cansat-tsniimash/UNKNOWN-2024/doc/KNPN_block diagram of on-board electronics (2).pdf

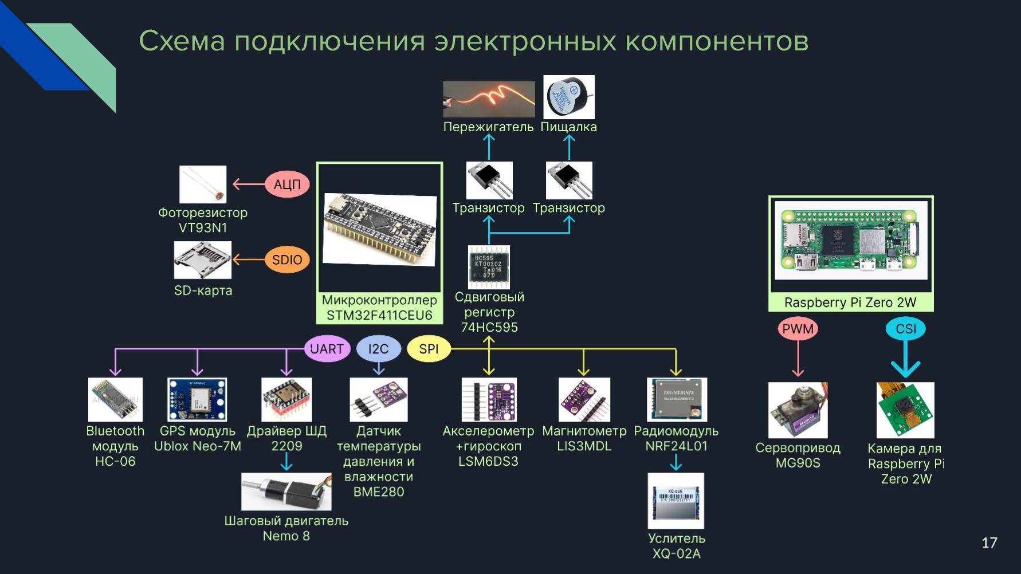
[picture p3: page 1]

17

Схема подключения электронных компонентов

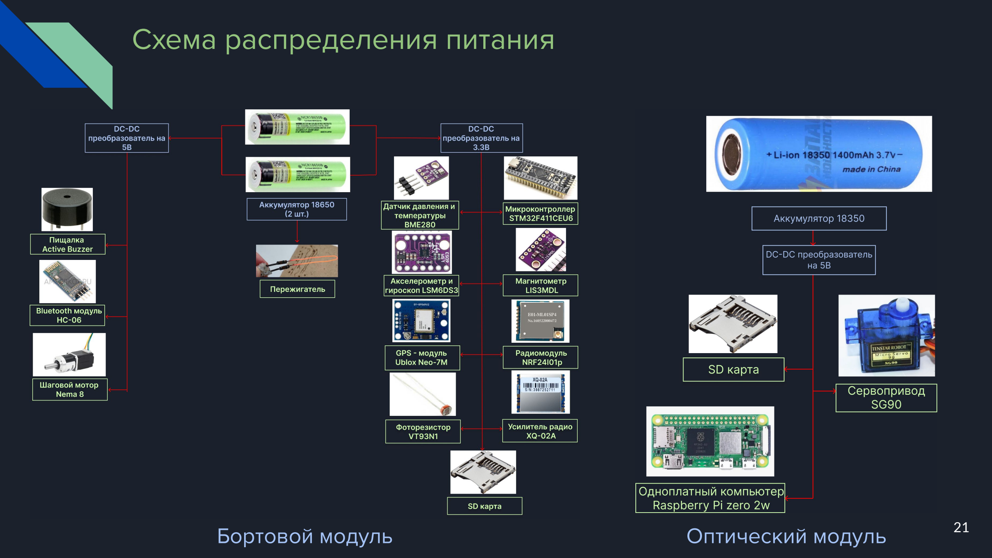
[picture p4: page 2]

21

Схема распределения питания

Бортовой модуль | Оптический модуль
