cansat-tsniimash/UNKNOWN-2024/doc/KNPN_algorithm+cyclogram.pdf

# Алгоритм работы аппарата

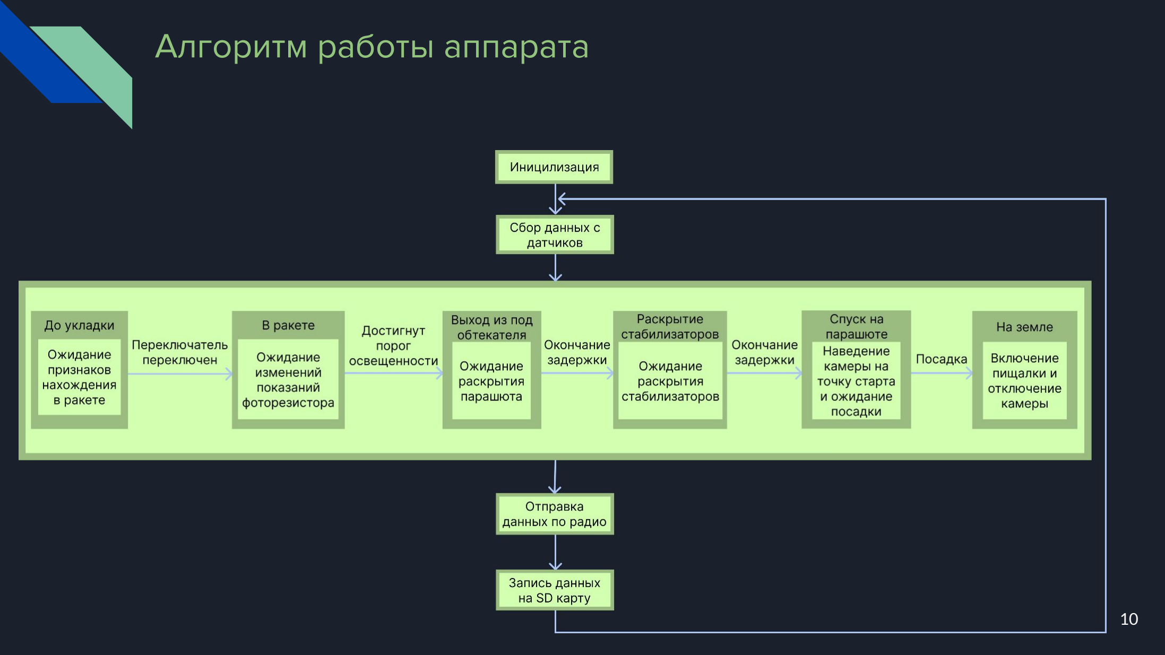
[picture p32: page 1]

10

Состояния | До укладки | В ракете | Выход из под обтекателя | Раскрытие стабилизаторов | Спуск на парашюте | На земле
| | | Фиксация начальных значений давления и освещенности | Задержка 10 секунд | Ожидание засветки фоторезистора | Ожидание раскрытия парашюта | Ожидание раскрытия стабилизаторов | Ожидание приземления | Включение пищалки и отключение камеры
| | | Ожидание перевода переключателя в режим полета

Аппарат

Система управления

Система измерения | | Проведение измерений датчиковой аппаратурой
Система | | Снабжение электроэнергией компонентов аппарата
Система спасения | | | Раскрытие парашюта | Раскрытие стабилизаторов
Наведения и видеозаписи | | Связь по Bluetooth с системой управления
| | | | | Управление сервоприводом
| Видеозапись
Система поиска | | | Работа пищалки
Команда | Рома | Ожидание 5 секунд | Переключение движкового переключателя | Укладка аппарата под обтекатель | Наблюдение за ракетой и аппаратом | Поиск аппарата с помощью поискового устройства
| Илья | Наведение антенны
| Артемий | Прием и контроль телеметрии | | | | Опеределение координат посадки

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
Сбор данных с GPS
Сбор данных с датчиков
Формирование пакетов телеметрии Передача телеметрии по радио Сохранение телеметрии на SD-карту Построение ориентации аппарата Управление шаговым
двигателем

Работа радиомаяка

Связь по Bluetooth с системой наведения и видеозаписи
