cansat-tsniimash/UNKNOWN-2024/doc/KNPN_parashute_calculation.pdf

## Расчет парашюта

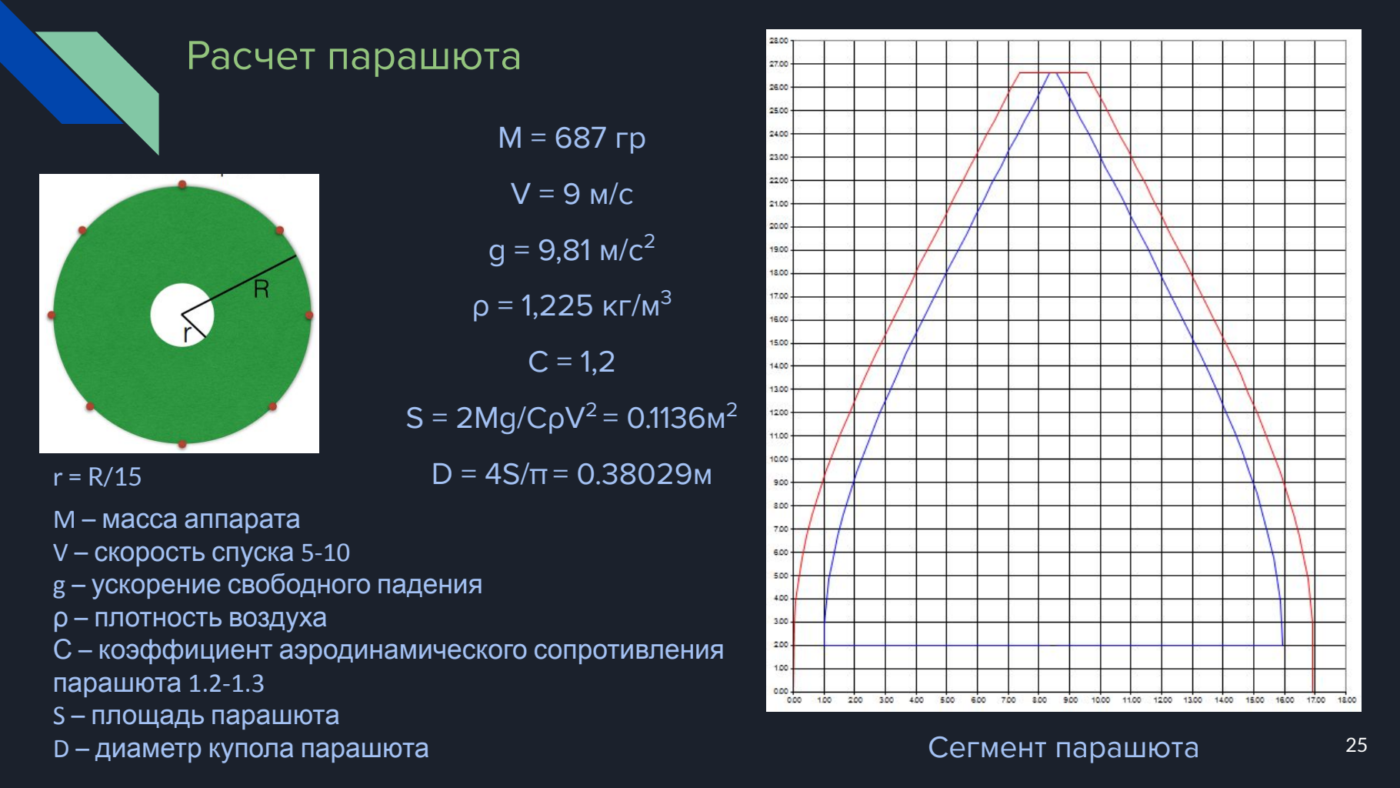
[picture p33: page 1]

25

M – масса аппарата
V – скорость спуска 5-10
g – ускорение свободного падения
ρ – плотность воздуха
С – коэффициент аэродинамического сопротивления парашюта 1.2-1.3
S – площадь парашюта
D – диаметр купола парашюта

### M = 687 гр

### V = 9 м/с

### g = 9,81 м/с²

### ρ = 1,225 кг/м³

C = 1,2

### S = 2Mg/CρV² = 0.1136м²

r = R/15 | D = 4S/π = 0.38029м

### Сегмент парашюта
