cansat-tsniimash/UNKNOWN-2024/doc/кот.gif

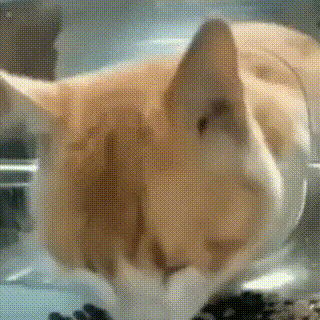
doc/кот.gif
