cansat-tsniimash/UNKNOWN-2024/doc/системы.png

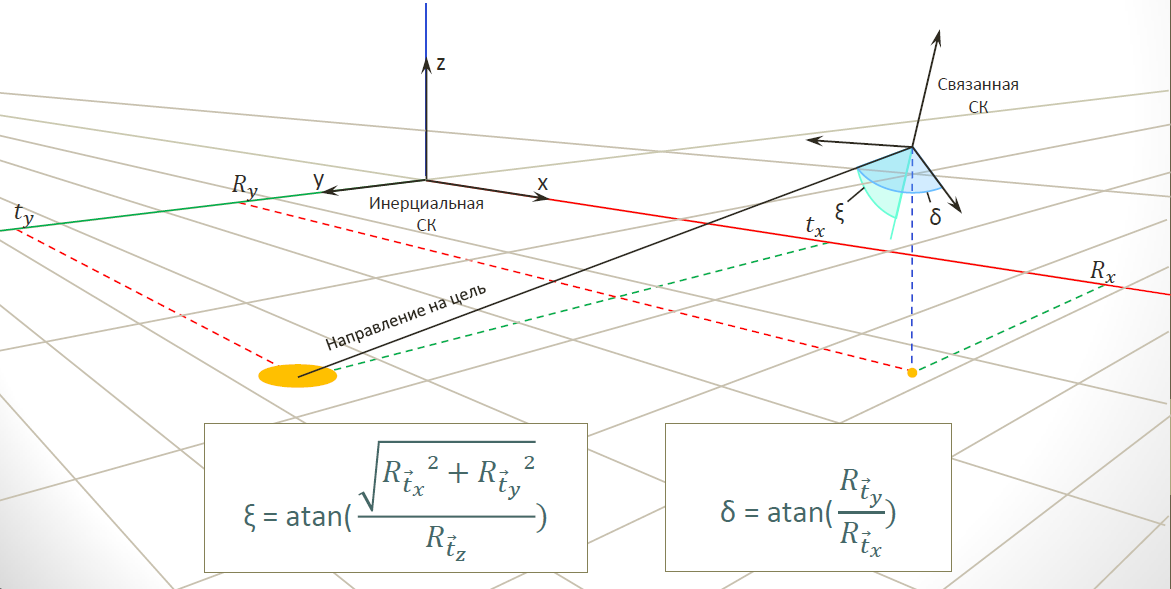
doc/системы.png
