cansat-tsniimash/UNKNOWN-2024/doc/системы_negate.png

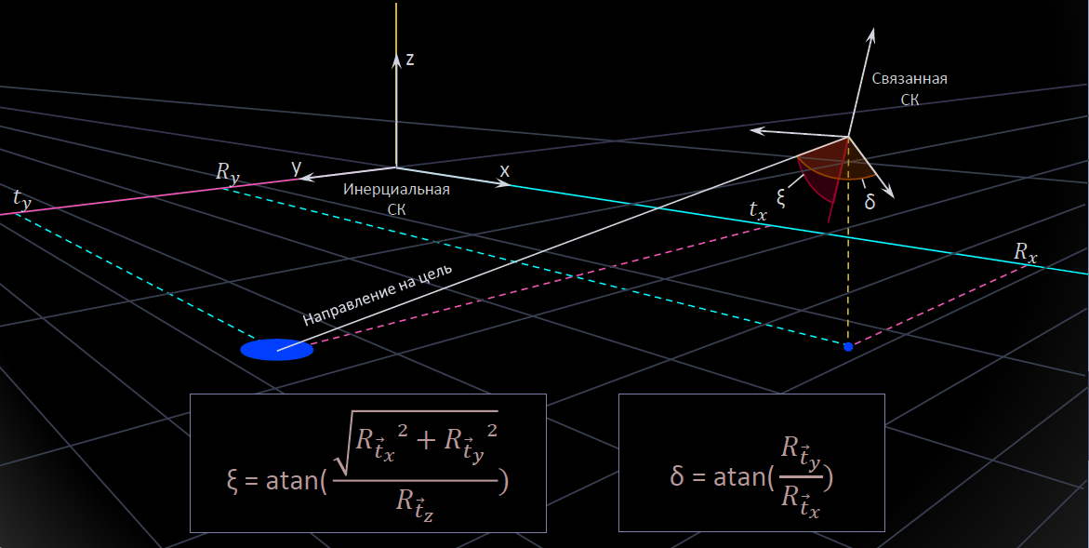
doc/системы_negate.png
