cansat-tsniimash/UNKNOWN-2024/doc/сфера для положения.png

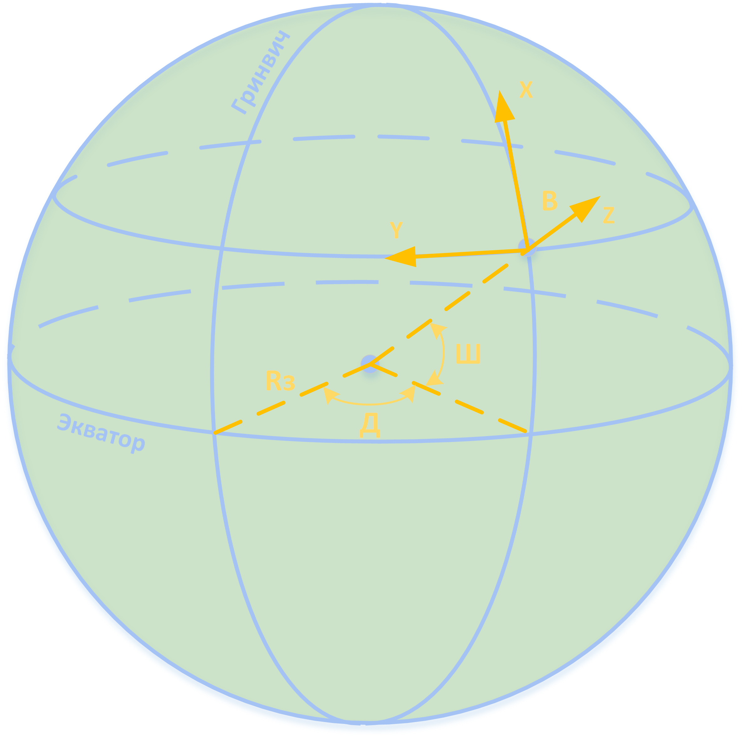
doc/сфера для положения.png
