cansat-tsniimash/UNKNOWN-2024/Снимок экрана 2024-05-22 184523.png

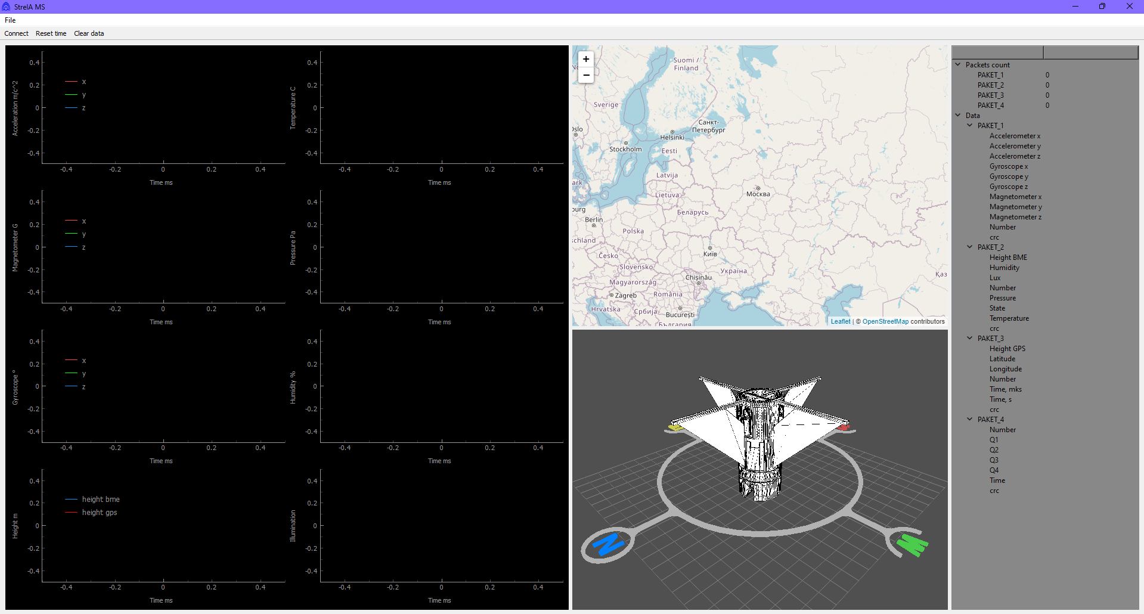
Снимок экрана 2024-05-22 184523.png
