cansat-tsniimash/UNKNOWN-2024/список.xlsx

Sheet: Лист1
Позиция | Наименование | Кол-во | Отметка
1 | веревка синяя | 70м
2 | аккумулятор радиомаяк | 2
3 | подшипник | 1
4 | дсдс преобразователи mp1584 | 4
5 | палки(без стабилизаторов) | 4
6 | распбери пи | 1
7 | магнитометр | 2
8 | бме280 | 2
9 | камера распбери | 1
10 | мк | 3
11 | сервопривод | 1
12 | клей момент | 1
13 | шлейф для камеры | 2
14 | аккумулятор 18350 | 1
15 | веревка кевлар | 1
16 | крышки отсеков | 6
17 | стабилизаторы | 8
18 | программатор | 1
19 | usb uart | 1
20 | блютуз модуль | 1
21 | дсдс micro usb | 1
22 | пружины | пакетик
23 | какие-то провода | пакетик
24 | ткань стабилизатор | 1
25 | антенна радио | 2
26 | драйвер шд | 1
27 | разъём 2 пина и ответная часть | 5
28 | разъём 4 пина и ответная часть | 2
29 | конструкция для зарядки аккумулятора | 1
30 | красная штука для камеры | 3
31 | плата питания | 1
32 | лютейший аккумулятор 18650 | 1
33 | Приемник tBeacon Findy Lite | 1
34 | sd card | 1
35 | клемник | 2

Sheet: Лист2
Позиция | Наименование | Кол-во | Отметка
1 | Пинцет | 3
2 | Термоклей | 1
3 | Кусачки | 3
4 | Плоскогубцы | 3
5 | Отвёрткa | 2
6 | Паяльник | 1
7 | Припой | 1
8 | Флюс | 1
9 | Мультиметр | 2
10 | Кабель наземки | 2
11 | Powerbank | 2
12 | Нихромовая проволока 0.2 | 10м
13
14
15
16
