cansat-tsniimash/UNKNOWN-2024/construction/cansat.stl

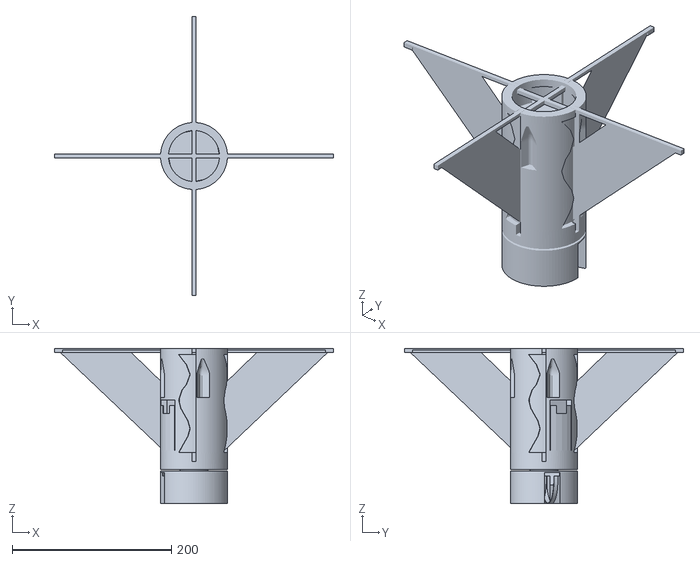
[picture p41: CAD file, 2024-05-11]
construction/cansat.stl
350.0 x 350.0 x 195.0
