cansat-tsniimash/UNKNOWN-2024/construction/DXF/board_ears_photo.dxf

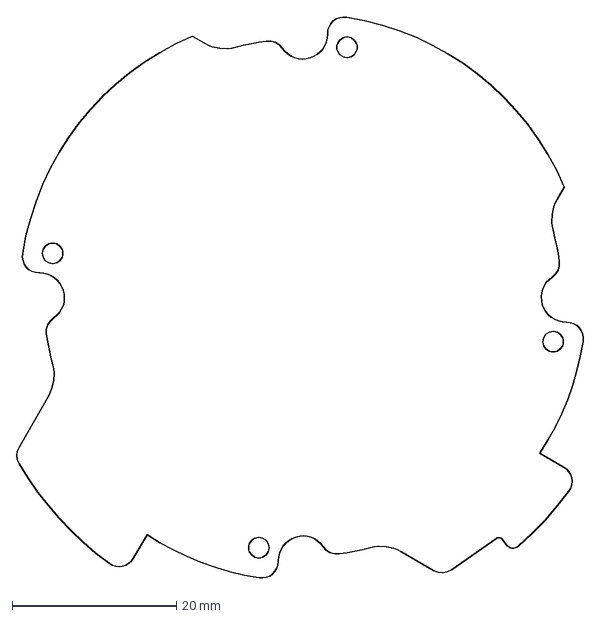
[picture p42: CAD file, 2024-02-28]
construction/DXF/board_ears_photo.dxf
69.1 x 68.4 mm
