cansat-tsniimash/UNKNOWN-2024/construction/sat/optical_base.stl

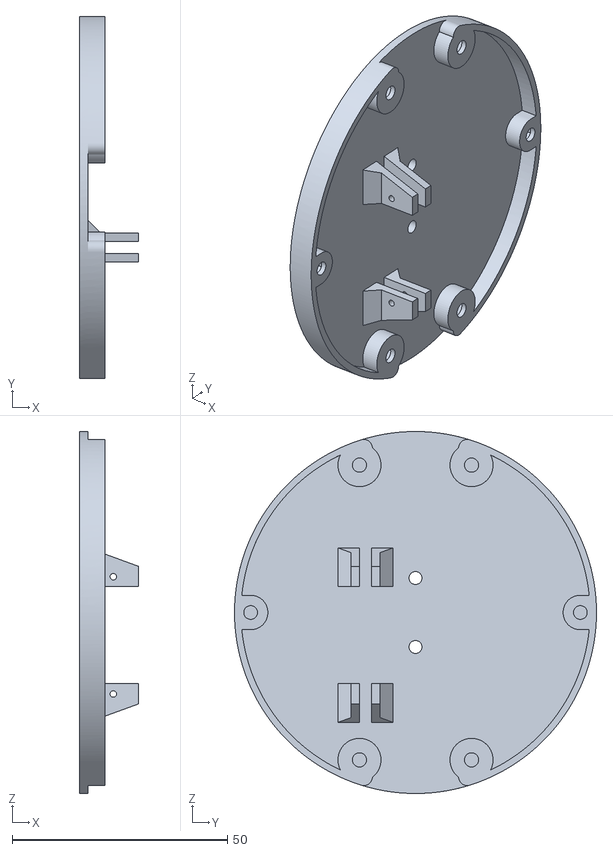
[picture p43: CAD file, 2024-06-08]
construction/sat/optical_base.stl
13.8 x 84.0 x 84.0
