cansat-tsniimash/UNKNOWN-2024/test/plane3D/kopia_litaka.stl

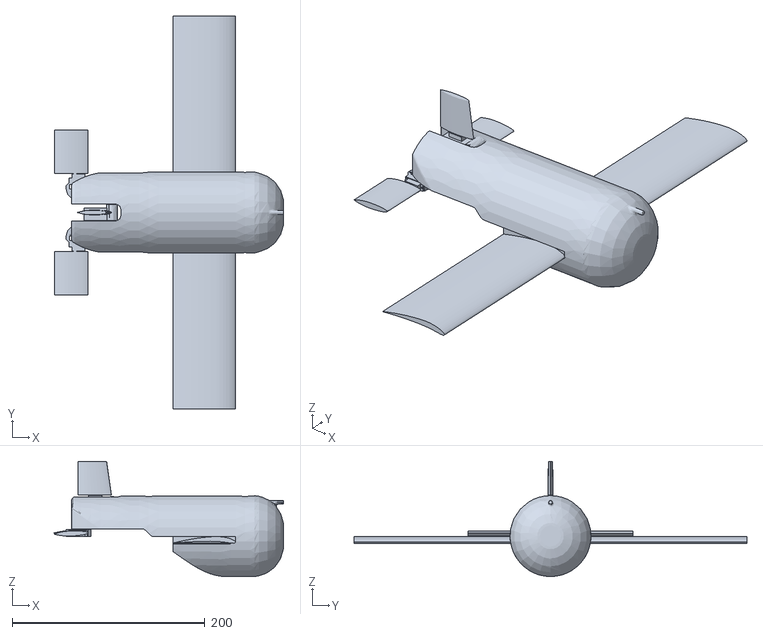
[picture p44: CAD file, 2024-01-31]
test/plane3D/kopia_litaka.stl
237.9 x 408.0 x 119.4
