cansat-tsniimash/UNKNOWN-2024/construction/DXF/board_restrict.dxf

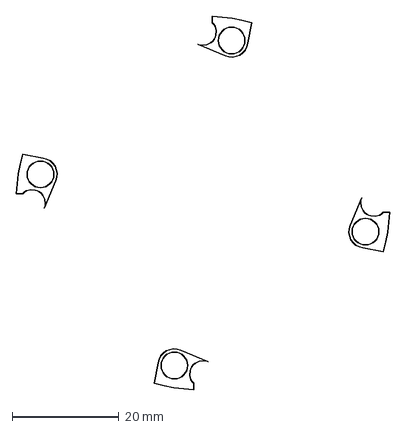
[picture p45: CAD file, 2024-02-28]
construction/DXF/board_restrict.dxf
69.9 x 69.9 mm
