cansat-tsniimash/UNKNOWN-2024/construction/plata_dxf.dxf

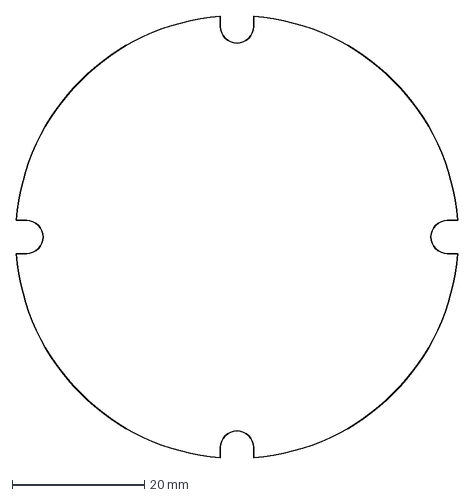
[picture p46: CAD file, 2024-01-07]
construction/plata_dxf.dxf
66.8 x 66.8 mm
