cansat-tsniimash/UNKNOWN-2024/construction/sat/korpus_top.stl

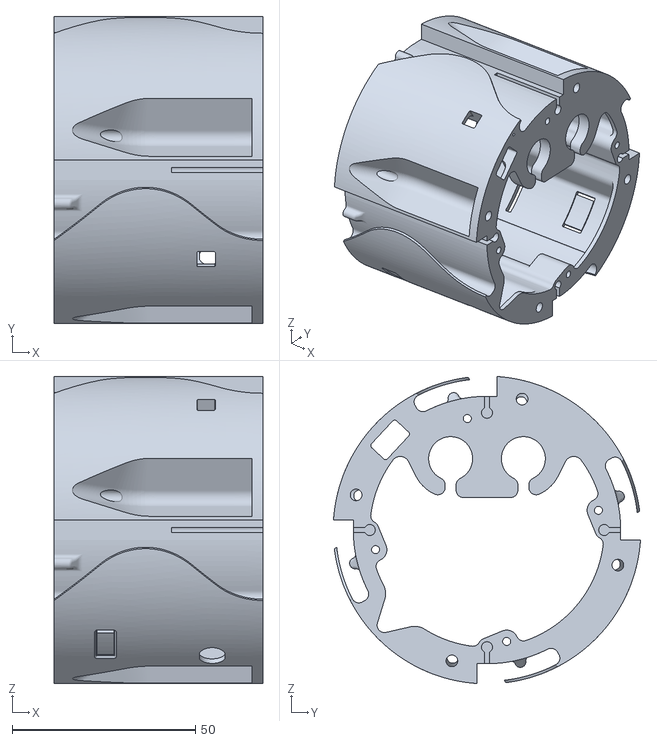
[picture p47: CAD file, 2024-06-05]
construction/sat/korpus_top.stl
57.0 x 83.8 x 83.8
