cansat-tsniimash/UNKNOWN-2024/src/strela/StrelA-MS/source/models/CanCubeSat-2-for-GKS.stl

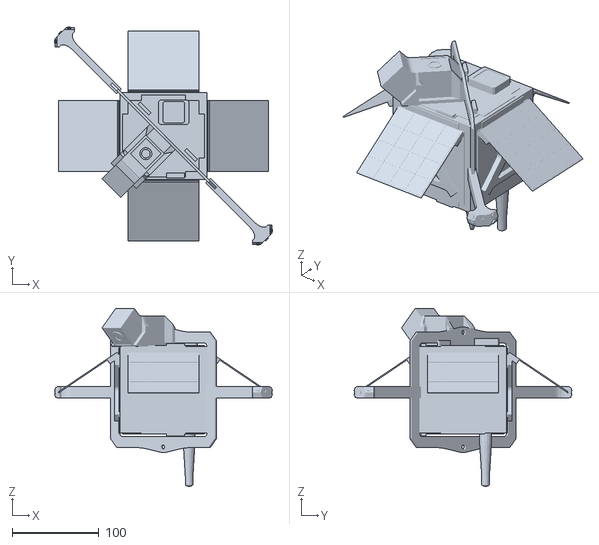
[picture p48: CAD file, 2024-05-11]
src/strela/StrelA-MS/source/models/CanCubeSat-2-for-GKS.stl
251.1 x 251.1 x 205.0
