cansat-tsniimash/UNKNOWN-2024/construction/DXF/board_ears.dxf

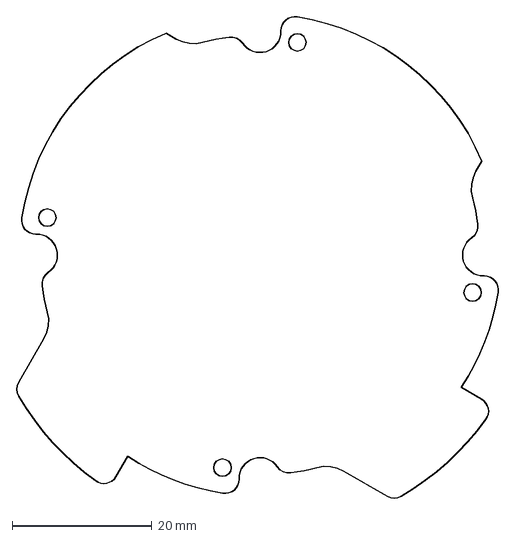
[picture p49: CAD file, 2024-02-10]
construction/DXF/board_ears.dxf
69.1 x 69.1 mm
