cansat-tsniimash/UNKNOWN-2024/construction/sat/korpus_bottom.stl

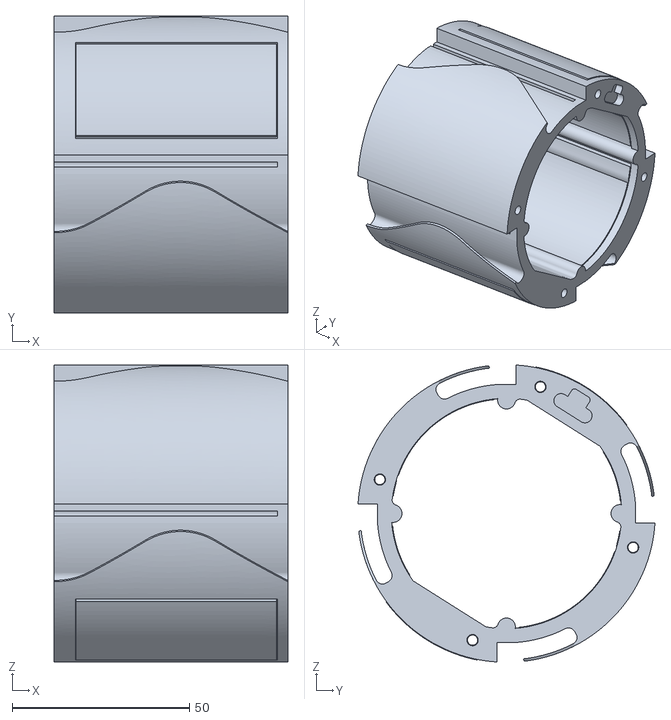
[picture p50: CAD file, 2024-05-11]
construction/sat/korpus_bottom.stl
66.0 x 83.8 x 83.8
