cansat-tsniimash/UNKNOWN-2024/src/strela/StrelA-MS/source/models/axis.stl

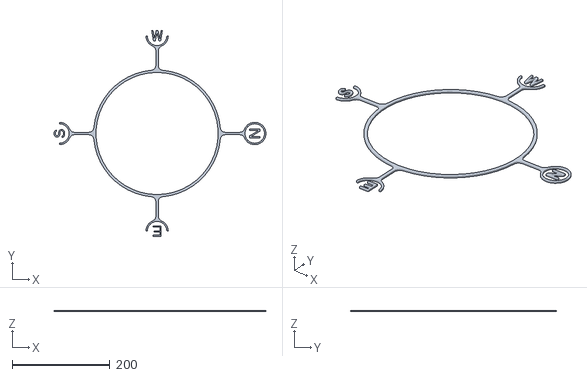
[picture p51: CAD file, 2024-05-11]
src/strela/StrelA-MS/source/models/axis.stl
434.0 x 422.0 x 3.00
