cansat-tsniimash/UNKNOWN-2024/construction/DXF/board.dxf

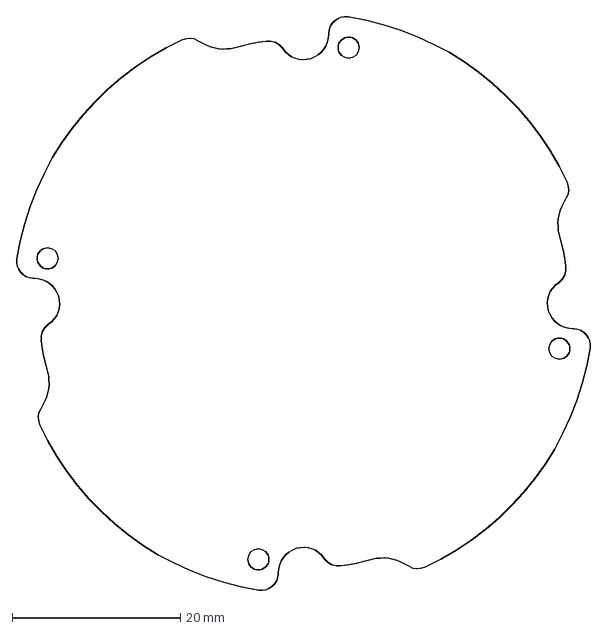
[picture p52: CAD file, 2024-02-10]
construction/DXF/board.dxf
68.4 x 68.4 mm
