cansat-tsniimash/UNKNOWN-2024/construction/sat/optical_base_raspberry.stl

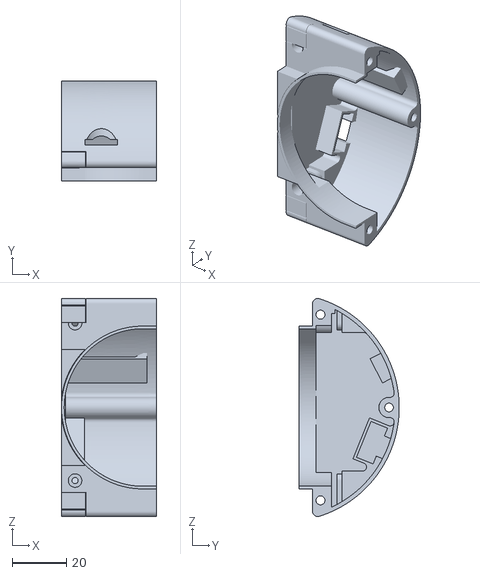
[picture p53: CAD file, 2024-05-11]
construction/sat/optical_base_raspberry.stl
35.0 x 37.0 x 80.3
