cansat-tsniimash/UNKNOWN-2024/src/strela/StrelA-MS/source/models/CanCubeSat-for-GKS.stl

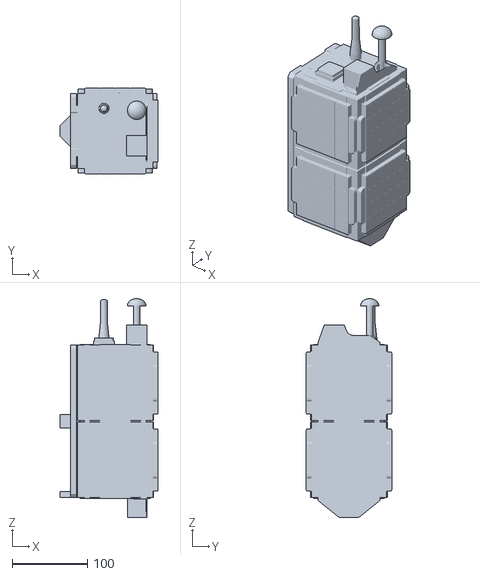
[picture p54: CAD file, 2024-05-11]
src/strela/StrelA-MS/source/models/CanCubeSat-for-GKS.stl
130.5 x 113.9 x 290.7
