cansat-tsniimash/UNKNOWN-2024/construction/sat/korpus_base.stl

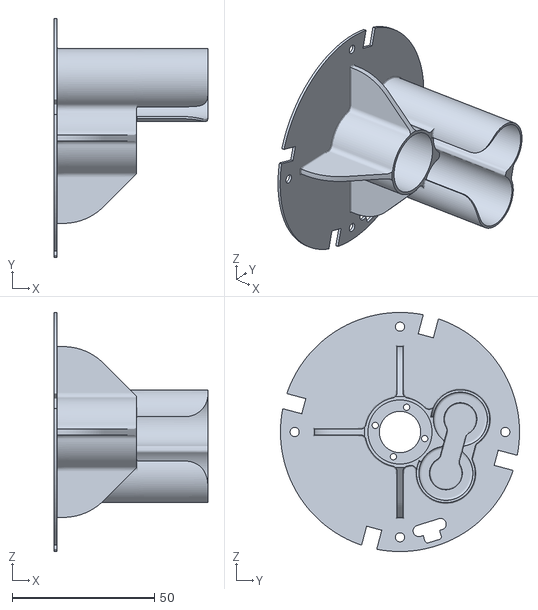
[picture p55: CAD file, 2024-05-11]
construction/sat/korpus_base.stl
54.0 x 84.0 x 84.0
