cansat-tsniimash/UNKNOWN-2024/construction/sat/bearing_korpus.stl

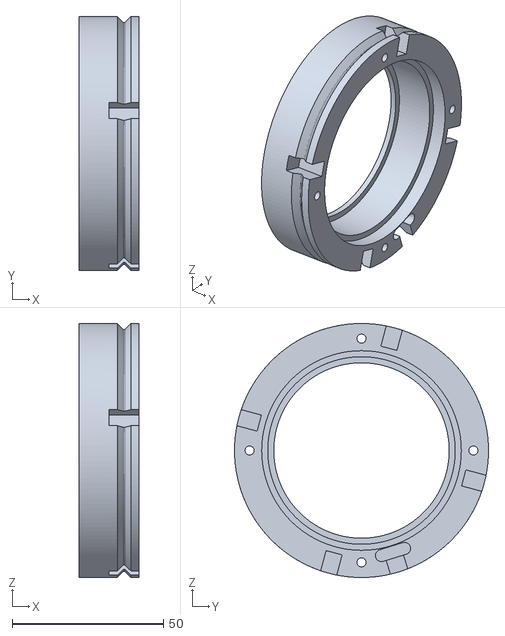
[picture p56: CAD file, 2024-05-11]
construction/sat/bearing_korpus.stl
20.0 x 84.0 x 84.0
