cansat-tsniimash/UNKNOWN-2024/construction/sat/optical_base_accum.stl

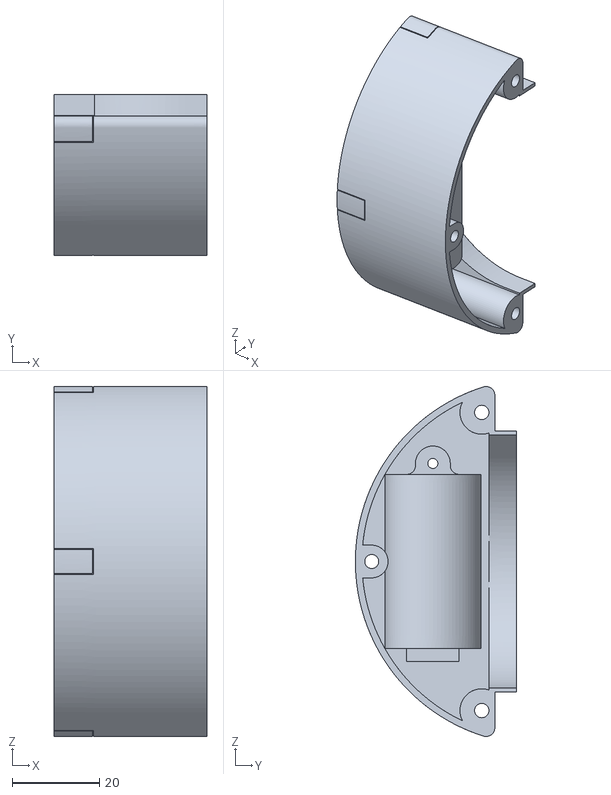
[picture p57: CAD file, 2024-04-19]
construction/sat/optical_base_accum.stl
35.0 x 37.0 x 80.3
