cansat-tsniimash/UNKNOWN-2024/construction/sat/kernel_parashute.stl

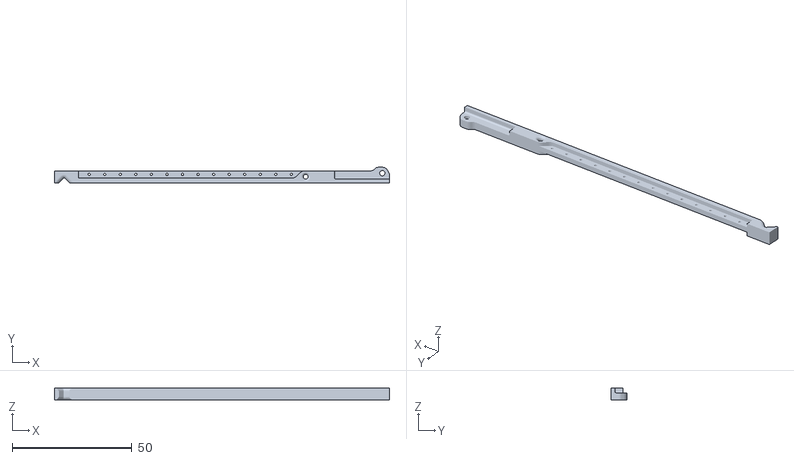
[picture p58: CAD file, 2024-04-19]
construction/sat/kernel_parashute.stl
140.0 x 6.50 x 5.00
