cansat-tsniimash/UNKNOWN-2024/construction/sat/cover_accum.stl

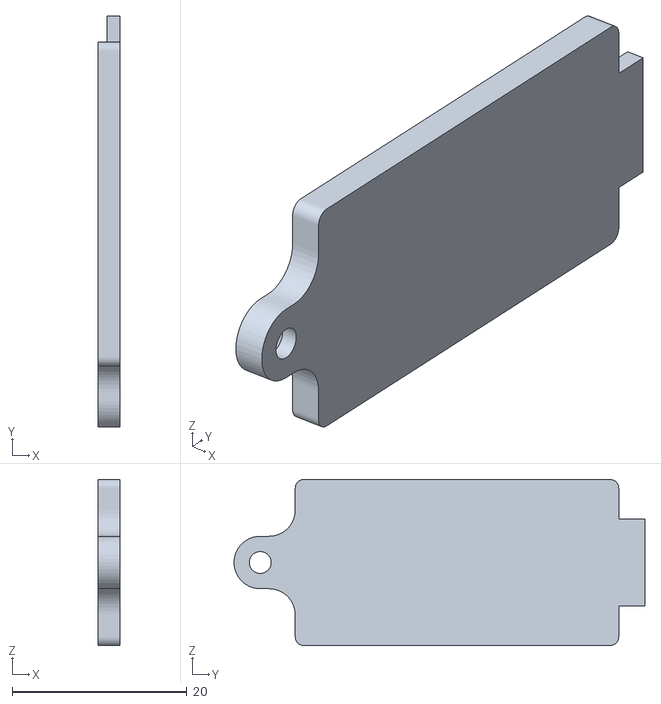
[picture p59: CAD file, 2024-04-19]
construction/sat/cover_accum.stl
2.50 x 47.0 x 19.0
