cansat-tsniimash/UNKNOWN-2024/construction/sat/camera_base.stl

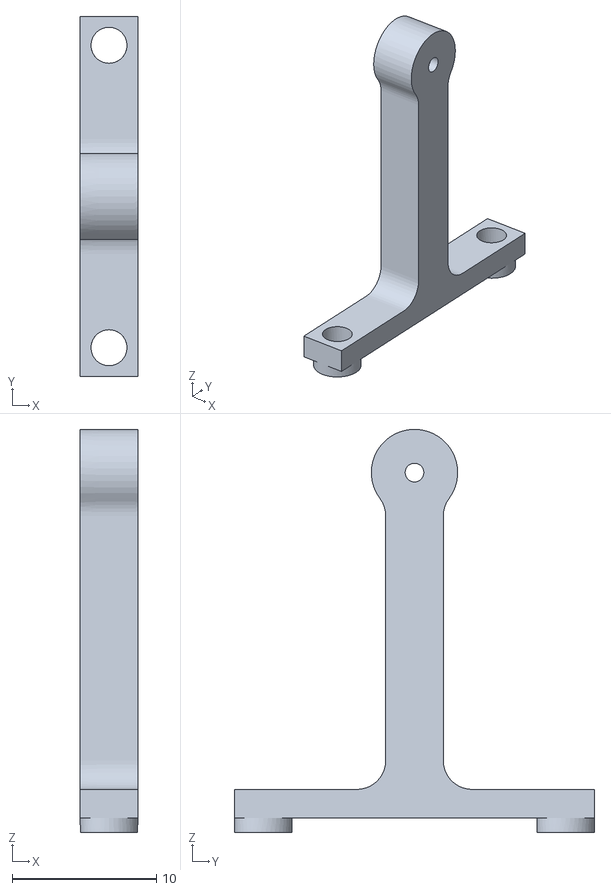
[picture p60: CAD file, 2024-04-10]
construction/sat/camera_base.stl
4.00 x 25.0 x 28.0
