cansat-tsniimash/UNKNOWN-2024/construction/sat/ring_down.stl

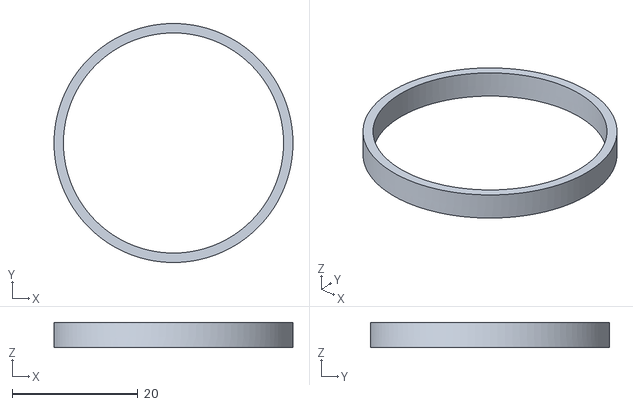
[picture p61: CAD file, 2024-03-21]
construction/sat/ring_down.stl
38.0 x 38.0 x 4.00
