cansat-tsniimash/UNKNOWN-2024/construction/sat/bearing_shaft.stl

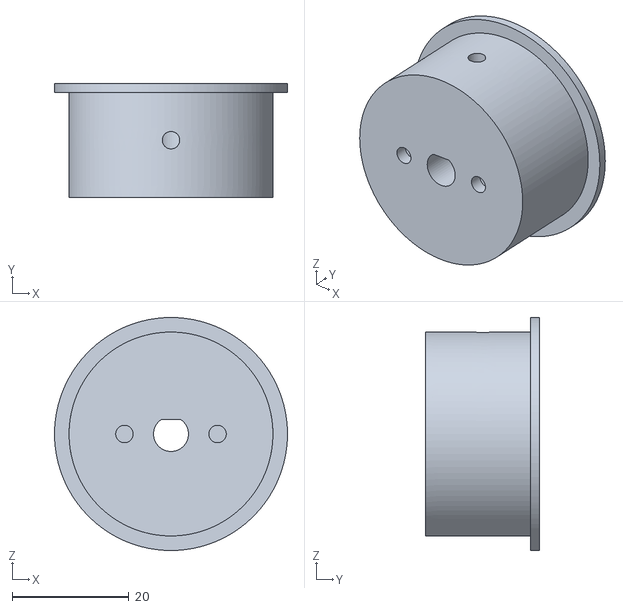
[picture p62: CAD file, 2024-03-21]
construction/sat/bearing_shaft.stl
40.0 x 19.5 x 40.0
