cansat-tsniimash/UNKNOWN-2024/construction/sat/ring_up.stl

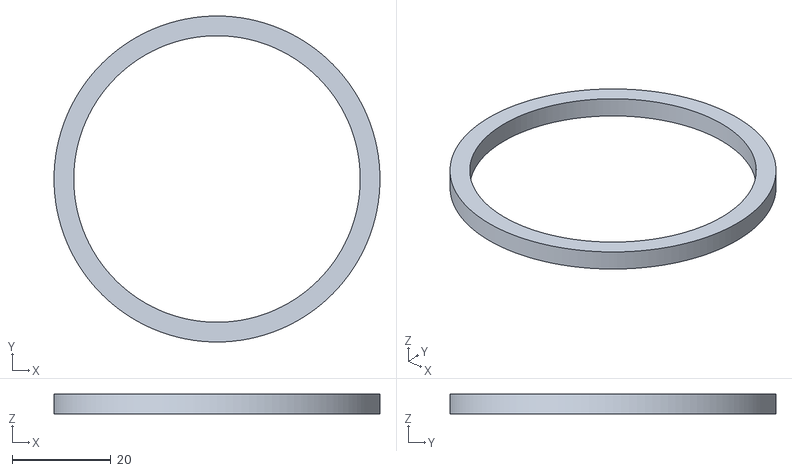
[picture p63: CAD file, 2024-03-21]
construction/sat/ring_up.stl
66.0 x 66.0 x 4.00
