cansat-tsniimash/UNKNOWN-2024/construction/sat/korpus_top123.stl

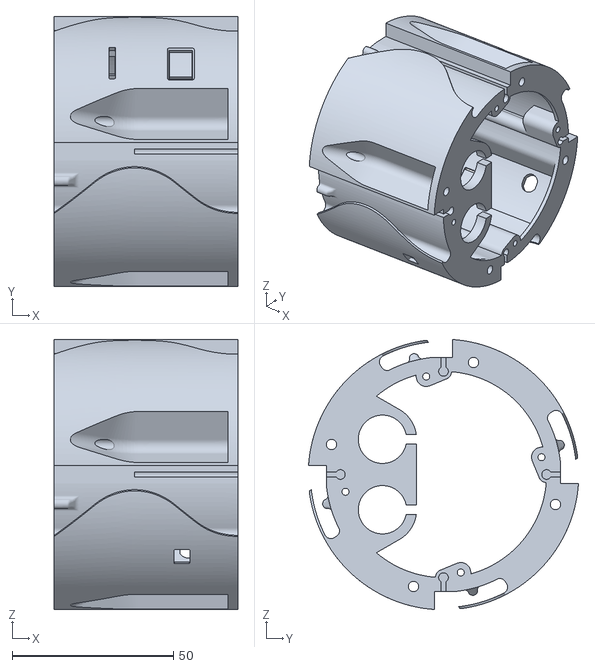
[picture p64: CAD file, 2024-03-16]
construction/sat/korpus_top123.stl
57.0 x 83.8 x 83.8
