cansat-tsniimash/UNKNOWN-2024/construction/sat/stab_korpus.stl

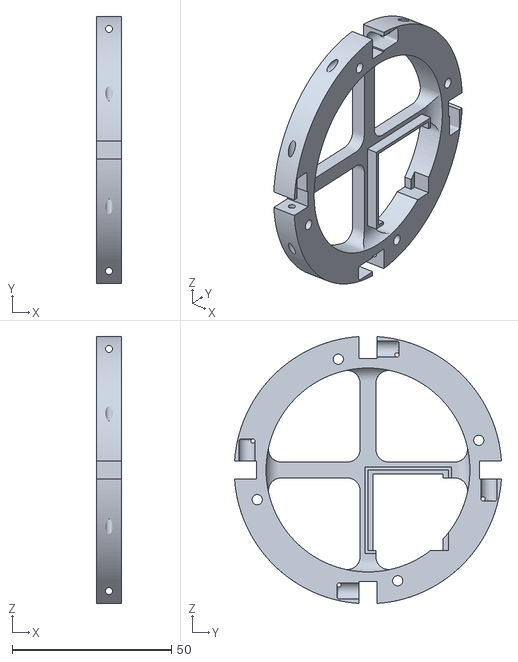
[picture p65: CAD file, 2024-03-16]
construction/sat/stab_korpus.stl
8.00 x 83.8 x 83.8
