cansat-tsniimash/UNKNOWN-2024/construction/sat/covers-print.stl

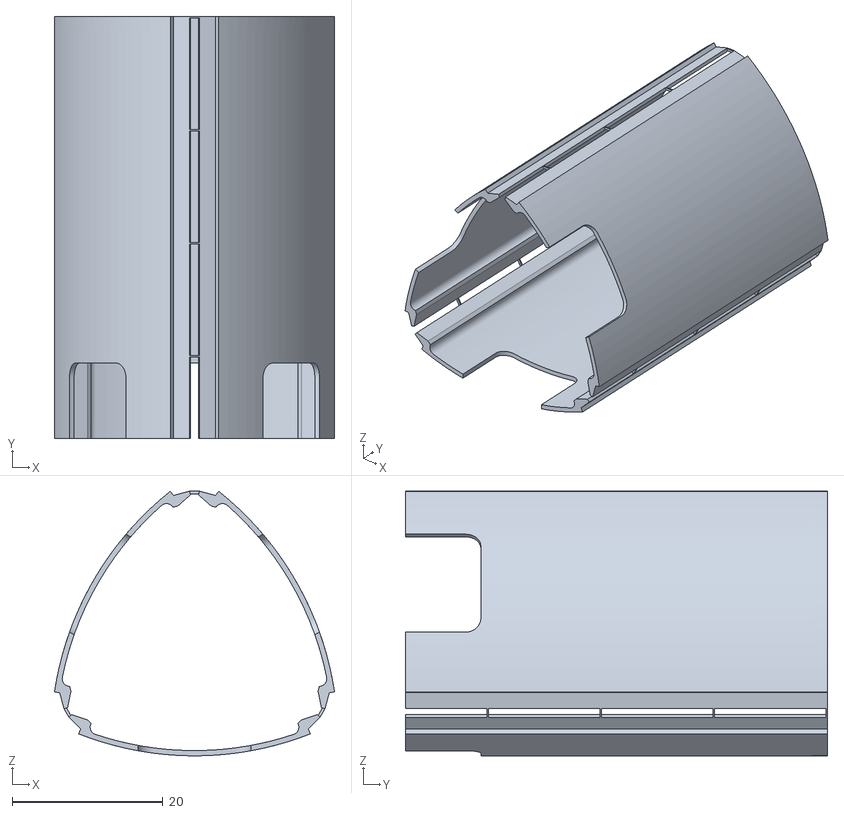
[picture p66: CAD file, 2024-03-02]
construction/sat/covers-print.stl
37.2 x 56.0 x 35.1
