cansat-tsniimash/UNKNOWN-2024/construction/sat/cover_korpus.stl

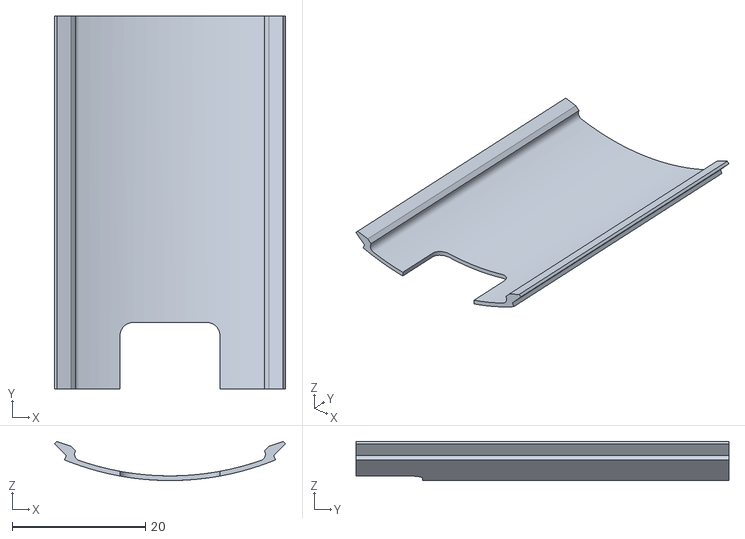
[picture p67: CAD file, 2024-02-24]
construction/sat/cover_korpus.stl
34.7 x 56.0 x 5.87
