cansat-tsniimash/UNKNOWN-2024/construction/sat/plata_maket.dxf

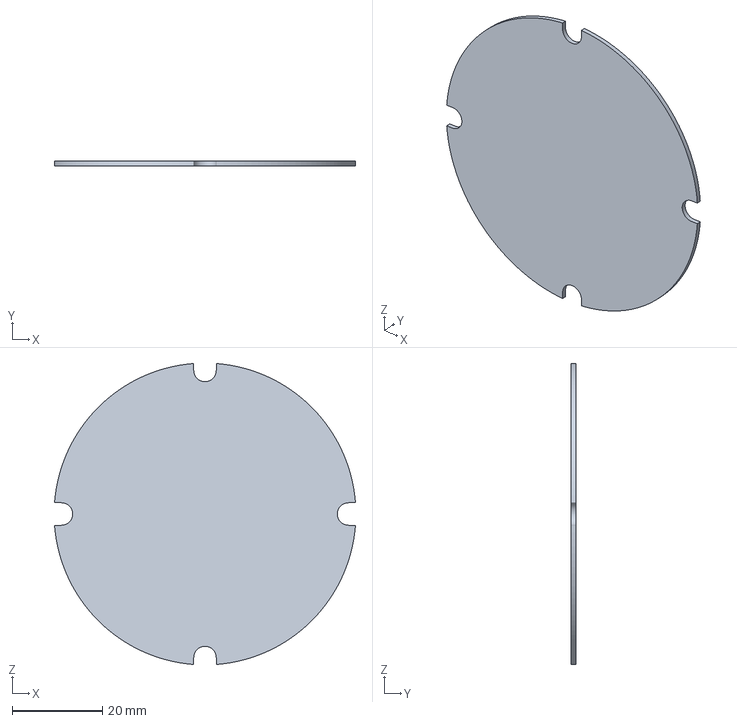
[picture p68: CAD file, 2023-12-27]
construction/sat/plata_maket.dxf
66.8 x 1.00 x 66.8 mm
