cansat-tsniimash/UNKNOWN-2024/construction/sat/drw0001.dxf

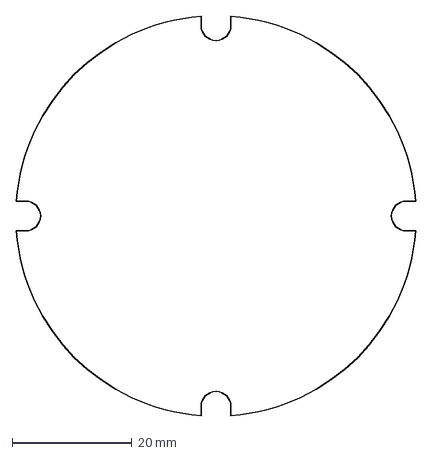
[picture p69: CAD file, 2023-12-27]
construction/sat/drw0001.dxf
66.8 x 66.8 mm
