cansat-tsniimash/UNKNOWN-2024/(list of files, cad)

Other CAD files:
construction/sat/korpus_topqwertyuiop.stl
construction/sat/stab_korpus2.stl
construction/korpus_bottom.prt
construction/korpus_top.prt
construction/sat gks/bearing.prt
construction/sat gks/bearing_korpus.prt
construction/sat gks/bearing_shaft.prt
construction/sat gks/board.prt
construction/sat gks/camera_rasberry.prt
construction/sat gks/cover_accum.prt
construction/sat gks/cover_korpus.prt
construction/sat gks/kernel_parashute.prt
construction/sat gks/korpus_base.prt
construction/sat gks/korpus_bottom.prt
construction/sat gks/korpus_top.prt
construction/sat gks/optical_base.prt
construction/sat gks/optical_base_accum.prt
construction/sat gks/optical_base_raspberry.prt
construction/sat gks/stab_korpus.prt
construction/sat gks/tkan.prt
construction/sat/4eto_niz_hz.prt
construction/sat/74hc595t16.prt
construction/sat/accum_18350.prt
construction/sat/accum_18650.prt
construction/sat/air-valve.prt
construction/sat/akb_tbeacon.prt
construction/sat/amplifier_xq-02a.prt
construction/sat/antenna_gps-slim.prt
construction/sat/apparat_skel.prt
construction/sat/axe_2mm.prt
construction/sat/banka_dla_sbrosa.prt
construction/sat/barometer_bmp280_module.prt
construction/sat/beacon_mini_rockwell_ibeacon.prt
construction/sat/bearing.prt
construction/sat/bearing_korpus.prt
construction/sat/bearing_shaft.prt
construction/sat/blin_s_otverstiem.prt
construction/sat/bluetooth_hc-06.prt
construction/sat/bme280_board.prt
construction/sat/board.prt
construction/sat/brusock.prt
construction/sat/buzzer.prt
construction/sat/camera-sq11.prt
construction/sat/camera_base.prt
construction/sat/camera_rasberry.prt
construction/sat/cloth.prt
construction/sat/connector-pls-20.prt
construction/sat/connector-pls-4.prt
construction/sat/connector-pls-5d.prt
construction/sat/connector_b2b-eh-a.prt
construction/sat/connector_pbs-smd.prt
construction/sat/connector_pls-smd.prt
construction/sat/connector_smd_female.prt
construction/sat/connector_smd_male.prt
construction/sat/cover_accum.prt
construction/sat/cover_korpus.prt
construction/sat/covers-connector.prt
construction/sat/dc-dc_1584.prt
construction/sat/dc_dc.prt
construction/sat/dcdc_mt3608_usb.prt
construction/sat/derzhatel_kameru.prt
construction/sat/detal_dla_sbrosa.prt
construction/sat/detal_dla_sbrosa2.prt
construction/sat/detal_dla_sbrosa_2.prt
construction/sat/detal_dlya_raskritiya_parashuya.prt
construction/sat/dop_connector.prt
construction/sat/driver_tmc2209.prt
construction/sat/ecap220-cmd.prt
construction/sat/gerobem.prt
construction/sat/gps_antena.prt
construction/sat/gps_antenna.prt
construction/sat/gps_ublox_neo-6m.prt
construction/sat/gps_ublox_neo-7m.prt
construction/sat/gpska.prt
construction/sat/granica.prt
construction/sat/hc-06.prt
construction/sat/incinerator_holder.prt
construction/sat/kernel_parashute.prt
construction/sat/knopka.prt
construction/sat/kompressor.prt
construction/sat/korpus_base.prt
construction/sat/korpus_bottom.prt
construction/sat/korpus_top.prt
construction/sat/krishka.prt
construction/sat/krug_s_otverstiem.prt
construction/sat/lis3mdl_board.prt
construction/sat/lsm6ds3_board.prt
construction/sat/mal_sterzhen.prt
construction/sat/mexanism_chtobu_cheka.prt
construction/sat/micro-sd_module_robotdyn.prt
construction/sat/microsd_connector.prt
construction/sat/mics-6814.prt
construction/sat/motor-1axis.prt
construction/sat/motor_dla_lopostei.prt
construction/sat/mq2.prt
construction/sat/mt3608.prt
construction/sat/nema8_reduct.prt
construction/sat/neo-7m.prt
construction/sat/neo-7m_antenna.prt
construction/sat/noga.prt
construction/sat/nrf24l01.prt
construction/sat/optical_base.prt
construction/sat/optical_base_accum.prt
construction/sat/optical_base_raspberry.prt
construction/sat/palka.prt
construction/sat/palka_dla_parashuta.prt
construction/sat/palka_dla_stabilizatora.prt
construction/sat/palka_parashut.prt
construction/sat/parasek.prt
construction/sat/parashut.prt
construction/sat/photoresistor_vt93n1.prt
construction/sat/platu.prt
construction/sat/ploskost.prt
construction/sat/pms9103m.prt
construction/sat/propeller_krutoi.prt
construction/sat/prostavka.prt
construction/sat/prt0002.prt
construction/sat/prt0005.prt
construction/sat/prt0006.prt
construction/sat/pruzhina.prt
construction/sat/radiator.prt
construction/sat/radio-module_nrf24l01.prt
construction/sat/raspberry_pi_zero_2w.prt
construction/sat/ring_down.prt
construction/sat/ring_up.prt
construction/sat/rocket.prt
construction/sat/rs485.prt
construction/sat/sd_durka.prt
construction/sat/servo_sg90.prt
construction/sat/shashka.prt
construction/sat/skos_dla_motora_niz.prt
construction/sat/skos_dla_motora_verx.prt
construction/sat/spring_0_5x3_5x180deg_6turns.prt
construction/sat/spring_0_8x4x9turns.prt
construction/sat/stab_korpus.prt
construction/sat/stalnoy_sterzhen_6mm.prt
construction/sat/stalnoy_sterzhen_9mm.prt
construction/sat/stershen_dla_parashuta.prt
construction/sat/sterzhen_parashui.prt
construction/sat/sterzken.prt
construction/sat/stm32f411_board.prt
construction/sat/svetoidiot0603.prt
construction/sat/switch_mss-12d01.prt
construction/sat/switch_right_mss12d01.prt
construction/sat/switch_sk12f14.prt
construction/sat/switch_ss-12d10.prt
construction/sat/switch_ss-12d11.prt
construction/sat/tbeacon_onyx.prt
construction/sat/text.prt
construction/sat/trubka4.prt
construction/sat/tzt_sgp30.prt
construction/sat/vt93n1.prt
construction/sat/windgen-vint.prt
construction/sat/xq_02a_usilitel.prt
construction/Модели устройств в Creo/10dof_imu_sensor.prt
construction/Модели устройств в Creo/air-valve.prt
construction/Модели устройств в Creo/antenna_2_4ghz.prt
construction/Модели устройств в Creo/antenna_gps-slim.prt
construction/Модели устройств в Creo/barometer_bmp280_module.prt
construction/Модели устройств в Creo/barometr-ms5611.prt
construction/Модели устройств в Creo/battery_li-pol_lp443442.prt
construction/Модели устройств в Creo/battery_li-pol_lp603450.prt
construction/Модели устройств в Creo/beacon_mini_rockwell_ibeacon.prt
construction/Модели устройств в Creo/bluetooth_hc-05.prt
construction/Модели устройств в Creo/bme280_module.prt
construction/Модели устройств в Creo/camera_sq13.prt
construction/Модели устройств в Creo/connector-pbd-20r.prt
construction/Модели устройств в Creo/connector-pbs-14r.prt
construction/Модели устройств в Creo/connector-pls-20.prt
construction/Модели устройств в Creo/connector-pls-4.prt
construction/Модели устройств в Creo/connector-pls-6.prt
construction/Модели устройств в Creo/connector_usb-type-c.prt
construction/Модели устройств в Creo/dc-dc-boost-converter_u007v.prt
construction/Модели устройств в Creo/dc-dc-boost-converter_xl6019.prt
construction/Модели устройств в Creo/dc-dc-buck-converter_d068v.prt
construction/Модели устройств в Creo/dcdc-lowering.prt
construction/Модели устройств в Creo/dosimeter.prt
construction/Модели устройств в Creo/end-sensor_kw11-3z.prt
construction/Модели устройств в Creo/gcs_battery-indicator.prt
construction/Модели устройств в Creo/gps_antenna.prt
construction/Модели устройств в Creo/gps_ublox_neo-6m.prt
construction/Модели устройств в Creo/gy-lsm6ds3_lsm6ds3.prt
construction/Модели устройств в Creo/ir-photodiode_bpv23nf.prt
construction/Модели устройств в Creo/kompressor-528.prt
construction/Модели устройств в Creo/li-ion-cell_imr26650.prt
construction/Модели устройств в Creo/li-ion-cell_inr18650-25r.prt
construction/Модели устройств в Creo/magnetometer_lis3mdl.prt
construction/Модели устройств в Creo/micro-sd_module_robotdyn.prt
construction/Модели устройств в Creo/microkontroller_esp32-wroom.prt
construction/Модели устройств в Creo/microsd_connector_502774-0891.prt
construction/Модели устройств в Creo/mics-6814.prt
construction/Модели устройств в Creo/motor-reductor.prt
construction/Модели устройств в Creo/onboard-antenna-433mhz.prt
construction/Модели устройств в Creo/oxigen-sensor_me2-o2-f20.prt
construction/Модели устройств в Creo/photoresistor_vt93n1.prt
construction/Модели устройств в Creo/radio-module_nrf24l01.prt
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
