cansat-tsniimash/UNKNOWN-2024/construction/cansat.pdf

Копировал | Формат А4
КНПН.0000-0 ГЧ | Габаритный чертеж
| Сборочные единицы
1 | КНПН.1000-0 | Половина опт. модуля А | 1
2 | КНПН.2000-0 | Половина опт. модуля Б | 1
3 | КНПН.3000-0 | Верхний отсек | 1

Детали

4 | КНПН.0000-1 | Вал подшипника | 1
5 | КНПН.0000-2 | Основа опт. модуля | 1
6 | КНПН.0000-3 | Корпус подшипника | 1
7 | КНПН.0000-4 | Нижнее кольцо | 1
8 | КНПН.0000-5 | Основа борт. модуля | 1
9 | КНПН.0000-6 | Верхнее кольцо | 1
10 | КНПН.0000-7 | Основа видеокамеры | 1
11 | КНПН.0000-8 | Корпус нижнего отсека | 1
12 | КНПН.0000-9 | Крышка | 2
13 | КНПН.0000-11 | Стальной стержень | 4
14 | КНПН.0000-12 | Ткань | 4
15 | КНПН.0000-13 | Пережигатель | 2

Стандартные изделия

Инв. N подл. Подп. и дата Взам. инв. N Инв. N дубл. Подп. и дата Справ. N Перв. примен.

## КНПН.0000-0

Изм. | Лист | N докум. | Подп. | Дата
| | Разраб. | Клишин И.Е. | | Атмосферный зонд | Лит. | Лист | Листов
Пров. | Екимиани | | | | | | 1 | 2
Н. контр. | Команда "КНПН"
Утв. | Черкасова Формат | Зона | Поз.
Обозначение | Наименование | Приме-чание
| Документация

Кол.

16 | Подшипник 80107 | 1
| ГОСТ 7242-81

Прочие изделия

17 | Bluetooth модуль | 1
| HC-05
18 | Аккумулятор | 2
| 18650
19 | Видеокамера | 1
| Raspberry Pi Camera v.2.0
20 | Радиомаяк | 1
| TBEACON-ONYX
21 | Сервомотор | 1
| SG90
22 | Шаговый двигатель с редуктором | 1
| 20HS1405

Материалы

## КНПН.0000-0

Лист

2 Изм. | Лист | N докум. | Подп. | Дата

Инв. N подл. Подп. и дата Взам. инв. N Инв. N дубл. Подп. и дата

Формат
Зона
Поз.

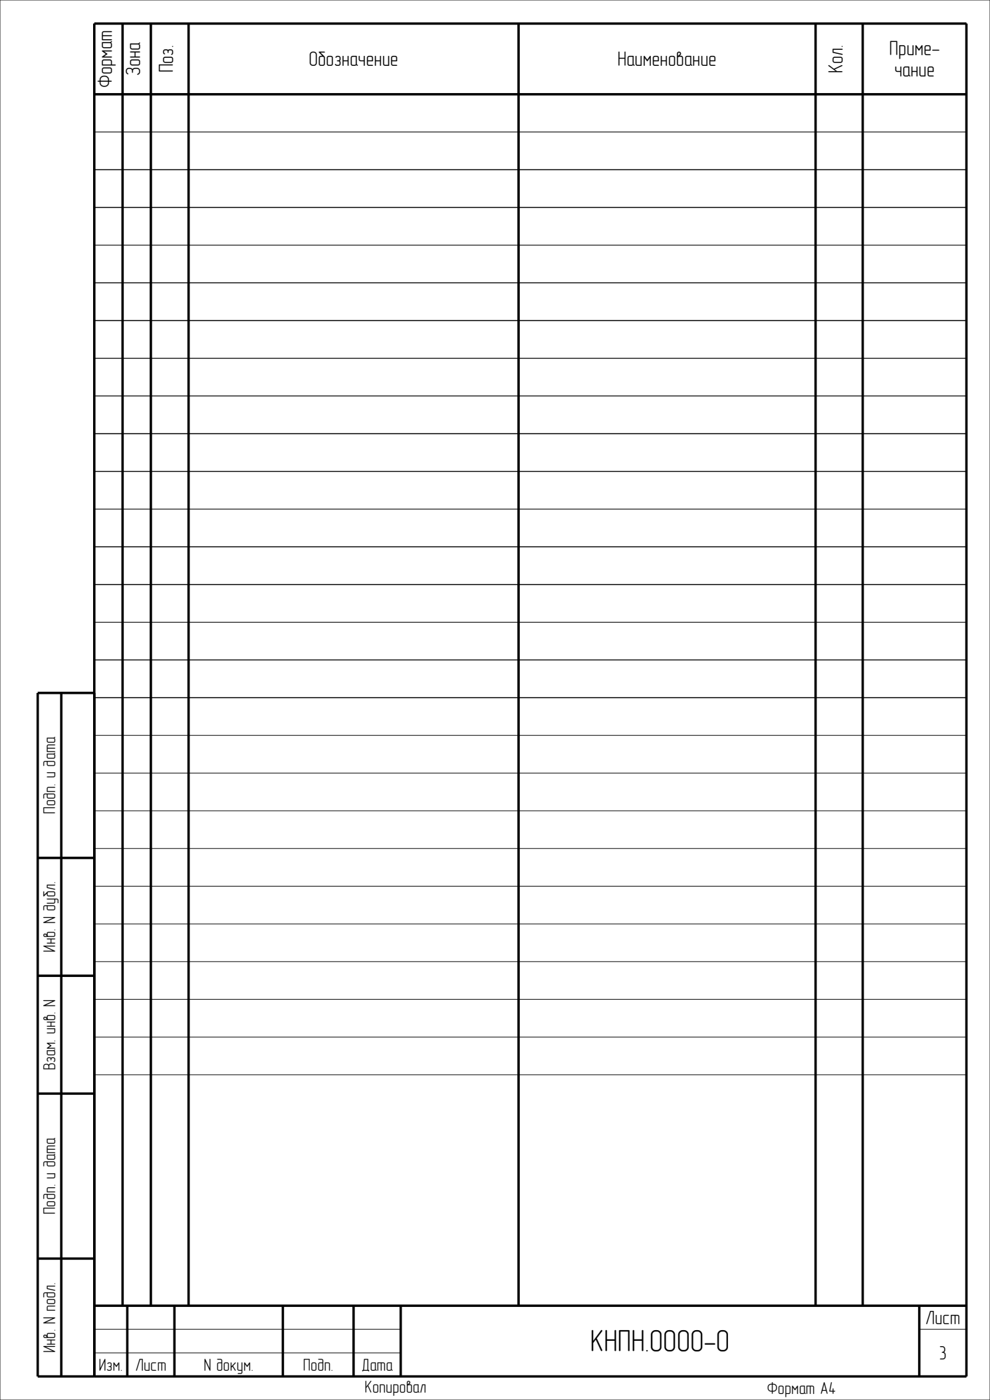
[picture p70: figure]
КНПН.0000-0; Лист; 3 Изм.; N докум.; Подп.; Дата; Формат; Зона; Поз.

Инв. N подл. Подп. и дата Взам. инв. N Инв. N дубл. Подп. и дата
