cansat-tsniimash/UNKNOWN-2024/construction/board_mk123.jpg

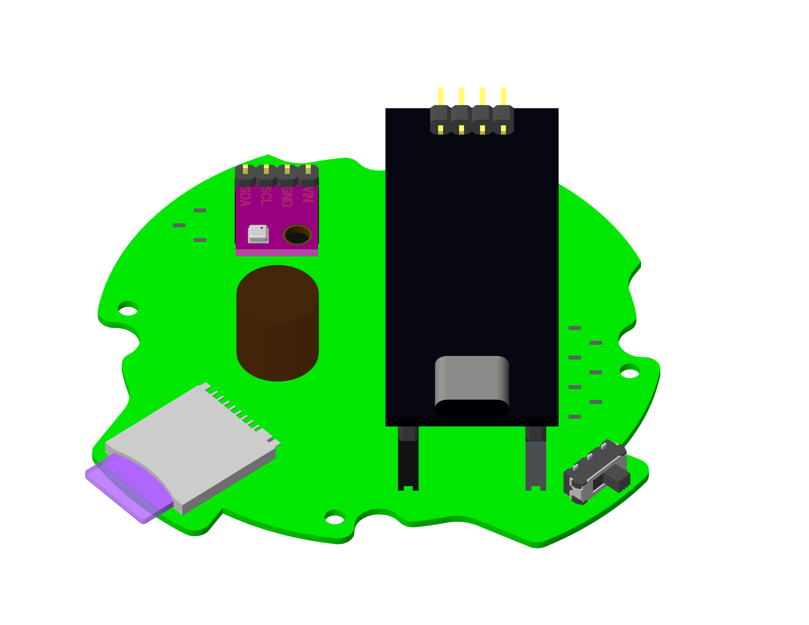
construction/board_mk123.jpg
