cansat-tsniimash/UNKNOWN-2024/construction/board_radio123.jpg

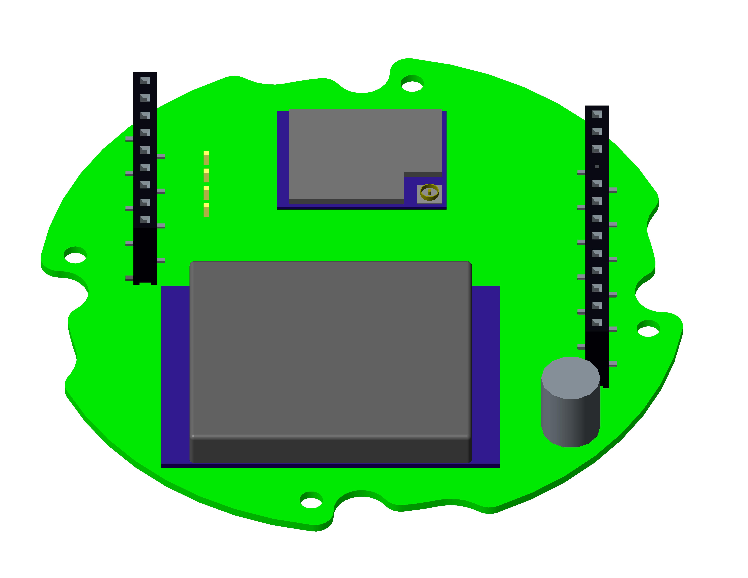
construction/board_radio123.jpg
