cansat-tsniimash/UNKNOWN-2024/construction/board_sensors23456г.jpg

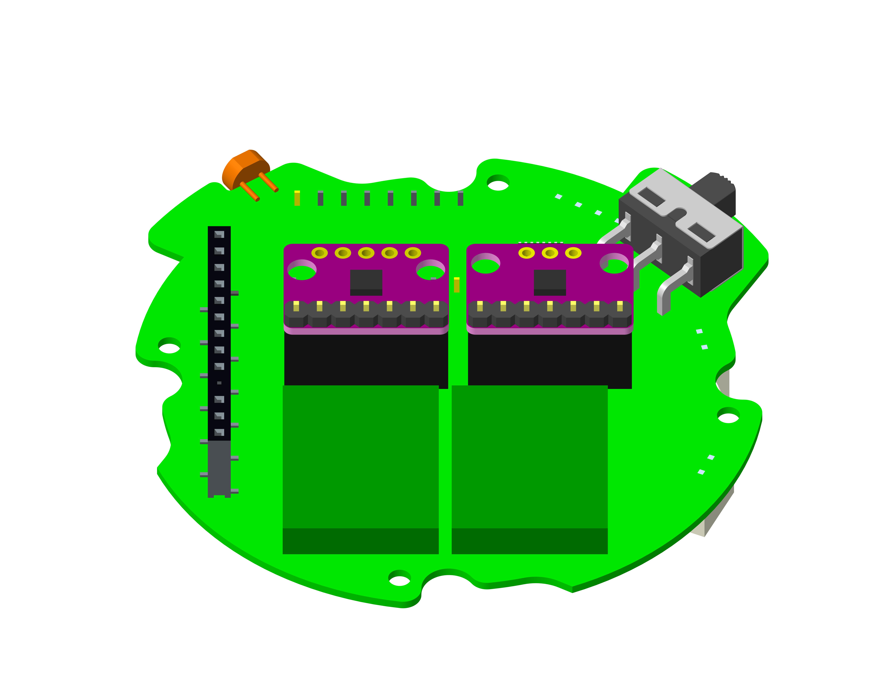
construction/board_sensors23456г.jpg
