cansat-tsniimash/UNKNOWN-2024/construction/cansatf.jpg

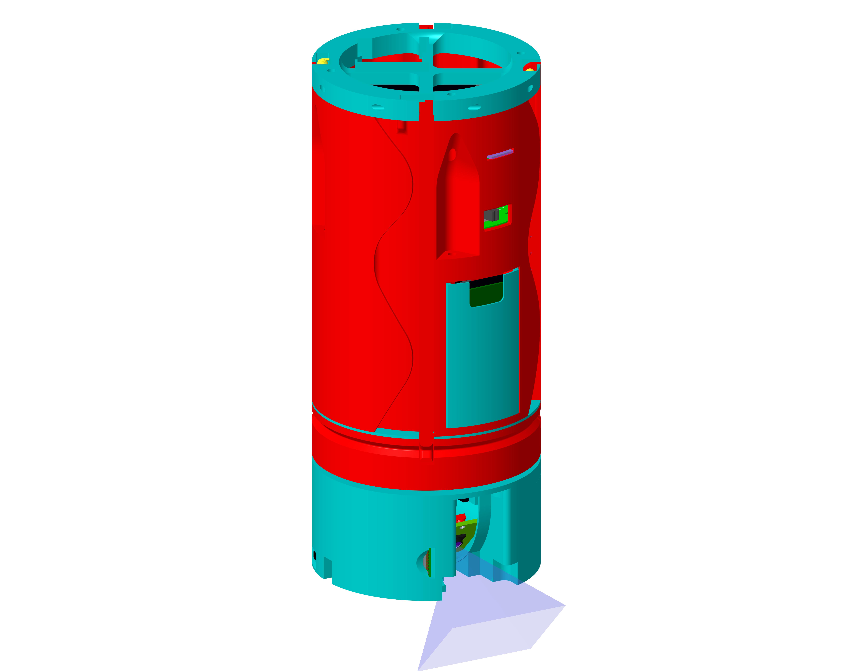
construction/cansatf.jpg
