cansat-tsniimash/UNKNOWN-2024/construction/power board down.png

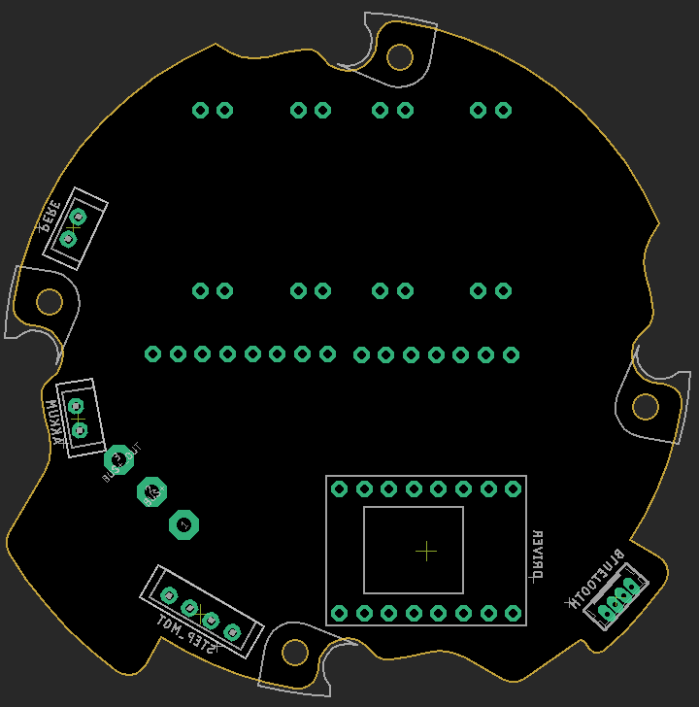
construction/power board down.png
