cansat-tsniimash/UNKNOWN-2024/construction/power board up.png

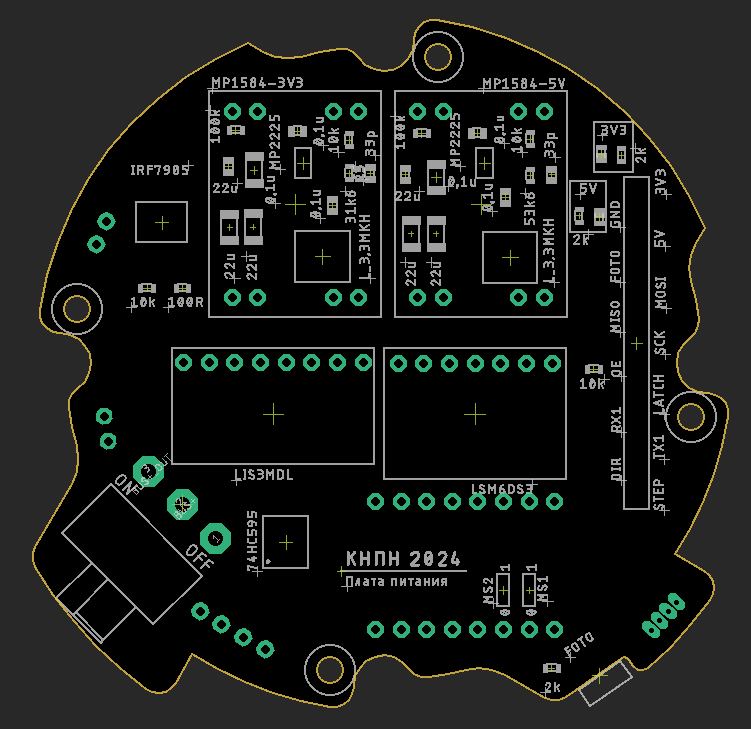
construction/power board up.png
