cansat-tsniimash/UNKNOWN-2024/construction/sat/cansaaaaaaaaa.jpg

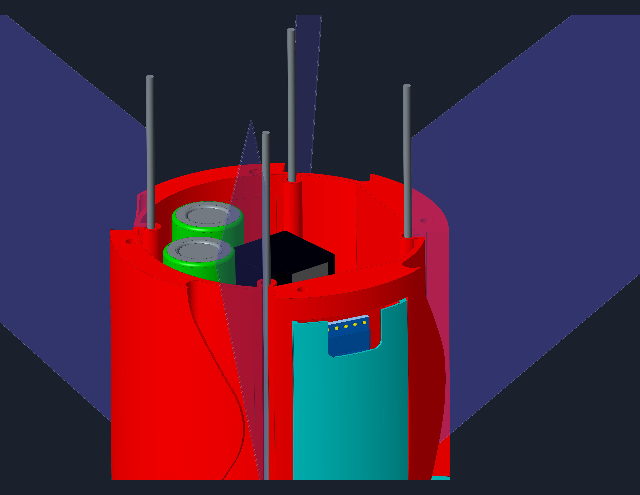
construction/sat/cansaaaaaaaaa.jpg
