cansat-tsniimash/UNKNOWN-2024/construction/sat/cansat1.jpg

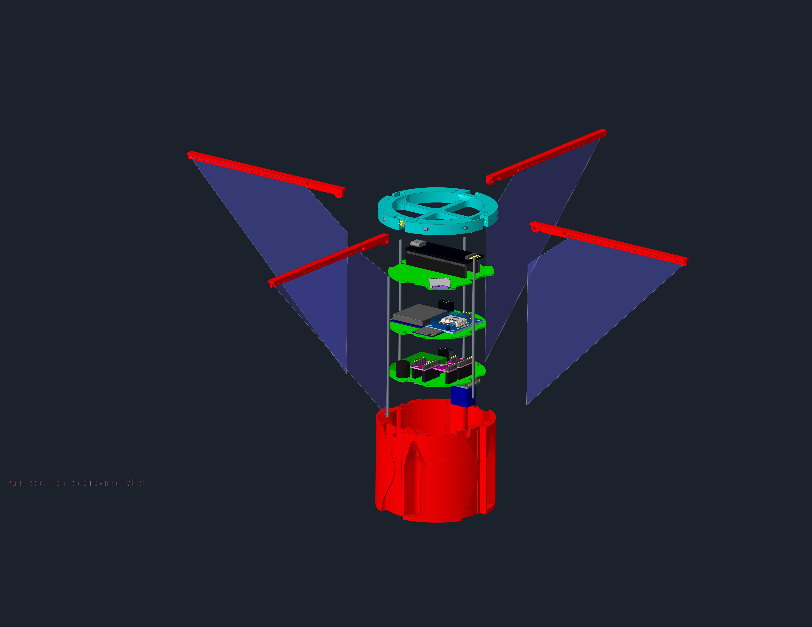
construction/sat/cansat1.jpg
