cansat-tsniimash/UNKNOWN-2024/construction/sat/cansat2.jpg

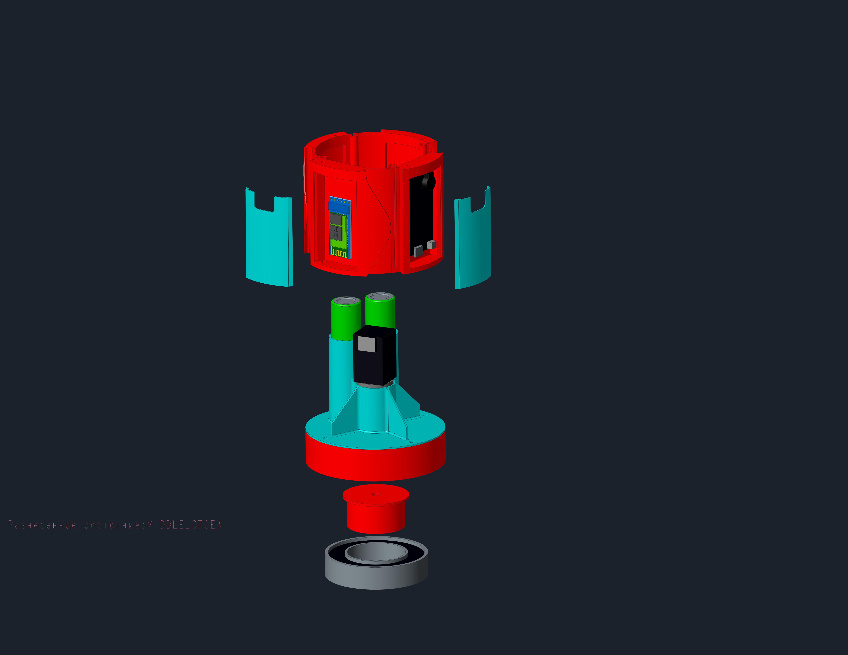
construction/sat/cansat2.jpg
