cansat-tsniimash/UNKNOWN-2024/construction/sat/cansat3.jpg

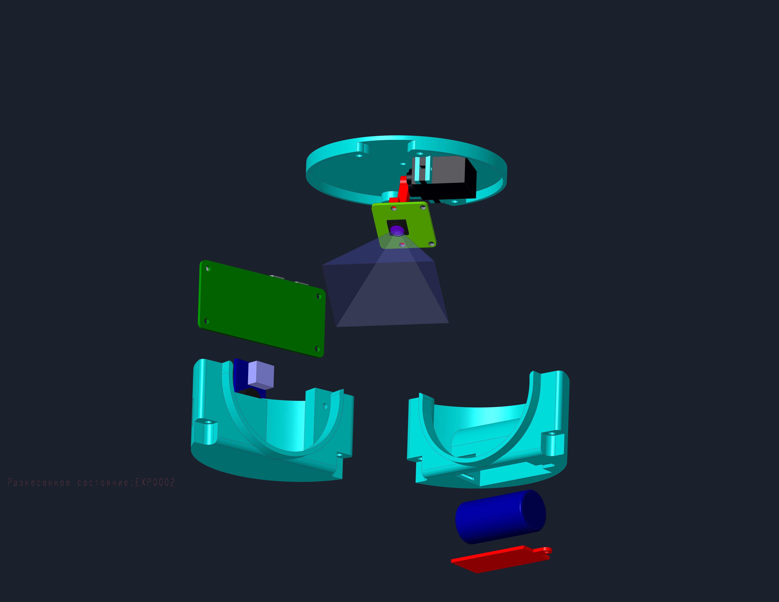
construction/sat/cansat3.jpg
