cansat-tsniimash/UNKNOWN-2024/construction/sat/cansat4.jpg

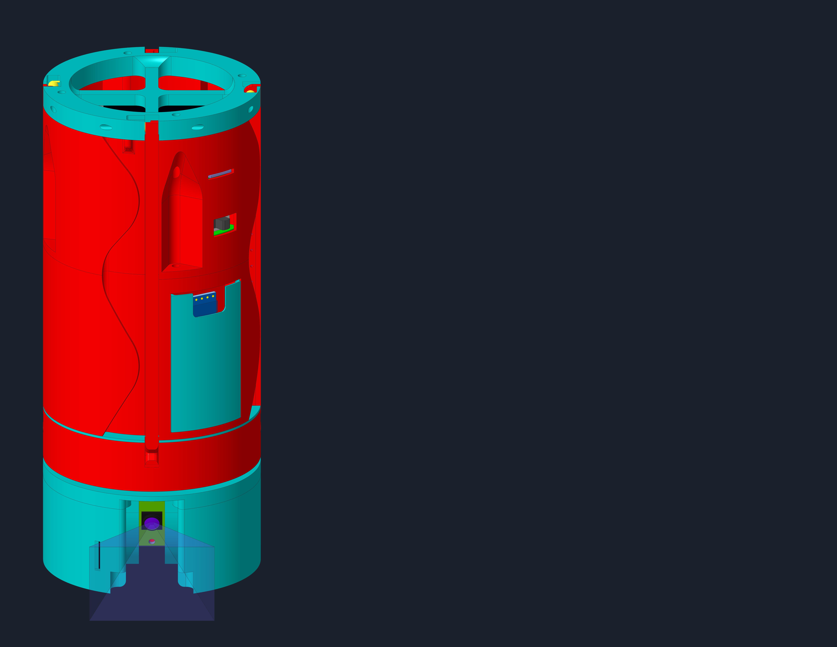
construction/sat/cansat4.jpg
