cansat-tsniimash/UNKNOWN-2024/construction/sat/cansat5.jpg

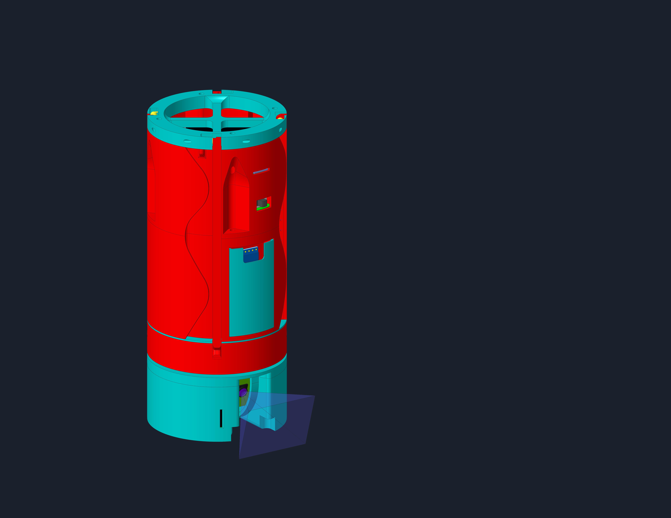
construction/sat/cansat5.jpg
