cansat-tsniimash/UNKNOWN-2024/construction/sat/cansat6.jpg

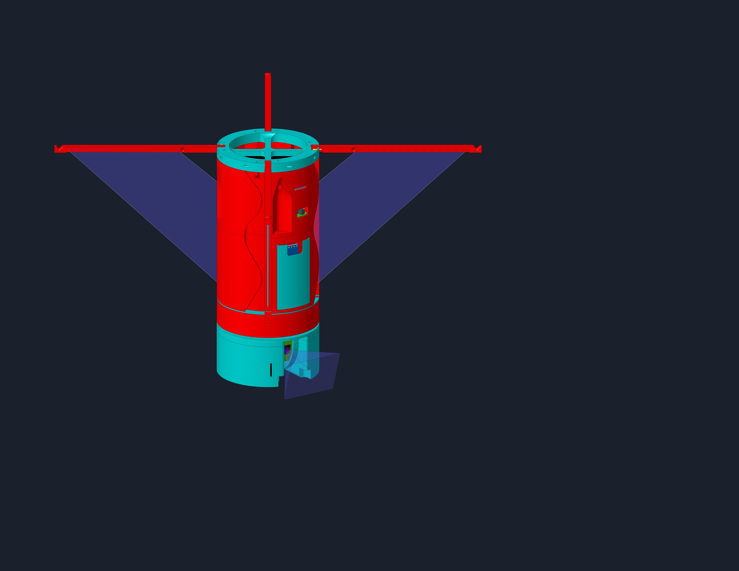
construction/sat/cansat6.jpg
