cansat-tsniimash/UNKNOWN-2024/construction/sat/cansat123.jpg

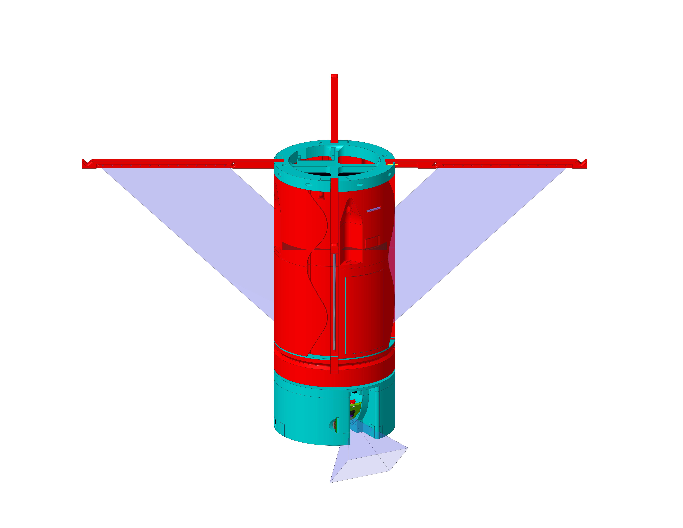
construction/sat/cansat123.jpg
