cansat-tsniimash/UNKNOWN-2024/construction/sat/cansat.jpg

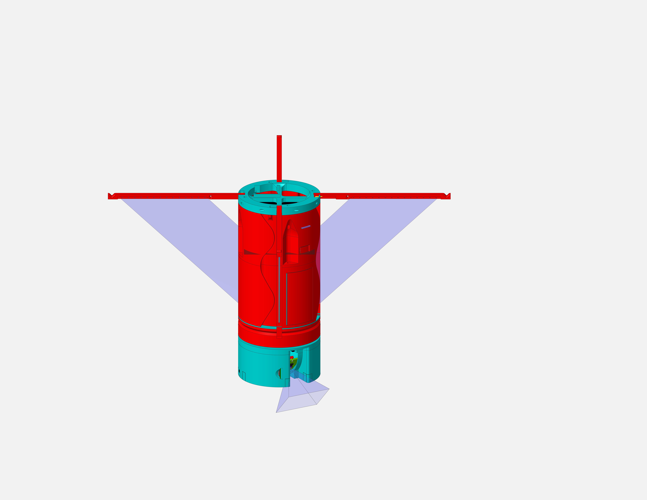
construction/sat/cansat.jpg
