cansat-tsniimash/UNKNOWN-2024/construction/sat/KNPN_GCH.pdf

Б-Б

А

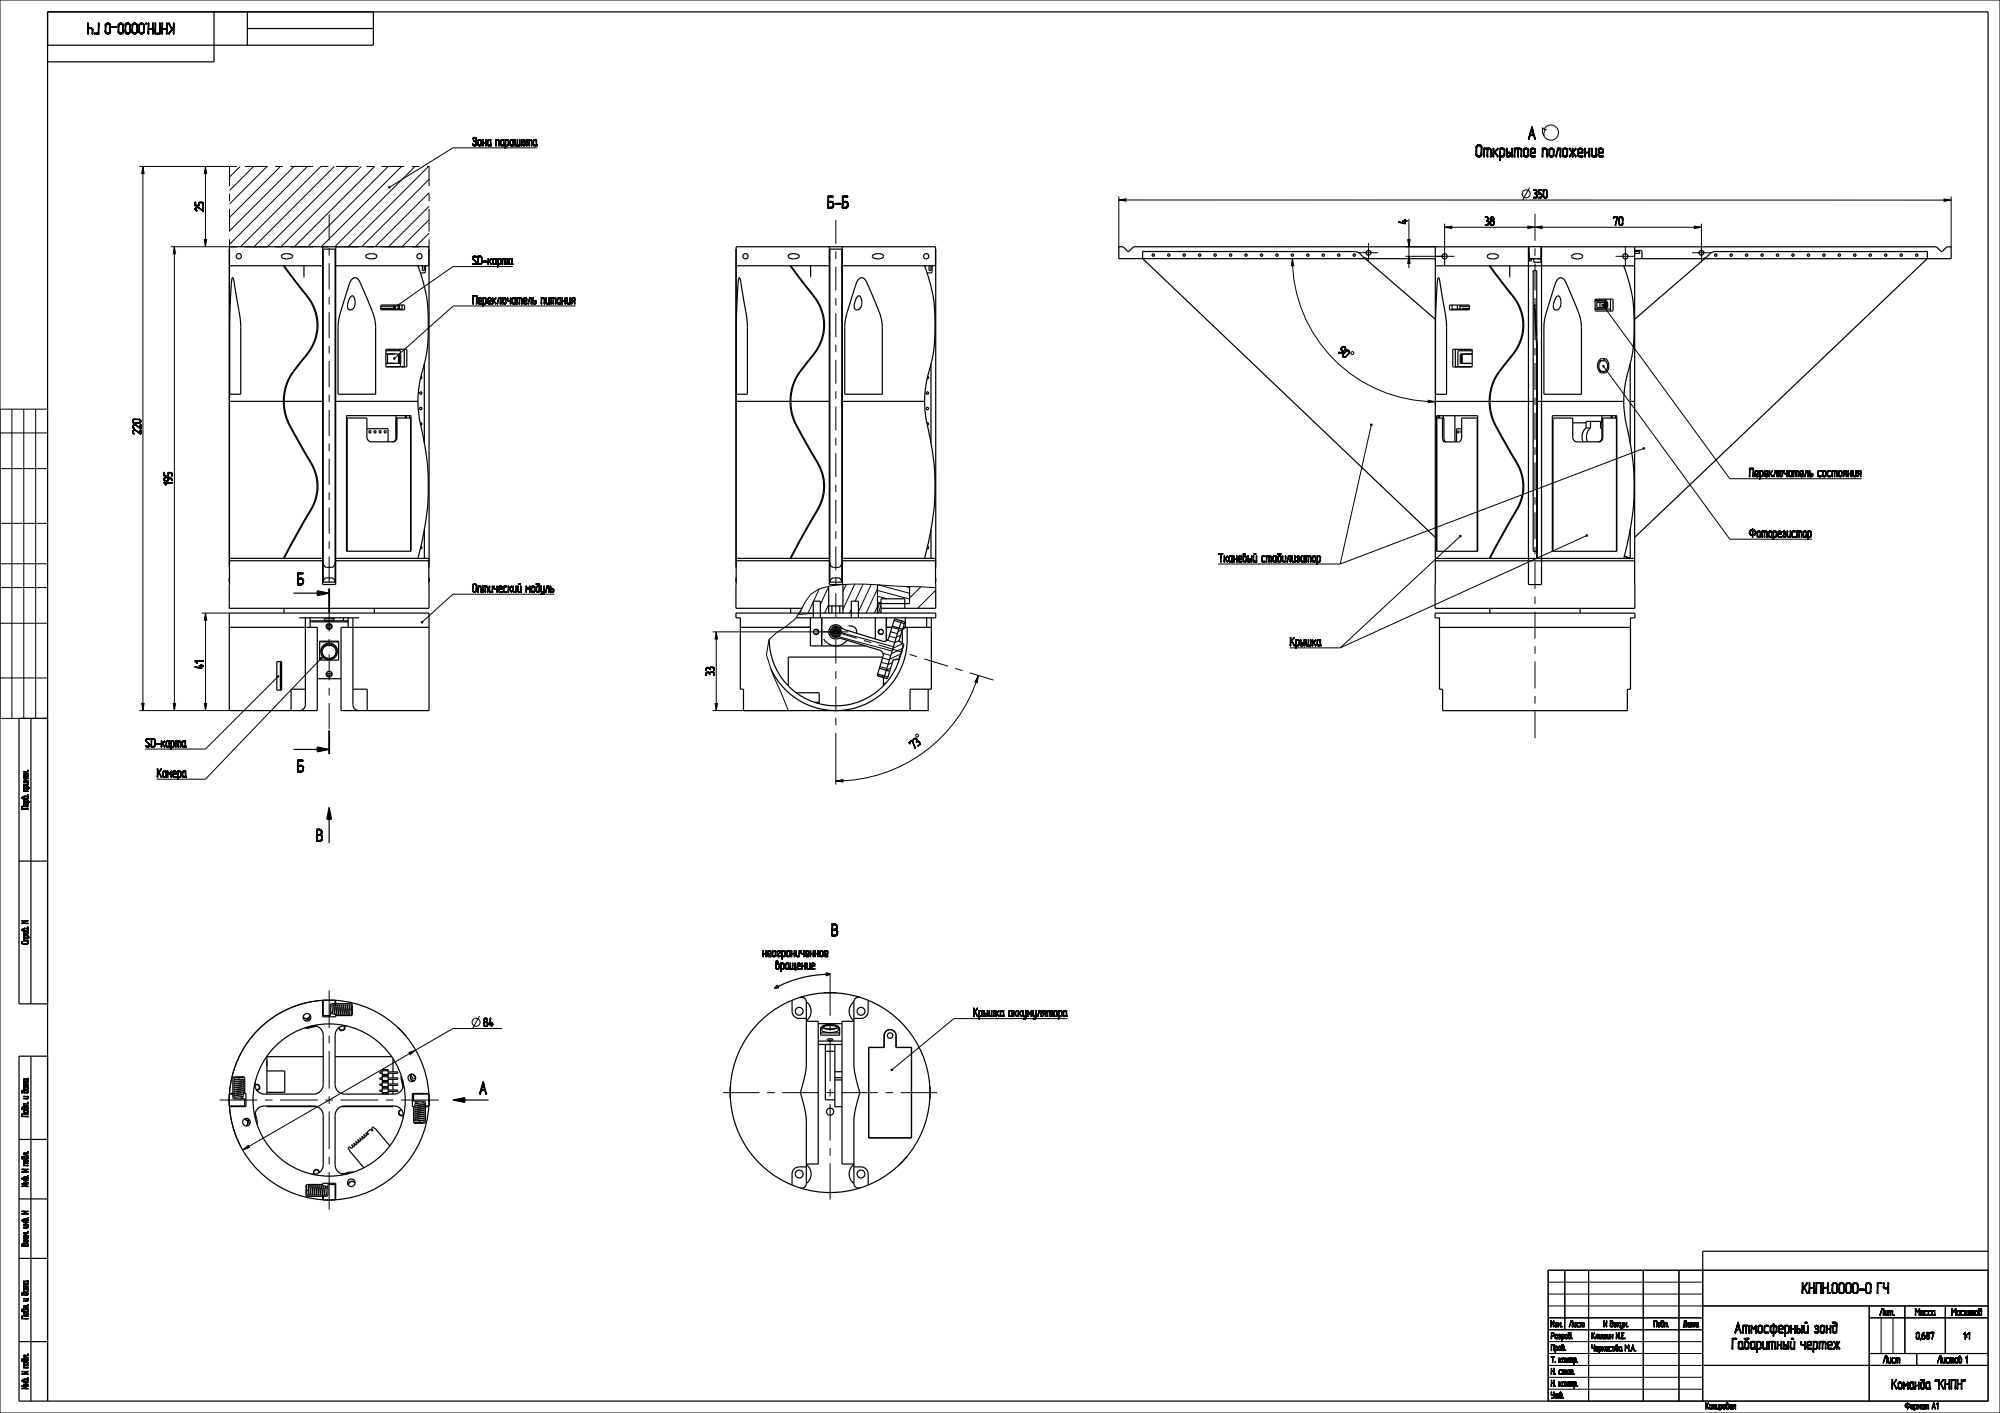
[picture p88: page 1]
Êîïèðîâàë; Ôîðìàò À1; Атмосферный зонд Габаритный чертеж; Óòâ.; Зона парашюта; Переключатель питания; Тканевый стабилизатор; Оптический модуль; SD-карта; Камера; неограниченное вращение; Крышка аккумулятора; Открытое положение; Переключатель состояния; Фоторезистор; Крышка

Èíâ. N ïîäë. Ïîäï. è äàòà Âçàì. èíâ. N Èíâ. N ïîäë. Ïîäï. è äàòà Ñïðàâ. N Ïåðâ. ïðèìåí.

КНПН.0000-0 ГЧ

Ëèò. | Ìàññà | Ìàñøòàá

Èçì. Ëèñò | N äîêóì. | Ïîäï. | Äàòà | | | | | 0,687 | 1:1
Ðàçðàá. | Клишин И.Е.

Ïðîâ. | Черкасова М.А.
Ò. êîíòð. | | | | Ëèñò | Ëèñòîâ 1
Í. ñåêò. | | | | Команда "КНПН" Í. êîíòð.
