cansat-tsniimash/UNKNOWN-2024/construction/sat/gch1234.pdf

Б-Б

## Открытое положение

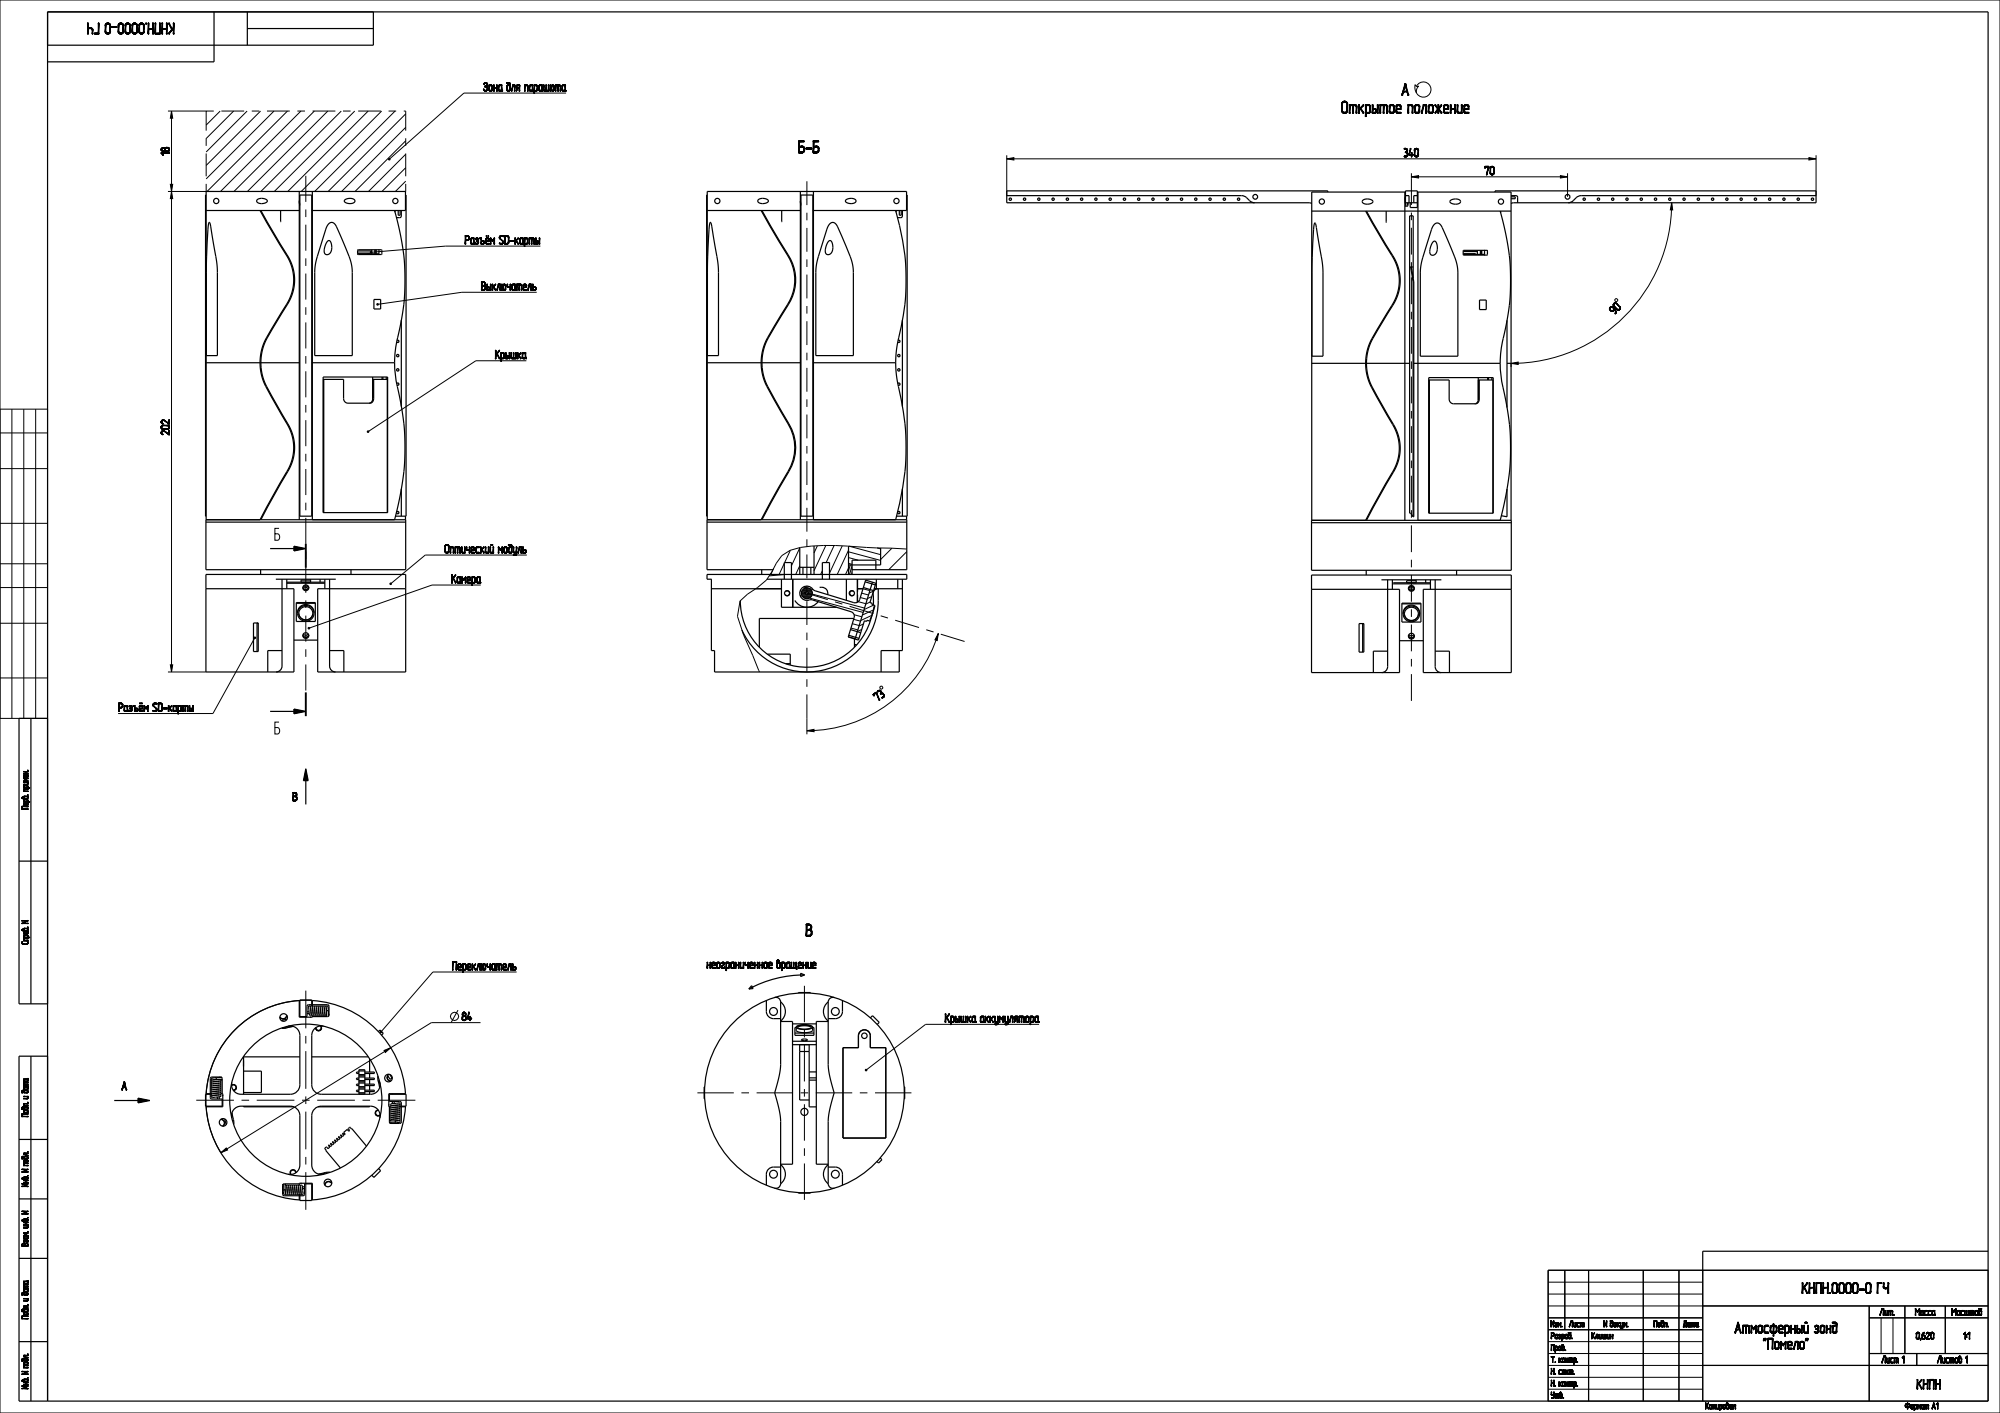
[picture p89: page 1]
Êîïèðîâàë; Ôîðìàò À1; Атмосферный зонд; Выключатель; Переключатель; Крышка; Камера; Оптический модуль; неограниченное вращение; Крышка аккумулятора

Зона для парашюта

Разъём SD-карты

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

КНПН.0000-0 ГЧ

"Помело" | Ëèò. | Ìàññà | Ìàñøòàá

Èçì. Ëèñò | N äîêóì. | Ïîäï. | Äàòà | | | | | 0,620 | 1:1
Ðàçðàá. | Клишин
Ïðîâ.
Ò. êîíòð. | | | | Ëèñò 1 | Ëèñòîâ 1
Í. ñåêò. | | | | КНПН
Í. êîíòð.
Óòâ.
