cansat-tsniimash/UNKNOWN-2024/schematics/KPNN2024/Board/pitanie.brd

## EAGLE design schematics/KPNN2024/Board/pitanie.brd (2024-05-11)

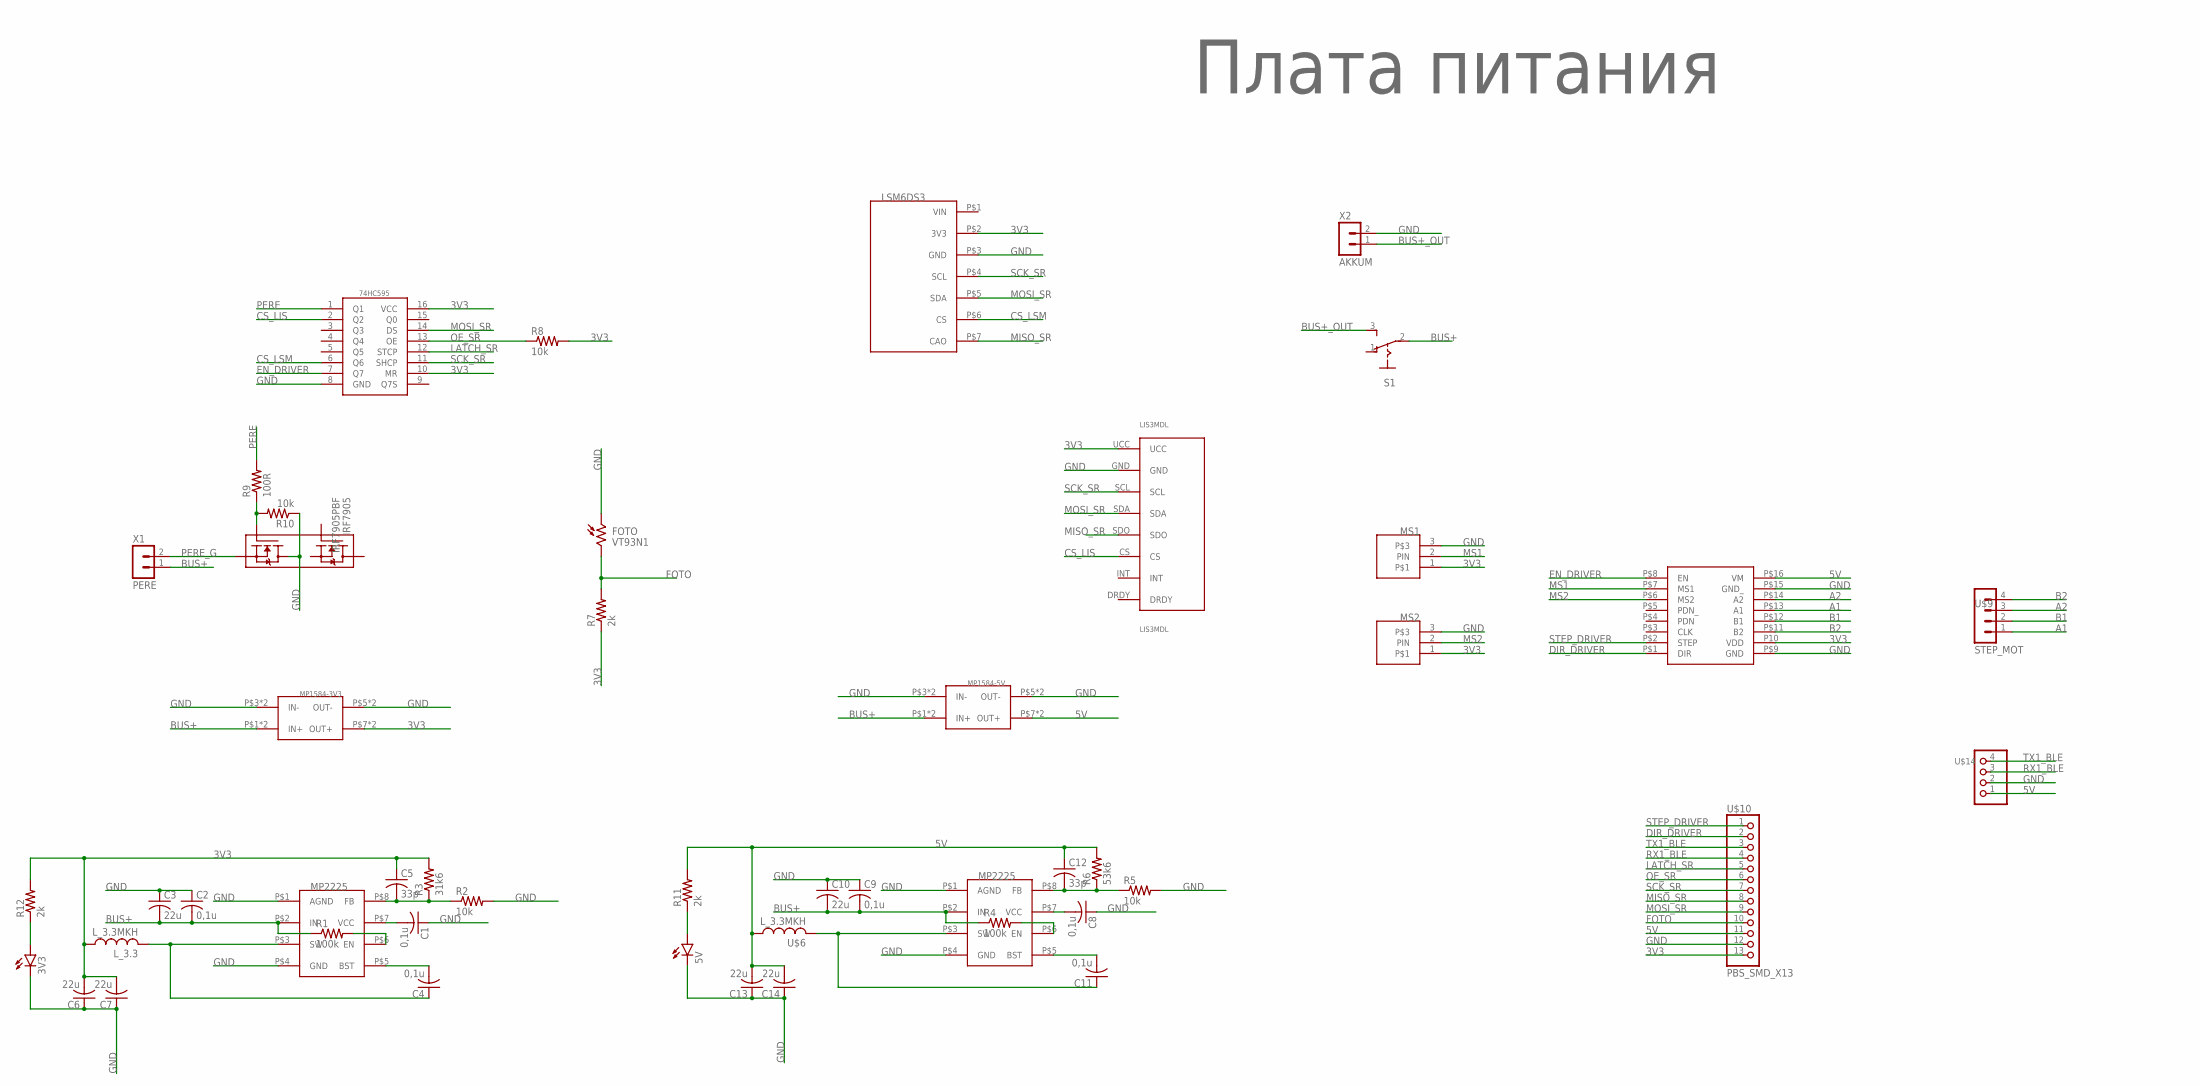
[picture p90: schematic pitanie.sch]

Parts:
3V3, 5V: LEDCHIP-LED0603; CHIP-LED0603
74HC595: 74HC595; TSSOP16
C1, C4, C8, C11: 0,1u; C0603
C2, C9: 0,1u; C1206
C3, C10: 22u; C0603
C5, C12: 33p; C0603
C6, C7, C13, C14: 22u; C1206
DRIVER: TMC2209_WITHOUT
FOTO: VT93N1
IRF7905: IRF7905PBF; SO8
LIS3MDL: LIS3MDL
LSM6DS3: LSM6DS3_WITHOUT
L_3.3: L_3.3MKH; L_SPM5020
MP1584-3V3: MP1584-B
MP1584-5V: MP1584; MP1584-B
MS1, MS2: CONNECT_3
R1, R4: 100k; R0603
R2, R5, R8, R10: 10k; R0603
R3: 31k6; R0603
R6: 53k6; R0603
R7, R11, R12: 2k; R0603
R9: 100R; R0603
S1: UNICS-SWITCHSS_12D11; SS_12D11
U$1: Плата питания; LOGO
U$2, U$5: MP2225; TSOT23-8
U$6: L_3.3MKH; L_SPM5020
U$9: STEP_MOT; JST-4-2.5
U$10: PBS_SMD_X13; PBD_SMD_X13
U$14: BLUETOOTH; 53047-04
X1: PERE; JST-2-2.5
X2: AKKUM; JST-2-2.5

Connections:
3V3: 74HC595.10 (MR), 74HC595.16 (VCC), C5.1, C6.2, C7.2, DRIVER.P10 (VDD), LIS3MDL.UCC, LSM6DS3.P$2 (3V3), L_3.3.P$1 (1), MP1584-3V3.P$7 (OUT+), MP1584-3V3.P$8 (OUT+), MS1.1, MS2.1, R3.2, R7.1, R8.2, R12.2, U$10.13
5V: C12.1, C13.2, C14.2, DRIVER.P$16 (VM), MP1584-5V.P$7 (OUT+), MP1584-5V.P$8 (OUT+), R6.2, R11.2, U$6.P$1 (1), U$10.11, U$14.1
A1: DRIVER.P$13 (A1), U$9.1
A2: DRIVER.P$14 (A2), U$9.3
B1: DRIVER.P$12 (B1), U$9.2
B2: DRIVER.P$11 (B2), U$9.4
BUS+: C2.2, C3.2, C9.2, C10.2, MP1584-3V3.P$1 (IN+), MP1584-3V3.P$2 (IN+), MP1584-5V.P$1 (IN+), MP1584-5V.P$2 (IN+), R1.1, R4.1, S1.2, U$2.P$2 (IN), U$5.P$2 (IN), X1.1
BUS+_OUT: S1.3 (S), X2.1
CS_LIS: 74HC595.2 (Q2), LIS3MDL.CS
CS_LSM: 74HC595.6 (Q6), LSM6DS3.P$6 (CS)
DIR_DRIVER: DRIVER.P$1 (DIR), U$10.2
EN_DRIVER: 74HC595.7 (Q7), DRIVER.P$8 (EN)
FOTO: FOTO.P$2 (2), R7.2, U$10.10
GND: 3V3.C, 5V.C, 74HC595.8 (GND), C1.1, C2.1, C3.1, C6.1, C7.1, C8.1, C9.1, C10.1, C13.1, C14.1, DRIVER.P$9 (GND), DRIVER.P$15 (GND_), FOTO.P$1 (1), IRF7905.7 (D2), IRF7905.8 (D2), LIS3MDL.GND, LSM6DS3.P$3 (GND), MP1584-3V3.P$3 (IN-), MP1584-3V3.P$4 (IN-), MP1584-3V3.P$5 (OUT-), MP1584-3V3.P$6 (OUT-), MP1584-5V.P$3 (IN-), MP1584-5V.P$4 (IN-), MP1584-5V.P$5 (OUT-), MP1584-5V.P$6 (OUT-), MS1.3, MS2.3, R2.2, R5.2, R10.1, U$2.P$1 (AGND), U$2.P$4 (GND), U$5.P$1 (AGND), U$5.P$4 (GND), U$10.12, U$14.2, X2.2
LATCH_SR: 74HC595.12 (STCP), U$10.5
MISO_SR: LIS3MDL.SDO, LSM6DS3.P$7 (CAO), U$10.8
MOSI_SR: 74HC595.14 (DS), LIS3MDL.SDA, LSM6DS3.P$5 (SDA), U$10.9
MS1: DRIVER.P$7 (MS1), MS1.2 (PIN)
MS2: DRIVER.P$6 (MS2), MS2.2 (PIN)
unnamed: C1.2, U$2.P$7 (VCC)
unnamed: R1.2, U$2.P$6 (EN)
unnamed: C4.2, U$2.P$5 (BST)
unnamed: C4.1, L_3.3.P$2 (2), U$2.P$3 (SW)
unnamed: C5.2, R2.1, R3.1, U$2.P$8 (FB)
unnamed: IRF7905.2 (G2), R9.1, R10.2
unnamed: C8.2, U$5.P$7 (VCC)
unnamed: R4.2, U$5.P$6 (EN)
unnamed: C11.2, U$5.P$5 (BST)
unnamed: C11.1, U$5.P$3 (SW), U$6.P$2 (2)
unnamed: C12.2, R5.1, R6.1, U$5.P$8 (FB)
unnamed: 5V.A, R11.1
unnamed: 3V3.A, R12.1
OE_SR: 74HC595.13 (OE), R8.1, U$10.6
PERE: 74HC595.1 (Q1), R9.2
PERE_G: IRF7905.1 (S2), X1.2
RX1_BLE: U$10.4, U$14.3
SCK_SR: 74HC595.11 (SHCP), LIS3MDL.SCL, LSM6DS3.P$4 (SCL), U$10.7
STEP_DRIVER: DRIVER.P$2 (STEP), U$10.1
TX1_BLE: U$10.3, U$14.4

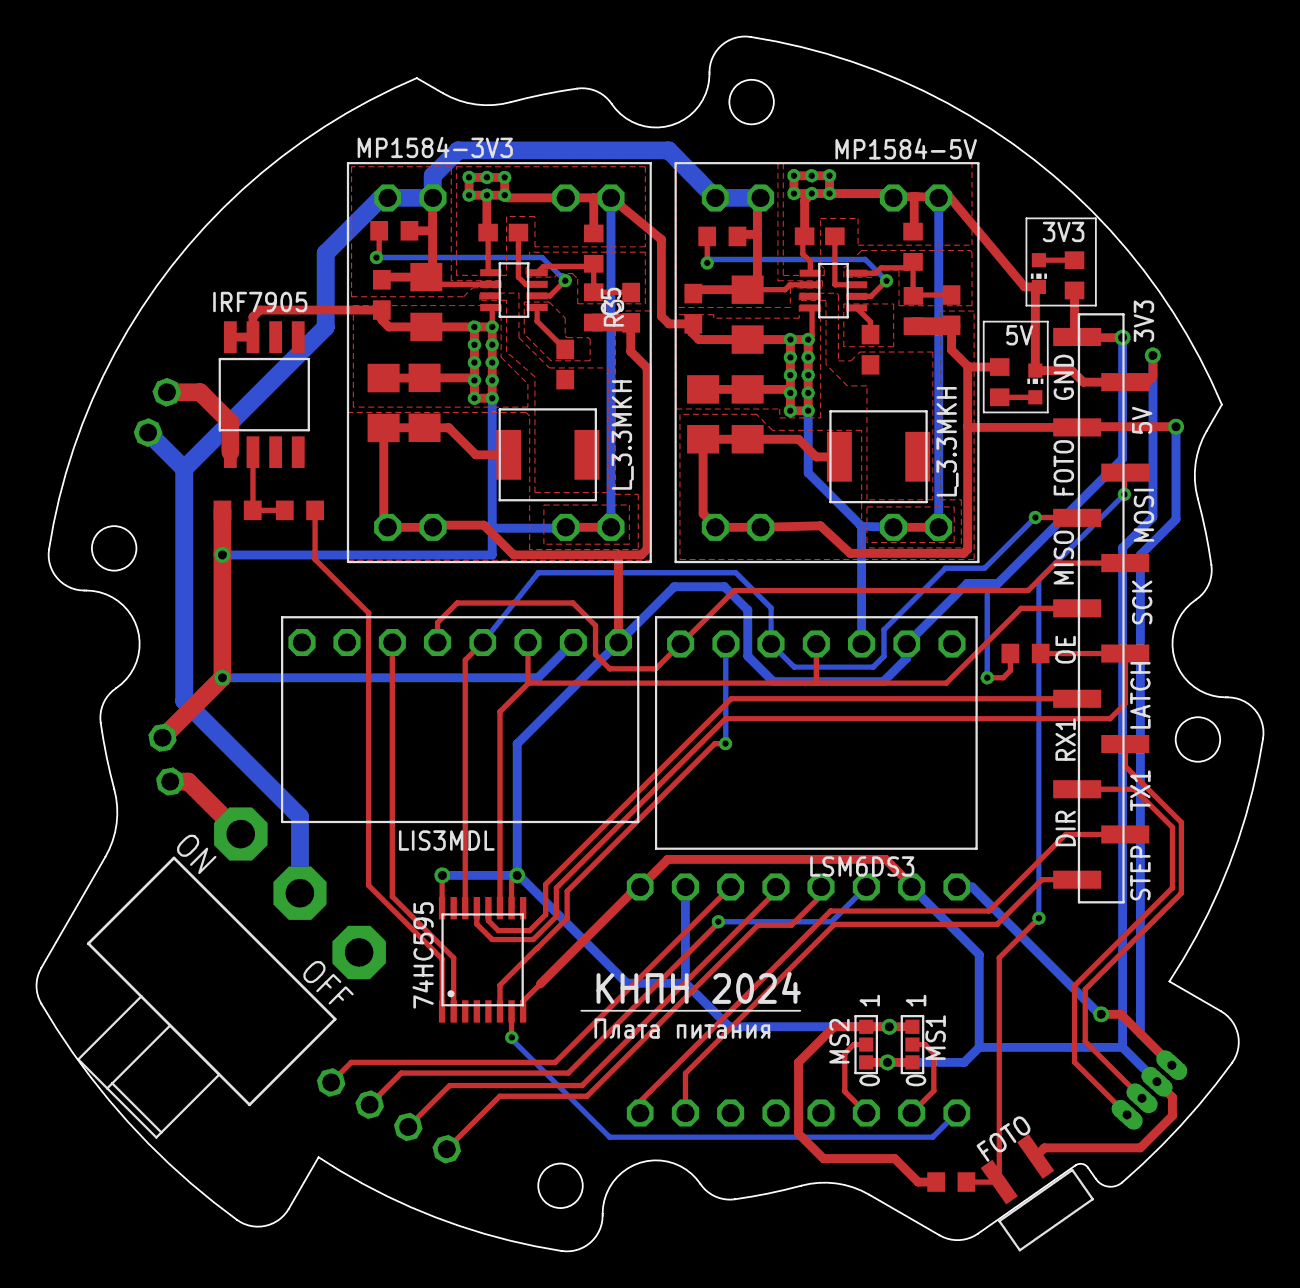
[picture p91: board pitanie.brd from above]

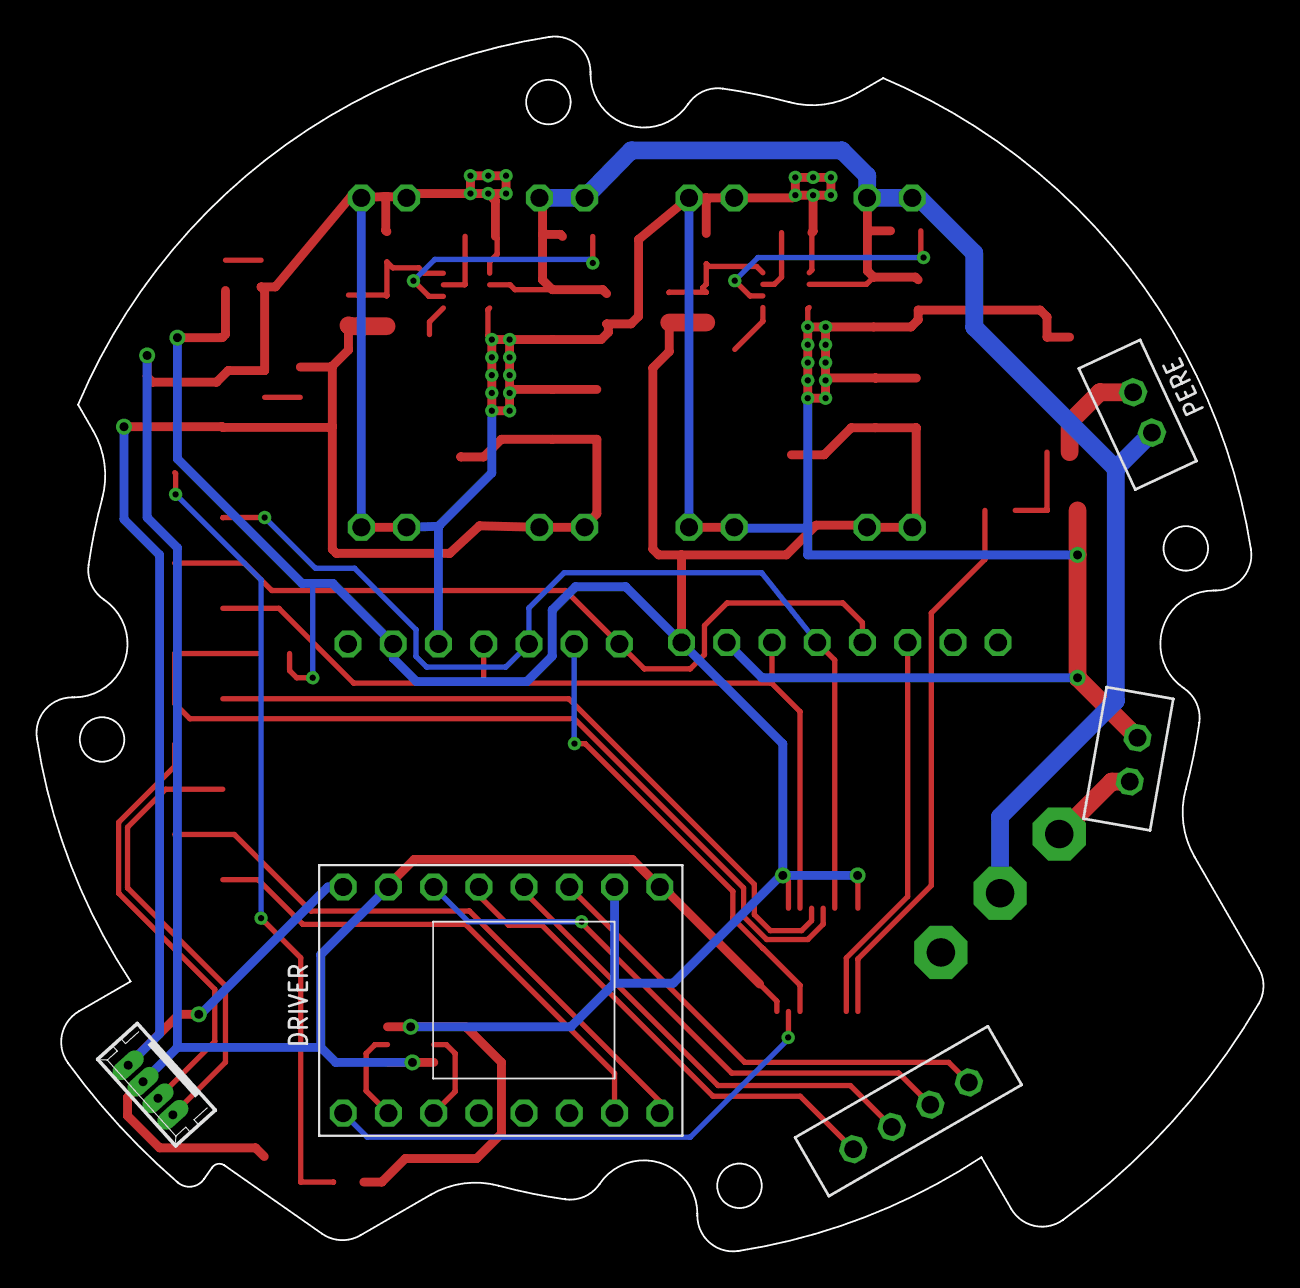
[picture p92: board pitanie.brd from below]

Board: 2 copper layers, 68.9 x 68.2 mm, 49 parts (5 on the bottom side), 39 nets.
