cansat-tsniimash/UNKNOWN-2024/schematics/KPNN2024/Board/MK.brd

## EAGLE design schematics/KPNN2024/Board/MK.brd (2024-03-04)

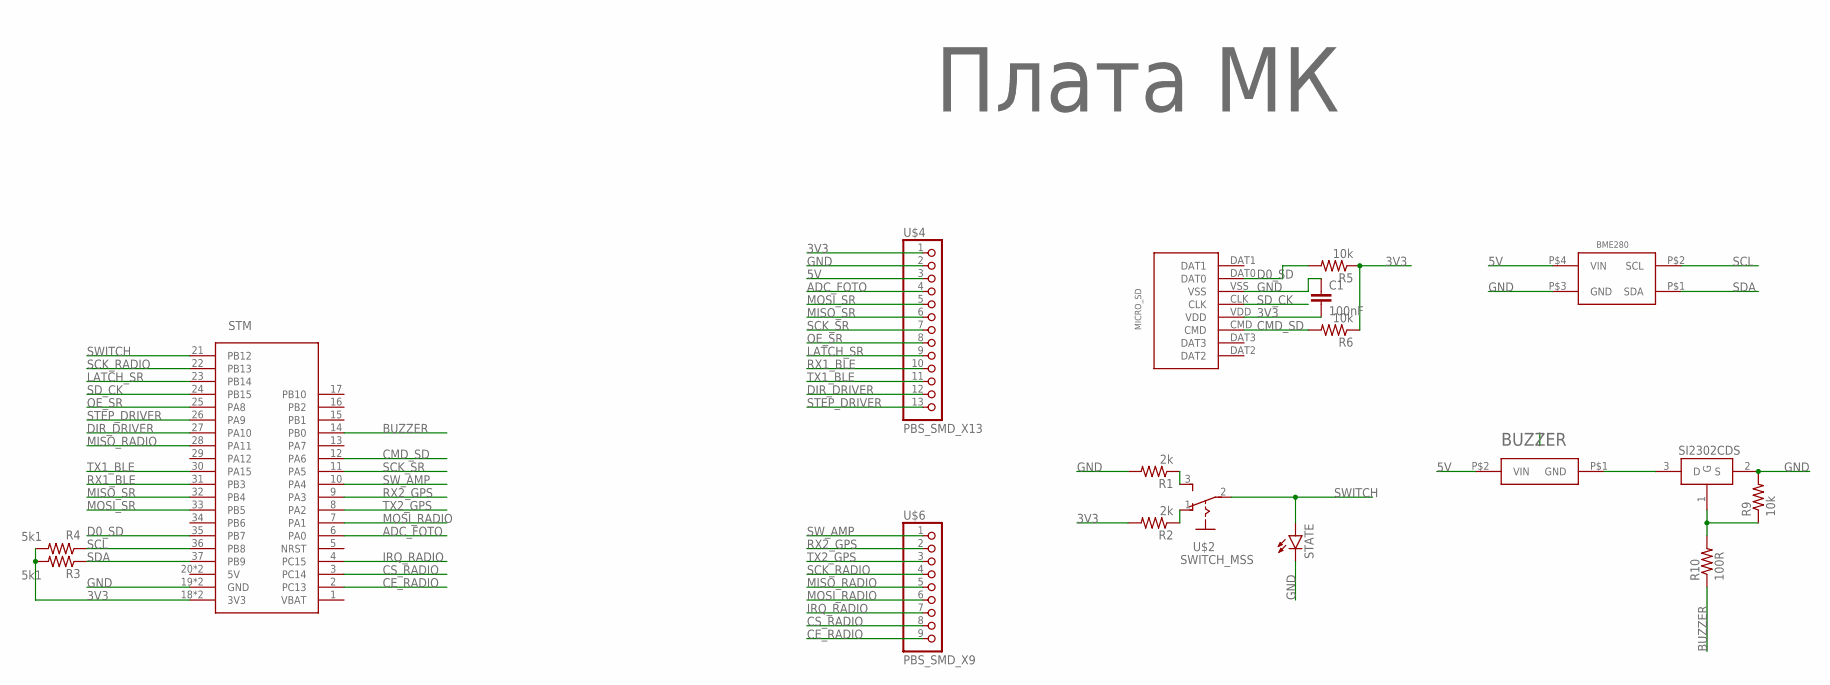
[picture p93: schematic MK.sch]

Parts:
BME280: BME280BME280-PINS-ONLY; BME280-PINS-ONLY
BUZZER: BUZZERS8R6; BUZZER-S8R12
C1: 100nF; C0603
MICRO_SD: SD
R1, R2: 2k; R0603
R3, R4: 5k1; R0603
R5, R6, R9: 10k; R0603
R10: 100R; R0603
SI2302CDS: SI2302CDS; SOT23-3
STATE: LEDCHIPLED_0603; CHIPLED_0603
STM: STM32F411_BOARD
U$1: Плата МК; LOGO
U$2: SWITCH_MSS
U$4: PBS_SMD_X13; PBD_SMD_X13
U$6: PBS_SMD_X9

Connections:
3V3: C1.2, MICRO_SD.VDD, R2.2, R3.2, R4.2, R5.1, R6.1, STM.18 (3V3), STM.40 (3V3), U$4.1
5V: BME280.P$4 (VIN), BUZZER.P$2 (VIN), U$4.3
ADC_FOTO: STM.6 (PA0), U$4.4
BUZZER: R10.1, STM.14 (PB0)
CE_RADIO: STM.2 (PC13), U$6.9
CMD_SD: MICRO_SD.CMD, R6.2, STM.12 (PA6)
CS_RADIO: STM.3 (PC14), U$6.8
D0_SD: MICRO_SD.DAT0, R5.2, STM.35 (PB7)
DIR_DRIVER: STM.27 (PA10), U$4.12
GND: BME280.P$3 (GND), C1.1, MICRO_SD.VSS, R1.2, R9.2, SI2302CDS.2 (S), STATE.C, STM.19 (GND), STM.39 (GND), U$4.2
IRQ_RADIO: STM.4 (PC15), U$6.7
LATCH_SR: STM.23 (PB14), U$4.9
MISO_RADIO: STM.28 (PA11), U$6.5
MISO_SR: STM.32 (PB4), U$4.6
MOSI_RADIO: STM.7 (PA1), U$6.6
MOSI_SR: STM.33 (PB5), U$4.5
unnamed: R1.1, U$2.3 (S)
unnamed: R2.1, U$2.1 (O)
unnamed: BUZZER.P$1 (GND), SI2302CDS.3 (D)
unnamed: R9.1, R10.2, SI2302CDS.1 (G)
OE_SR: STM.25 (PA8), U$4.8
RX1_BLE: STM.31 (PB3), U$4.10
RX2_GPS: STM.9 (PA3), U$6.2
SCK_RADIO: STM.22 (PB13), U$6.4
SCK_SR: STM.11 (PA5), U$4.7
SCL: BME280.P$2 (SCL), R4.1, STM.36 (PB8)
SDA: BME280.P$1 (SDA), R3.1, STM.37 (PB9)
SD_CK: MICRO_SD.CLK, STM.24 (PB15)
STEP_DRIVER: STM.26 (PA9), U$4.13
SWITCH: STATE.A, STM.21 (PB12), U$2.2
SW_AMP: STM.10 (PA4), U$6.1
TX1_BLE: STM.30 (PA15), U$4.11
TX2_GPS: STM.8 (PA2), U$6.3

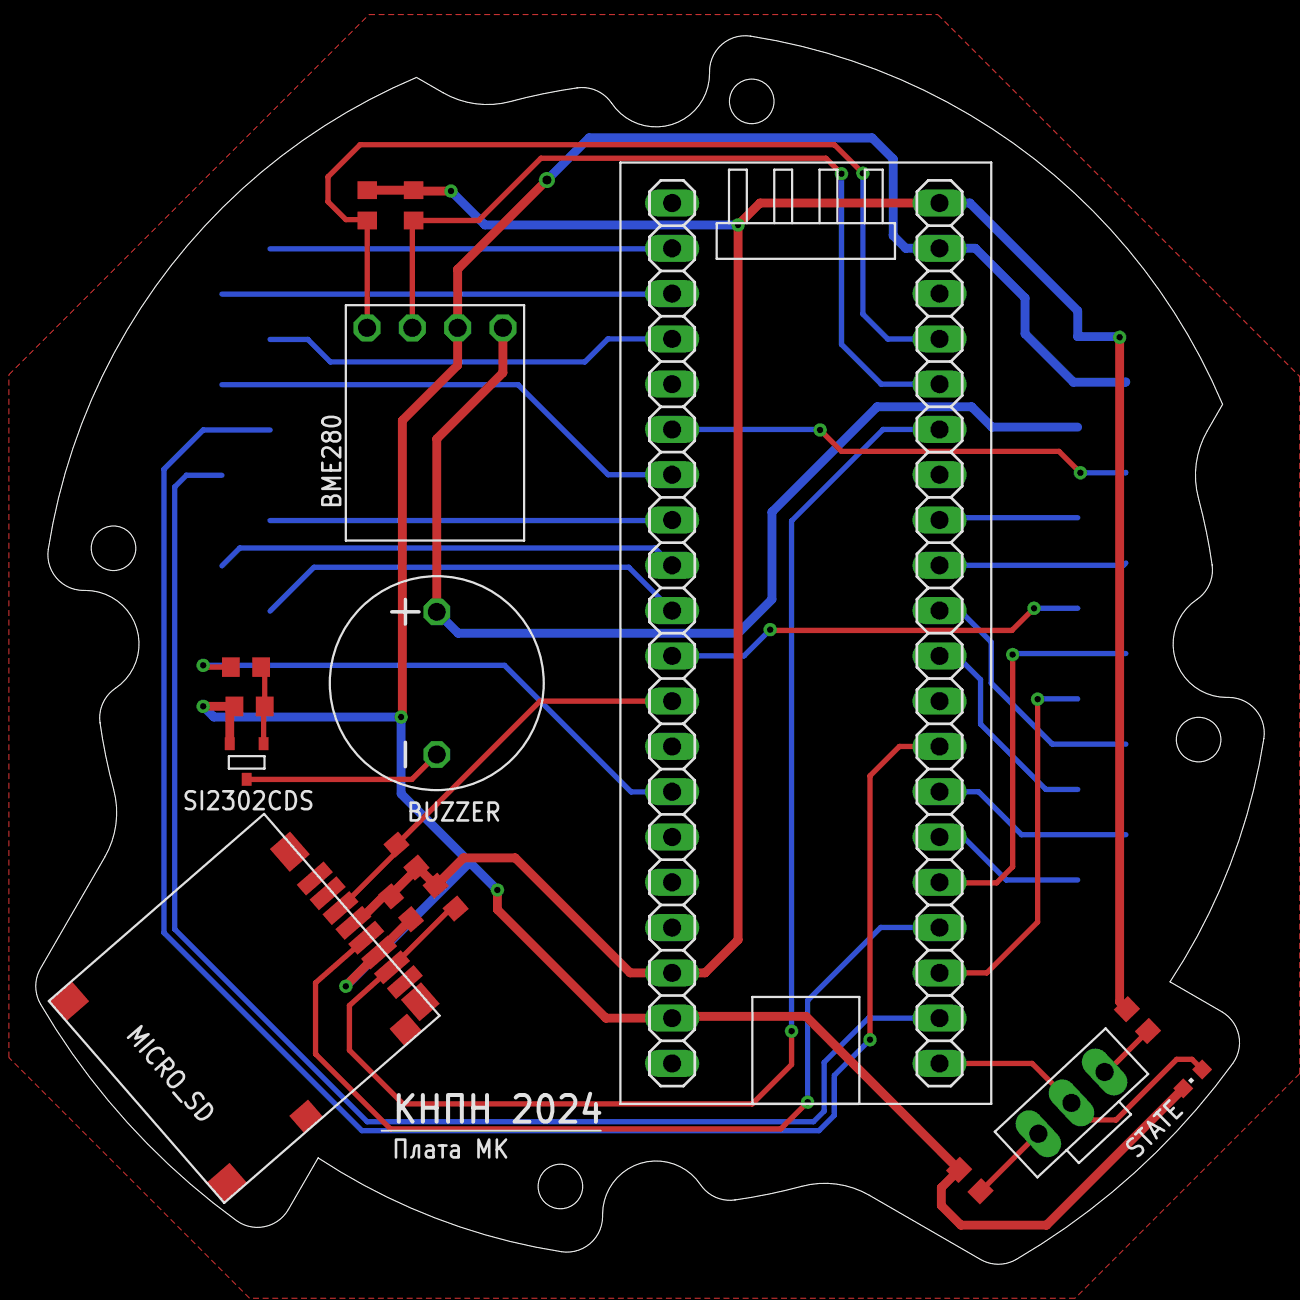
[picture p94: board MK.brd from above]

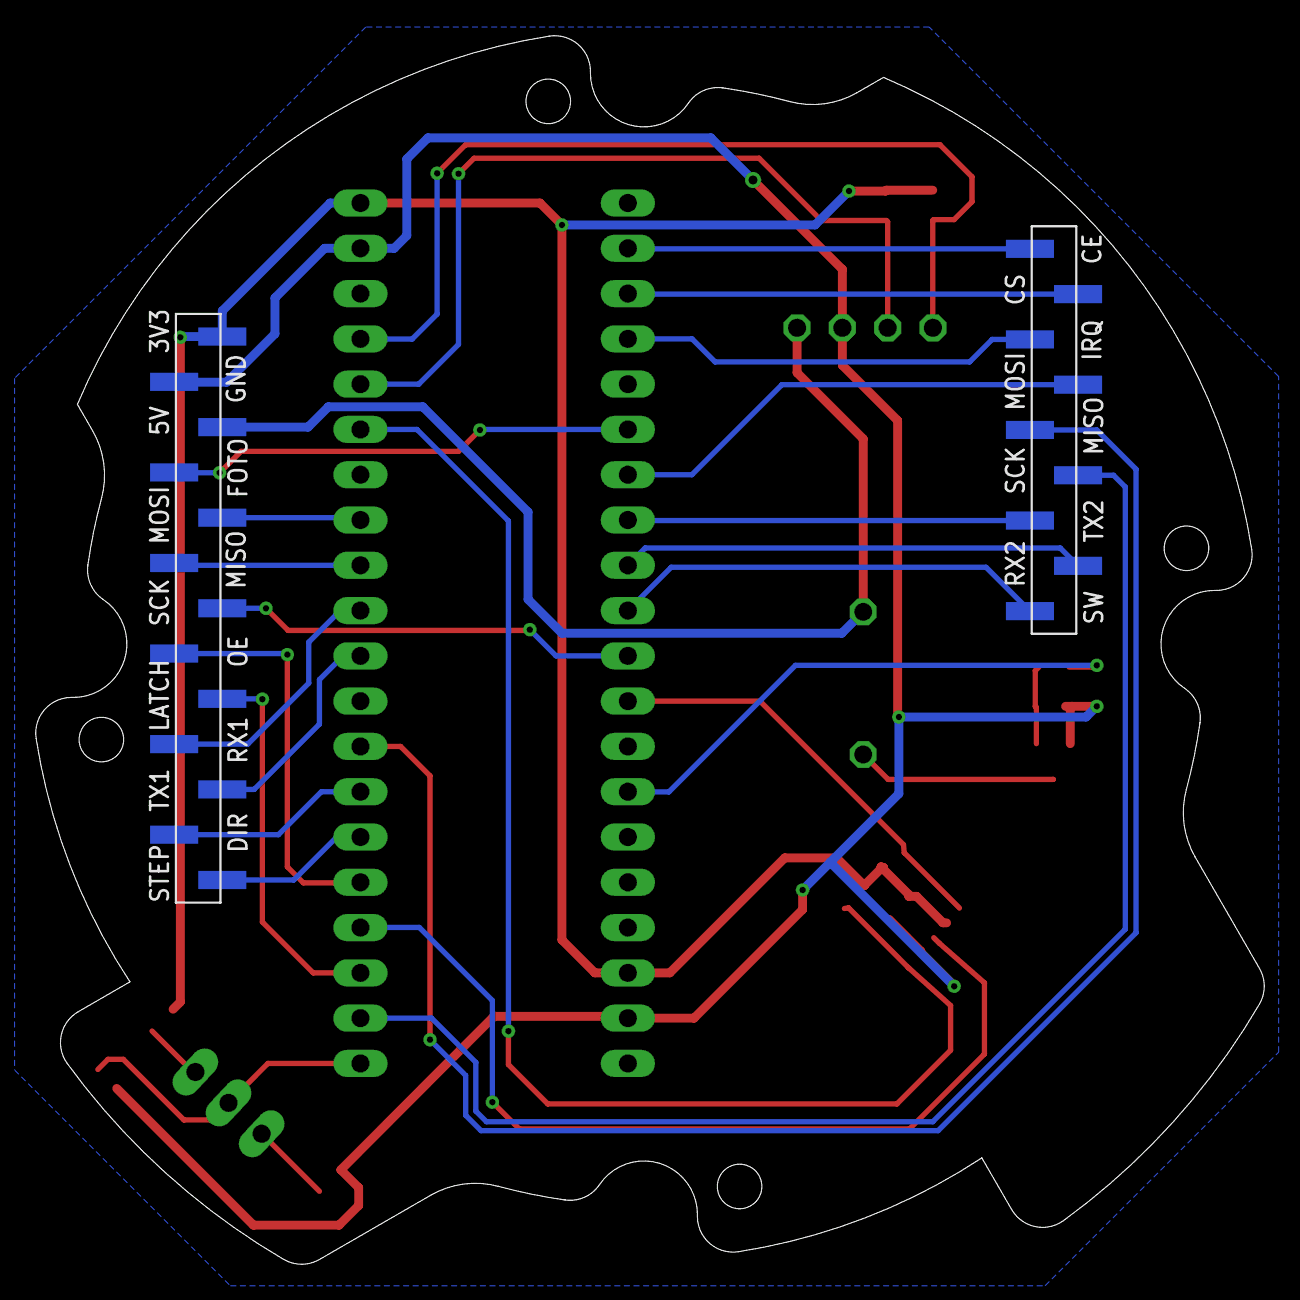
[picture p95: board MK.brd from below]

Board: 2 copper layers, 68.9 x 68.9 mm, 19 parts (2 on the bottom side), 33 nets.
