cansat-tsniimash/UNKNOWN-2024/schematics/KPNN2024/Board/RADIO.brd

## EAGLE design schematics/KPNN2024/Board/RADIO.brd (2024-03-04)

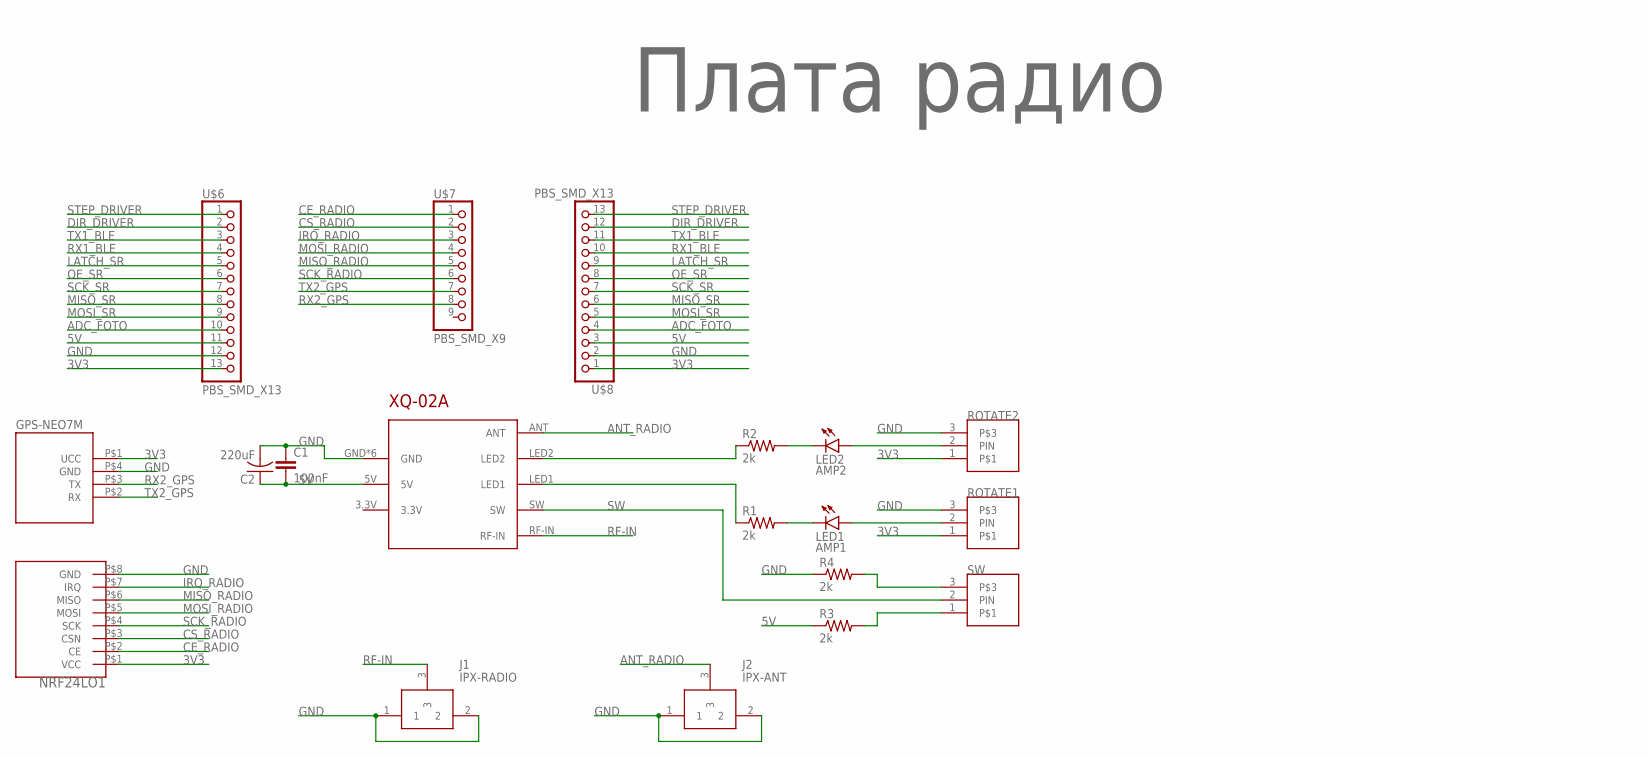
[picture p96: schematic RADIO.sch]

Parts:
C1: 100nF; C0603
C2: 220uF; ECAP220-CMD
GPS-NEO7M: GPS-NEO7M
J1: IPX-RADIO; U.FL-R-SMT-1(10)
J2: IPX-ANT; U.FL-R-SMT-1(10)
LED1: AMP1; CHIPLED_0603
LED2: AMP2; CHIPLED_0603
NRF24LO1: NRF24L01_ML01SP4
R1, R2, R3, R4: 2k; R0603
ROTATE1, ROTATE2: CONNECT_3
SW: CONNECT_3
U$1: Плата радио; LOGO
U$6, U$8: PBS_SMD_X13; PBD_SMD_X13
U$7: PBS_SMD_X9
XQ-02A: XQ-02A

Connections:
3V3: GPS-NEO7M.P$1 (UCC), NRF24LO1.P$1 (VCC), ROTATE1.1, ROTATE2.1, U$6.13, U$8.1
5V: C1.2, C2.P$1 (1), R3.1, U$6.11, U$8.3, XQ-02A.5V
ADC_FOTO: U$6.10, U$8.4
ANT_RADIO: J2.3, XQ-02A.ANT
CE_RADIO: NRF24LO1.P$2 (CE), U$7.1
CS_RADIO: NRF24LO1.P$3 (CSN), U$7.2
DIR_DRIVER: U$6.2, U$8.12
GND: C1.1, C2.P$2 (2), GPS-NEO7M.P$4 (GND), J1.1, J1.2, J2.1, J2.2, NRF24LO1.P$8 (GND), R4.1, ROTATE1.3, ROTATE2.3, U$6.12, U$8.2, XQ-02A.GND, XQ-02A.GND1 (GND), XQ-02A.GND2 (GND), XQ-02A.GND3 (GND), XQ-02A.GND4 (GND), XQ-02A.GND5 (GND)
IRQ_RADIO: NRF24LO1.P$7 (IRQ), U$7.3
LATCH_SR: U$6.5, U$8.9
MISO_RADIO: NRF24LO1.P$6 (MISO), U$7.5
MISO_SR: U$6.8, U$8.6
MOSI_RADIO: NRF24LO1.P$5 (MOSI), U$7.4
MOSI_SR: U$6.9, U$8.5
unnamed: LED1.C, R1.2
unnamed: LED2.C, R2.2
unnamed: LED1.A, ROTATE1.2 (PIN)
unnamed: LED2.A, ROTATE2.2 (PIN)
unnamed: R2.1, XQ-02A.LED2
unnamed: R1.1, XQ-02A.LED1
unnamed: R3.2, SW.1
unnamed: R4.2, SW.3
OE_SR: U$6.6, U$8.8
RF-IN: J1.3, XQ-02A.RF-IN
RX1_BLE: U$6.4, U$8.10
RX2_GPS: GPS-NEO7M.P$3 (TX), U$7.8
SCK_RADIO: NRF24LO1.P$4 (SCK), U$7.6
SCK_SR: U$6.7, U$8.7
STEP_DRIVER: U$6.1, U$8.13
SW: SW.2 (PIN), XQ-02A.SW
TX1_BLE: U$6.3, U$8.11
TX2_GPS: GPS-NEO7M.P$2 (RX), U$7.7

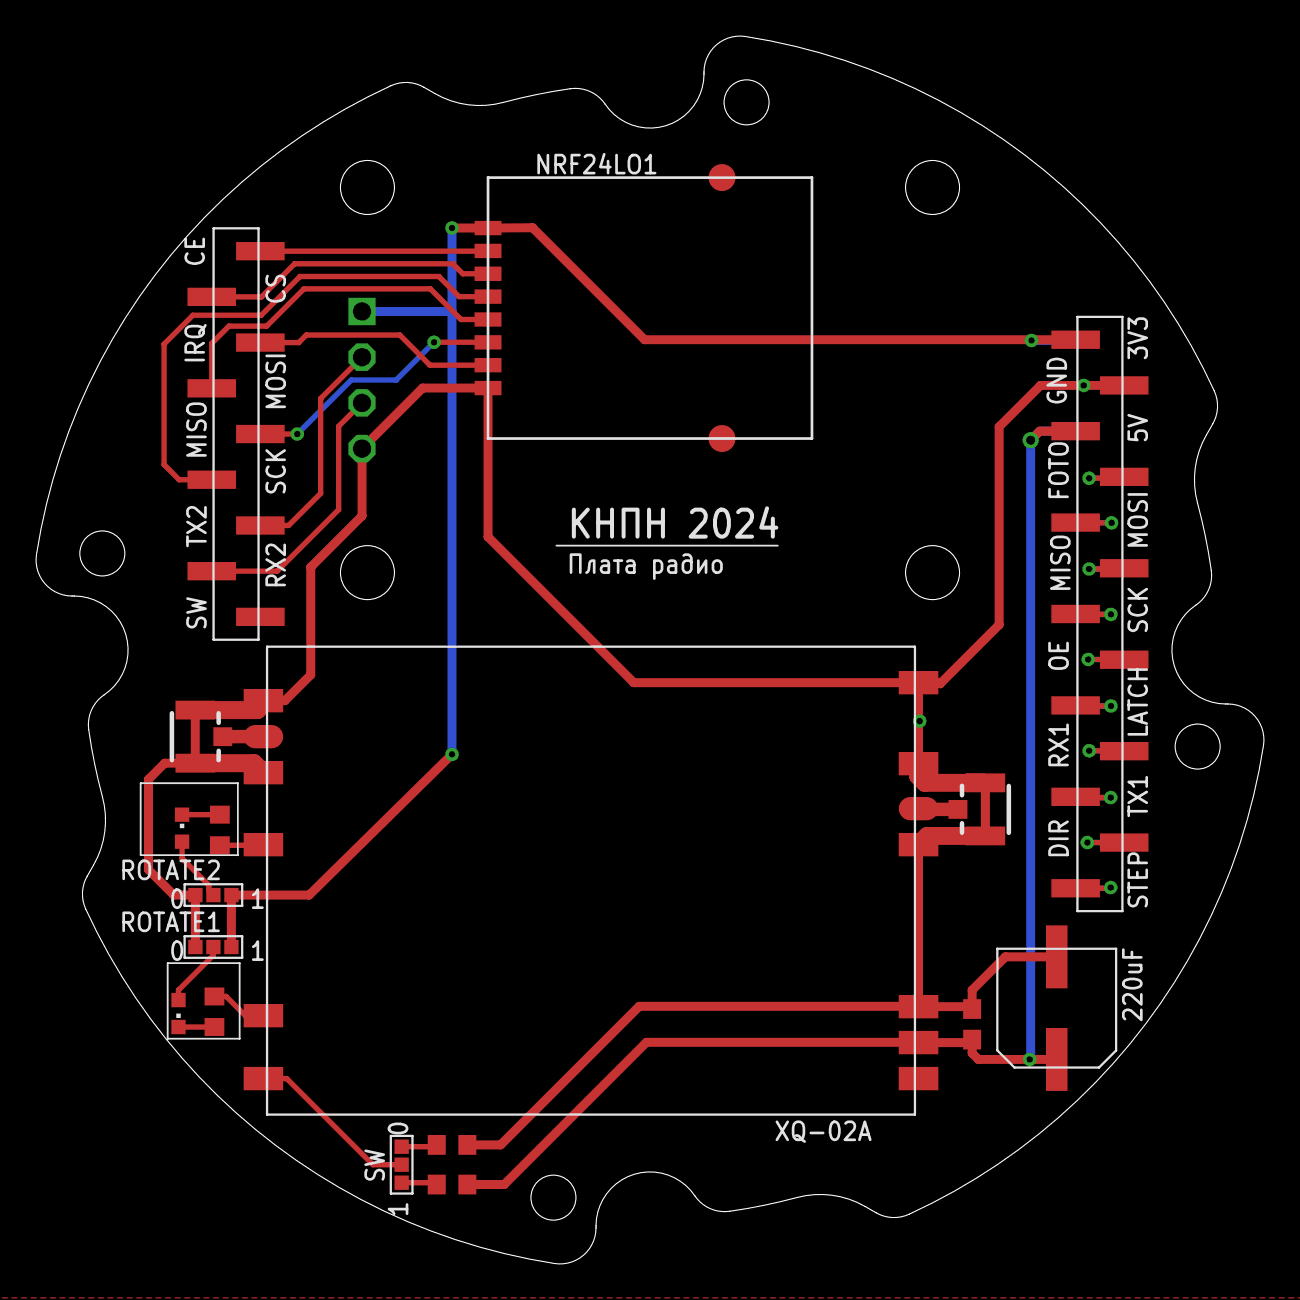
[picture p97: board RADIO.brd from above]

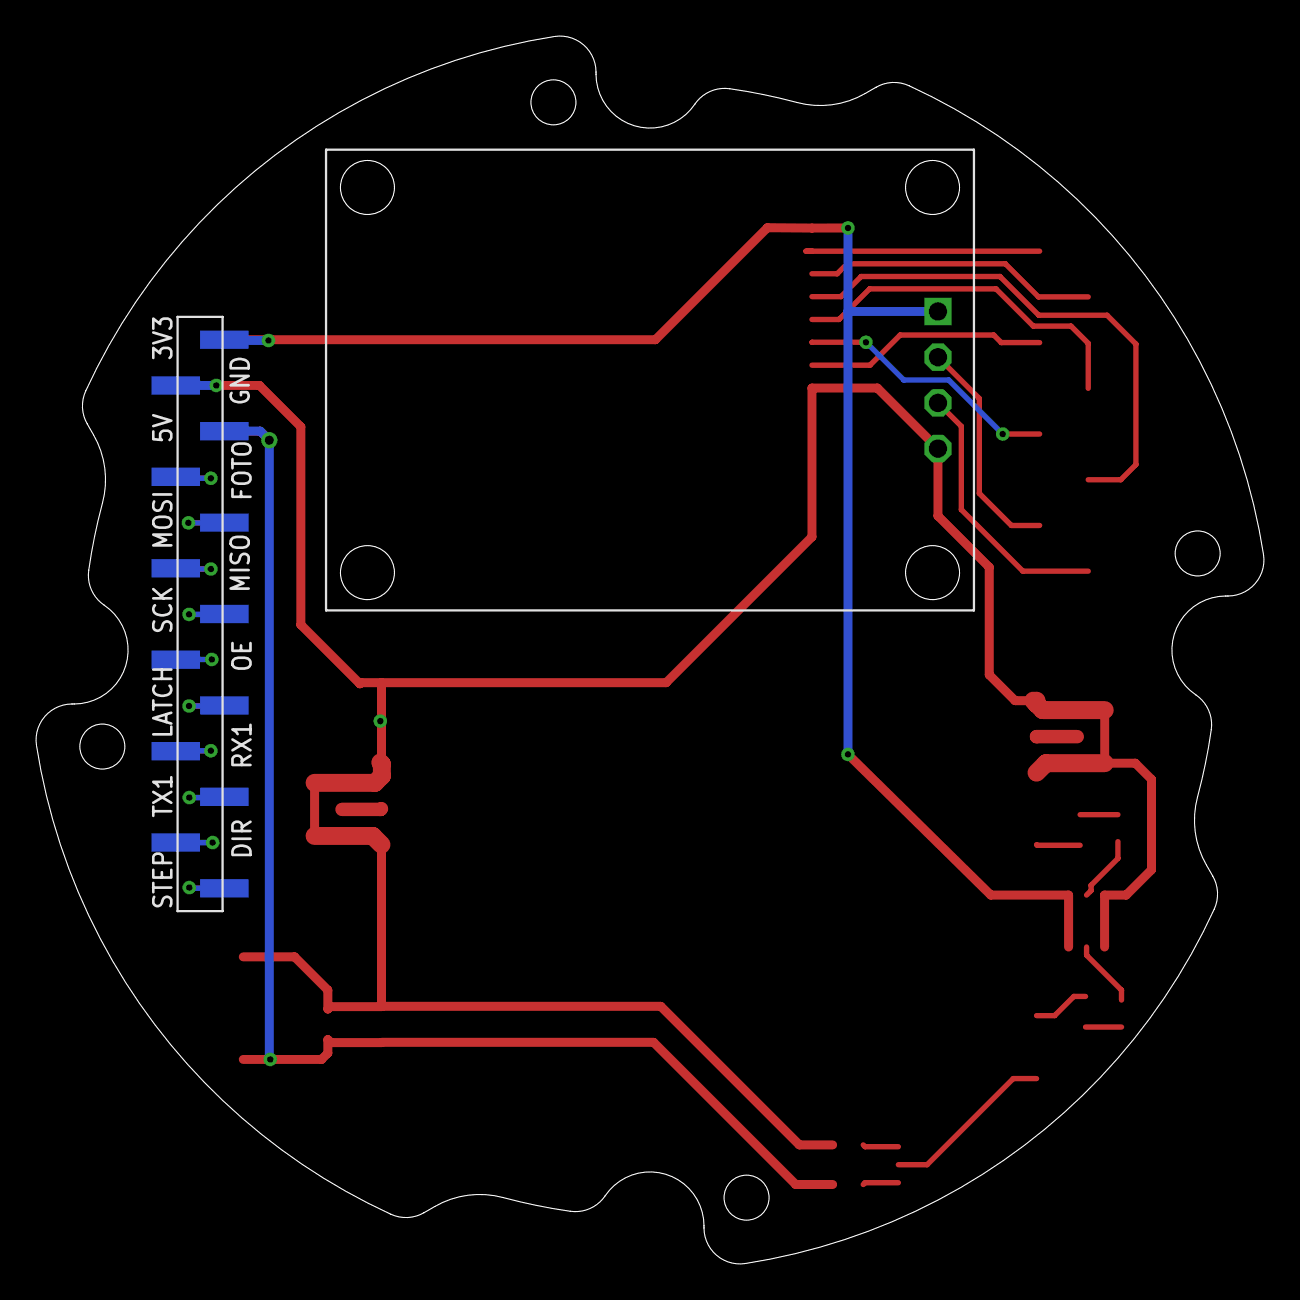
[picture p98: board RADIO.brd from below]

Board: 2 copper layers, 68.2 x 68.2 mm, 20 parts (2 on the bottom side), 32 nets.
