cansat-tsniimash/UNKNOWN-2024/src/board/UNKNOWN/UNKNOWN.ioc

Mcu.UserName=STM32F411CEUx
PA0-WKUP.Signal=ADCx_IN0
PA1.Signal=SPI4_MOSI
PA10.GPIO_Label=step
PA10.Signal=GPIO_Output
PA11.Signal=SPI4_MISO
PA13.Signal=SYS_JTMS-SWDIO
PA14.Signal=SYS_JTCK-SWCLK
PA15.Signal=USART1_TX
PA2.Signal=USART2_TX
PA3.Signal=USART2_RX
PA4.Signal=GPIO_Input
PA5.Signal=SPI1_SCK
PA6.Signal=SDIO_CMD
PA8.GPIO_Label=oe
PA8.Signal=GPIO_Output
PA9.GPIO_Label=dir
PA9.Signal=GPIO_Output
PB0.Signal=GPIO_Output
PB12.Signal=GPIO_Input
PB13.Signal=SPI4_SCK
PB14.GPIO_Label=latch
PB14.Signal=GPIO_Output
PB15.Signal=SDIO_CK
PB3.Signal=USART1_RX
PB4.Signal=SPI1_MISO
PB5.Signal=SPI1_MOSI
PB7.Signal=SDIO_D0
PB8.Signal=I2C1_SCL
PB9.Signal=I2C1_SDA
PC13-ANTI_TAMP.GPIO_Label=ce
PC13-ANTI_TAMP.Signal=GPIO_Output
PC14-OSC32_IN.GPIO_Label=cs
PC14-OSC32_IN.Signal=GPIO_Output
PC15-OSC32_OUT.GPIO_Label=irq
PC15-OSC32_OUT.Signal=GPIO_Input
