cansat-tsniimash/UNKNOWN-2024/src/board/raspberry pi zero2w/main/main.py

import socket
import time
import select
from picamera2 import Picamera2
import RPi.GPIO as GPIO
import time

def setAngle(serv, ang):
    duty = ang / 15
    serv.ChangeDutyCycle(duty)


picam2 = Picamera2()

addr = '98:DA:60:09:D8:C9'


poller = select.epoll()
sock = socket.socket(socket.AF_BLUETOOTH, socket.SOCK_STREAM, socket.BTPROTO_RFCOMM)
sock.connect((addr, 1))


GPIO.setmode(GPIO.BCM)
GPIO.setup(18, GPIO.OUT)
servo = GPIO.PWM(18, 50)
servo_deadline = 0
servo_period = 1.0

last_angle = 30

poller.register(sock.fileno(), select.EPOLLIN | select.EPOLLERR)

while True:
	poll_rc = poller.poll()
	if not poll_rc:
		continue
	
	data = sock.recv(4096)
	#print(data)
	if(data[4] == 0):
		word = data[0:4].decode("ascii")
	else:
		word = data[0:5].decode("ascii")
	#print(word)
	if word == "start":
		picam2.start_and_record_video(output="/home/knpn/main/main_video.mp4", duration=0)
		servo.start(0)
		time.sleep(1)
		setAngle(servo, 30)
		last_angle = 30
		print('i started')
		word = ""
	if word == "stop":
		picam2.stop_recording()
		servo.stop()
		print("stoped")
		GPIO.cleanup()
		word = ""
	if word == "angle":
		angle = float(data[6:11].decode("ascii"))
		angle += 90
		print(angle)
		if(angle<1):
			continue
		setAngle(servo, angle)#min 30, max 150
		word = ""
