cansat-tsniimash/UNKNOWN-2024/src/strela/StrelA-MS/source/settings_control.py

from PyQt5 import QtWidgets, QtGui, QtCore
import os.path
import yaml
import re
from source import RES_ROOT, USER_SETTINGS_PATH

DEFAULT_SETTINGS_PATH = os.path.join(RES_ROOT, "StrelA_MS_default.yml")

APP_ICON_PATH = os.path.join(RES_ROOT, "images/StrelA_MS.png")
WINDOW_ICON_PATH = os.path.join(RES_ROOT, "images/window.png")
MAP_ICON_PATH = os.path.join(RES_ROOT, "images/map.png")
MODEL_ICON_PATH = os.path.join(RES_ROOT, "images/model.png")
GRAPH_ICON_PATH = os.path.join(RES_ROOT, "images/graph.png")

SETTINGS_PATH = USER_SETTINGS_PATH
if 'STRELA_MS_CONFIG' in os.environ:
    if os.path.exists(os.environ['STRELA_MS_CONFIG']):
        SETTINGS_PATH = os.environ['STRELA_MS_CONFIG']


class Settings():
    class Settings_data():
        file_path = None
        def __new__(self, *args, **kwargs):
            if not hasattr(self, '_instance'):
                self._instance = super(Settings.Settings_data, self).__new__(self)
            return self._instance

        def __init__(self, file_path):
            self.file_path = os.path.abspath(file_path)
            try:
                self.load()
            except FileNotFoundError:
                self.data = {}
                self.save()

        def fileName(self):
            return self.file_path

        def get_data(self, path_list,  data=None):
            if data is None:
                cell = self.data
            else:
                cell = data
            for name in path_list[0:-1]:
                cell = cell.get(name, {})
            return cell.get(path_list[-1], None)

        def update_data(self, path_list, value, data=None):
            if data is None:
                cell = self.data
            else:
                cell = data
            if len(path_list) > 1:
                cell.update({path_list[0] : self.update_data(path_list[1:], value, cell.get(path_list[0], {}))})
            else:
                cell.update({path_list[0] : value})
            return cell

        def load(self):
            file = open(self.file_path, 'r', encoding = "utf-8")
            self.data = yaml.load(file, Loader=yaml.SafeLoader)
            if self.data is None:
                self.data = {}
            file.close()

        def save(self):
            file = open(self.file_path, 'w', encoding = "utf-8")
            yaml.dump(self.data, file, default_flow_style = False, allow_unicode = True, encoding = None)
            file.close()


    def __init__(self, path):
        self.data = Settings.Settings_data(path)
        self.prefix_list = []

    def fileName(self):
        return self.data.fileName()

    def setValue(self, path, value):
        path_list = []
        for part in self.prefix_list:
            path_list.extend(part)
        path_list.extend(self.path_to_list(path))
        self.data.update_data(path_list, value)

    def value(self, path):
        path_list = []
        for part in self.prefix_list:
            path_list.extend(part)
        path_list.extend(self.path_to_list(path))
        value = self.data.get_data(path_list)
        return value

    def path_to_list(self, path):
        if path[-1] == '/':
            raise ValueError('Invalid parameter path %s' % path)
        return re.split(r'/', path)

    def beginGroup(self, path):
        self.prefix_list.append(self.path_to_list(path))

    def endGroup(self):
        self.prefix_list.pop()

    def childGroups(self):
        path_list = []
        for part in self.prefix_list:
            path_list.extend(part)
        group_list = []
        data = self.data.get_data(path_list)
        if (data is not None) and (isinstance(data, dict)):
            for cell in data.items():
                if isinstance(cell[1], dict):
                    group_list.append(cell[0])
        return group_list

    def childKeys(self):
        path_list = []
        for part in self.prefix_list:
            path_list.extend(part)
        keys_list = []
        data = self.data.get_data(path_list)
        if (data is not None) and (isinstance(data, dict)):
            for cell in data.items():
                if not isinstance(cell[1], dict):
                    keys_list.append(cell[0])
        return keys_list


def init_settings():
    if not os.path.exists(SETTINGS_PATH):
        set_to_default(SETTINGS_PATH)
    settings = Settings(SETTINGS_PATH)
    return settings

def set_to_default(file_path):
    config = open(file_path, 'w')
    def_config = open(DEFAULT_SETTINGS_PATH, 'r')
    for line in def_config:
        config.write(line)
    config.close()
    def_config.close()

class AbstractProperties(QtWidgets.QWidget):
    def __init__(self):
        super(AbstractProperties, self).__init__()
        self.settings = init_settings()

        self.setup_ui()
        self.setup_ui_design()

    def setup_ui(self):
        self.grid_layout = QtWidgets.QGridLayout(self)
        self.apply_btn = QtWidgets.QPushButton()
        self.apply_btn.setSizePolicy(QtWidgets.QSizePolicy.Fixed, QtWidgets.QSizePolicy.Fixed)
        self.default_btn = QtWidgets.QPushButton()
        self.default_btn.setSizePolicy(QtWidgets.QSizePolicy.Fixed, QtWidgets.QSizePolicy.Fixed)

    def add_btn(self):
        self.grid_layout.setRowStretch(self.grid_layout.rowCount(), 1)
        self.grid_layout.addWidget(self.default_btn, self.grid_layout.rowCount(), 0)
        self.grid_layout.addWidget(self.apply_btn, self.grid_layout.rowCount() - 1, self.grid_layout.columnCount() - 1)

    def setup_ui_design(self):
        self.apply_btn.setText("Apply")
        self.default_btn.setText("Set to default")

    def add_h_line(self, width):
        frame = QtWidgets.QFrame()
        frame.setFrameStyle(QtWidgets.QFrame.Plain)
        frame.setFrameShape(QtWidgets.QFrame.HLine)
        frame.setLineWidth(width)
        self.grid_layout.addWidget(frame, self.grid_layout.rowCount(), 0, 1, -1)

    def add_edit_group(self, edit_num):
        edit_group = [QtWidgets.QLabel()]
        self.grid_layout.addWidget(edit_group[0], self.grid_layout.rowCount(), 0)
        for i in range(1, edit_num + 1):
            edit_group.append(QtWidgets.QLineEdit())
            self.grid_layout.addWidget(edit_group[i], self.grid_layout.rowCount() - 1, i)
        return edit_group

    def add_check_box(self, mode):
        check_box = [QtWidgets.QLabel(), QtWidgets.QCheckBox()]
        check_box[1].setTristate(mode)
        self.grid_layout.addWidget(check_box[0], self.grid_layout.rowCount(), 0)
        self.grid_layout.addWidget(check_box[1], self.grid_layout.rowCount() - 1, 1)
        return check_box

    def add_combo_box(self):
        combo_box = [QtWidgets.QLabel(), QtWidgets.QComboBox()]
        self.grid_layout.addWidget(combo_box[0], self.grid_layout.rowCount(), 0)
        self.grid_layout.addWidget(combo_box[1], self.grid_layout.rowCount() - 1, 1, 1, -1)
        return combo_box

    def read_from_edit_group(self, edit_group, value_name, func):
        try:
            if (len(edit_group) > 2):
                value = []
                for edit in edit_group[1:]:
                    value.append(func(edit.text()))
            else:
                value = func(edit_group[1].text())
            self.settings.setValue(value_name, value)
        except Exception as e:
            print(e)


class CommonProperties(AbstractProperties):
    def __init__(self):
        super(CommonProperties, self).__init__()

    def setup_ui(self):
        super(CommonProperties, self).setup_ui()
        self.main_window_size = self.add_edit_group(2)
        self.add_btn()

    def setup_ui_design(self):
        super(CommonProperties, self).setup_ui_design()
        self.settings.beginGroup("MainWindow")
        self.main_window_size[0].setText('Window size')
        for i in range(2):
            self.main_window_size[i + 1].setText(str(self.settings.value('size')[i]))
        self.settings.endGroup()

    def save_properties(self):
        self.settings.beginGroup("MainWindow")
        self.read_from_edit_group(self.main_window_size, 'size', int)
        self.settings.endGroup()


class GraphProperties(AbstractProperties):
    class PlotPropertiesWidget(AbstractProperties):
        def __init__(self, plot):
            self.change_plot(plot)
            super(GraphProperties.PlotPropertiesWidget, self).__init__()

        def change_plot(self, plot):
            self.plot = plot

        def setup_ui(self):
            super(GraphProperties.PlotPropertiesWidget, self).setup_ui()
            self.name_label = QtWidgets.QLabel()
            self.name_label.setAlignment(QtCore.Qt.AlignHCenter)
            self.grid_layout.addWidget(self.name_label, self.grid_layout.rowCount(), 0, 1, -1)
            self.curve_count = self.add_edit_group(1)
            self.curve_colour = self.add_edit_group(1)

        def setup_ui_design(self):
            super(GraphProperties.PlotPropertiesWidget, self).setup_ui_design()
            self.name_label.setText("Curve properties for " + self.plot + " plot")
            self.settings.beginGroup("CentralWidget/GraphWidget/Graph/" + self.plot)
            self.curve_count[0].setText('Curves count')
            self.curve_count[1].setText(str(self.settings.value('count')))
            self.curve_colour[0].setText('Curves colour\n(b,g,r,c,m,y,k,w)')
            self.curve_colour[1].setText(str(self.settings.value('colour')))
            self.settings.endGroup()

        def save_properties(self):
            self.settings.beginGroup("CentralWidget/GraphWidget/Graph/" + self.plot)
            self.read_from_edit_group(self.curve_count, 'count', int)
            self.read_from_edit_group(self.curve_colour, 'colour', str)
            while len(self.settings.value('colour')) < self.settings.value('count'):
                self.settings.setValue('colour', self.settings.value('colour') + 'g')
            self.settings.endGroup()

    def upload_plots(self):
        self.settings.beginGroup("CentralWidget/GraphWidget/Graph")
        groups = self.settings.childGroups()
        self.settings.endGroup()
        return groups

    def setup_ui(self):
        super(GraphProperties, self).setup_ui()
        self.graph_check_box = self.add_check_box(False)
        self.graph_position = self.add_edit_group(4)
        self.add_h_line(2)
        self.plot_dict = {}
        for group in self.upload_plots():
            self.plot_dict.update([(group, [self.add_check_box(False), self.add_edit_group(4)])])
            self.add_h_line(1)
        self.plot_combo_box = self.add_combo_box()
        self.plot_combo_box[1].addItems(self.upload_plots())
        self.plot_combo_box[1].activated.connect(self.change_plot_properties)
        self.property  = GraphProperties.PlotPropertiesWidget(self.plot_combo_box[1].currentText())
        self.grid_layout.addWidget(self.property, self.grid_layout.rowCount(), 0, 1, -1)
        self.add_btn()

    def upload_plots_position(self):
        for plot in self.plot_dict.items():
            self.settings.beginGroup("CentralWidget/GraphWidget/Graph/" + plot[0])
            check_box = plot[1][0]
            edit_group = plot[1][1]
            check_box[0].setText(plot[0] + ' plot')
            check_box[1].setCheckState(int(self.settings.value('is_on')))
            edit_group[0].setText('Position (position, span)')
            for i in range(4):
                edit_group[i + 1].setText(str(self.settings.value('position')[i]))
            self.settings.endGroup()

    def setup_ui_design(self):
        super(GraphProperties, self).setup_ui_design()
        self.settings.beginGroup("CentralWidget/GraphWidget")
        self.graph_check_box[0].setText('Graph widget')
        self.graph_check_box[1].setCheckState(int(self.settings.value('is_on')))
        self.graph_position[0].setText('Widget position (position, span)')
        for i in range(4):
            self.graph_position[i + 1].setText(str(self.settings.value('position')[i]))
        self.plot_combo_box[0].setText('Graph')
        self.settings.endGroup()
        self.upload_plots_position()

    def change_plot_properties(self):
        self.property.change_plot(self.plot_combo_box[1].currentText())
        self.property.setup_ui_design()

    def save_plots_position(self):
        for plot in self.plot_dict.items():
            self.settings.beginGroup("CentralWidget/GraphWidget/Graph/" + plot[0])
            check_box = plot[1][0]
            edit_group = plot[1][1]
            self.settings.setValue('is_on', check_box[1].checkState())
            self.read_from_edit_group(edit_group, 'position', int)
            self.settings.endGroup()

    def save_properties(self):
        self.settings.beginGroup("CentralWidget/GraphWidget")
        self.settings.setValue('is_on', self.graph_check_box[1].checkState()) 
        self.read_from_edit_group(self.graph_position, 'position', int)
        self.settings.endGroup()
        self.save_plots_position()
        self.property.save_properties()


class MapProperties(AbstractProperties):
    def __init__(self):
        super(MapProperties, self).__init__()


class ModelProperties(AbstractProperties):
    def __init__(self):
        super(ModelProperties, self).__init__()


class SettingsWindow(QtWidgets.QMainWindow):
    change_settings = QtCore.pyqtSignal()

    def __init__(self):
        super(SettingsWindow, self).__init__()
        self.settings = init_settings()

        self.setWindowIcon(QtGui.QIcon(APP_ICON_PATH))
        self.resize(400, 600)
        self.setSizePolicy(QtWidgets.QSizePolicy.Fixed, QtWidgets.QSizePolicy.Fixed)
        self.move_to_center()

        self.setup_ui()
        self.setup_ui_design()

    def setup_ui(self):
        self.toolbar = self.addToolBar('Settings')
        self.toolbar.setMovable(False)
        self.toolbar.setIconSize(QtCore.QSize(50, 50))
        self.toolbar.setContextMenuPolicy(QtCore.Qt.PreventContextMenu)

        self.central_widget_btn = self.toolbar.addAction(QtGui.QIcon(WINDOW_ICON_PATH), 'Common')
        self.central_widget_btn.triggered.connect(self.show_common_properties)
        self.GraphProperties_btn = self.toolbar.addAction(QtGui.QIcon(GRAPH_ICON_PATH), 'Graph')
        self.GraphProperties_btn.triggered.connect(self.show_graph_properties)
        self.MapProperties_btn = self.toolbar.addAction(QtGui.QIcon(MAP_ICON_PATH), 'Map')
        self.MapProperties_btn.triggered.connect(self.show_map_properties)
        self.ModelProperties_btn = self.toolbar.addAction(QtGui.QIcon(MODEL_ICON_PATH), 'Model')
        self.ModelProperties_btn.triggered.connect(self.show_model_properties)

        self.show_common_properties()

    def setup_ui_design(self):
        self.central_widget.setup_ui_design()

    def set_settings_to_default(self):
        settings_control.set_to_default(self.settings)
        self.settings = init_settings()
        self.setup_ui_design()
        self.change_settings.emit()
        
    def show_common_properties(self):
        self.central_widget = CommonProperties()
        self.show_central_widget()

    def show_graph_properties(self):
        self.central_widget = GraphProperties()
        self.show_central_widget()

    def show_map_properties(self):
        self.central_widget = MapProperties()
        self.show_central_widget()

    def show_model_properties(self):
        self.central_widget = ModelProperties()
        self.show_central_widget()

    def show_central_widget(self):
        self.central_widget.default_btn.clicked.connect(self.set_settings_to_default)
        self.central_widget.apply_btn.clicked.connect(self.set_properties)
        if self.centralWidget() is not None:
            self.takeCentralWidget()

        self.setCentralWidget(self.central_widget)

    def settings_enabled(self, mode):
        self.central_widget.setEnabled(mode)

    def set_properties(self):
        self.central_widget.save_properties()
        self.change_settings.emit()

    def removeToolBar(self, toolbar):
        super(SettingsWindow, self).removeToolBar()

    def show(self):
        self.hide()
        super(SettingsWindow, self).show()

    def move_to_center(self):
        frame = self.frameGeometry()
        frame.moveCenter(QtWidgets.QDesktopWidget().availableGeometry().center())
        self.move(frame.topLeft())
