cansat-tsniimash/UNKNOWN-2024/lib-tsniimash/stm32f1/BME280/DriverForBME280.h

/*
 * Данные два рукотворных файлы программиста П (DBME280.c, DBME280.h) являются всего лишь прокладками, соединяющими,
 * упрощающими и сокращающими огромные строки кода из файлов папки BME280 и её подпапки src, которые написаны
 * программистами компании Bosh.
 */


#ifndef DRIVER_FOR_BME280_H_
#define DRIVER_FOR_BME280_H_

#include <stm32f1xx_hal.h>


#ifdef HAL_SPI_MODULE_ENABLED


#include <stdio.h>
#include "bme280.h"
#include "..\Shift_Register\shift_reg.h"



//Структура, содержащая в себе информацию о порте и пине подключения SPI CS
struct bme_spi_intf
{
	GPIO_TypeDef  *GPIO_Port;
	uint16_t GPIO_Pin;
	SPI_HandleTypeDef* spi;
};



struct bme_spi_intf_sr
{
	int sr_pin;
	SPI_HandleTypeDef* spi;
	//Shift reg device
	shift_reg_t *sr;
};
typedef struct bme_spi_intf_sr bme_spi_intf_sr;


/*
 * Создаёт дефолтные настройки, которые написал я и немцы, которые придумали датчик
 * spi_intf - настройка интерфейса SPI
 */
void bme_init_default( struct bme280_dev *bme, struct bme_spi_intf* spi_intf);

// Чтение данных с БМЕ280, может возвращать давление, влажность и температуру
struct bme280_data bme_read_data(struct bme280_dev *bme);



void bme_init_default_sr( struct bme280_dev *bme, struct bme_spi_intf_sr* spi_intf);

#endif // HAL_SPI_MODULE_ENABLED

#endif // DRIVER_FOR_BME280_H_
