cansat-tsniimash/UNKNOWN-2024/lib-tsniimash/stm32f1/LSM6DS3/src/lsm6ds3_reg.c

/**
  ******************************************************************************
  * @file    lsm6ds3_reg.c
  * @author  Sensors Software Solution Team
  * @brief   LSM6DS3 driver file
  ******************************************************************************
  * @attention
  *
  * <h2><center>&copy; Copyright (c) 2021 STMicroelectronics.
  * All rights reserved.</center></h2>
  *
  * This software component is licensed by ST under BSD 3-Clause license,
  * the "License"; You may not use this file except in compliance with the
  * License. You may obtain a copy of the License at:
  *                        opensource.org/licenses/BSD-3-Clause
  *
  ******************************************************************************
  */

# include "..\lsm6ds3_reg.h"

/**
  * @defgroup    LSM6DS3
  * @brief       This file provides a set of functions needed to drive the
  *              lsm6ds3 enhanced inertial module.
  * @{
  *
  */

/**
  * @defgroup    LSM6DS3_Interfaces_Functions
  * @brief       This section provide a set of functions used to read and
  *              write a generic register of the device.
  *              MANDATORY: return 0 -> no Error.
  * @{
  *
  */

/**
  * @brief  Read generic device register
  *
  * @param  ctx   read / write interface definitions(ptr)
  * @param  reg   register to read
  * @param  data  pointer to buffer that store the data read(ptr)
  * @param  len   number of consecutive register to read
  * @retval       interface status (MANDATORY: return 0 -> no Error)
  *
  */
int32_t lsm6ds3_read_reg(stmdev_ctx_t *ctx, uint8_t reg,
                         uint8_t *data,
                         uint16_t len)
{
  int32_t ret;

  ret = ctx->read_reg(ctx->handle, reg, data, len);

  return ret;
}

/**
  * @brief  Write generic device register
  *
  * @param  ctx   read / write interface definitions(ptr)
  * @param  reg   register to write
  * @param  data  pointer to data to write in register reg(ptr)
  * @param  len   number of consecutive register to write
  * @retval       interface status (MANDATORY: return 0 -> no Error)
  *
  */
int32_t lsm6ds3_write_reg(stmdev_ctx_t *ctx, uint8_t reg,
                          uint8_t *data,
                          uint16_t len)
{
  int32_t ret;

  ret = ctx->write_reg(ctx->handle, reg, data, len);

  return ret;
}

/**
  * @}
  *
  */

/**
  * @defgroup    LSM6DS3_Sensitivity
  * @brief       These functions convert raw-data into engineering units.
  * @{
  *
  */

float_t lsm6ds3_from_fs2g_to_mg(int16_t lsb)
{
  return ((float_t)lsb * 61.0f / 1000.0f);
}

float_t lsm6ds3_from_fs4g_to_mg(int16_t lsb)
{
  return ((float_t)lsb * 122.0f / 1000.0f);
}

float_t lsm6ds3_from_fs8g_to_mg(int16_t lsb)
{
  return ((float_t)lsb * 244.0f / 1000.0f);
}

float_t lsm6ds3_from_fs16g_to_mg(int16_t lsb)
{
  return ((float_t)lsb * 488.0f / 1000.0f);
}

float_t lsm6ds3_from_fs125dps_to_mdps(int16_t lsb)
{
  return ((float_t)lsb   * 4375.0f / 1000.0f);
}

float_t lsm6ds3_from_fs250dps_to_mdps(int16_t lsb)
{
  return ((float_t)lsb  * 8750.0f / 1000.0f);
}

float_t lsm6ds3_from_fs500dps_to_mdps(int16_t lsb)
{
  return ((float_t)lsb * 1750.0f / 100.0f);
}

float_t lsm6ds3_from_fs1000dps_to_mdps(int16_t lsb)
{
  return ((float_t)lsb * 35.0f);
}

float_t lsm6ds3_from_fs2000dps_to_mdps(int16_t lsb)
{
  return ((float_t)lsb * 70.0f);
}

float_t lsm6ds3_from_lsb_to_celsius(int16_t lsb)
{
  return ((float_t)lsb / 16.0f + 25.0f);
}

/**
  * @}
  *
  */

/**
  * @defgroup    LSM6DS3_Data_generation
  * @brief       This section groups all the functions concerning
  *              data generation
  * @{
  *
  */

/**
  * @brief   Gyroscope directional user-orientation selection.[set]
  *
  * @param  ctx      read / write interface definitions(ptr)
  * @param  val      change the values of orient in reg  LSM6DS3
  * @retval          interface status (MANDATORY: return 0 -> no Error)
  *
  */
int32_t lsm6ds3_gy_data_orient_set(stmdev_ctx_t *ctx,
                                   lsm6ds3_gy_orient_t val)
{
  lsm6ds3_orient_cfg_g_t orient_cfg_g;
  int32_t ret;

  ret = lsm6ds3_read_reg(ctx, LSM6DS3_ORIENT_CFG_G,
                         (uint8_t *)&orient_cfg_g, 1);

  if (ret == 0)
  {
    orient_cfg_g.orient = (uint8_t)val;
    ret = lsm6ds3_write_reg(ctx, LSM6DS3_ORIENT_CFG_G,
                            (uint8_t *)&orient_cfg_g, 1);
  }

  return ret;
}

/**
  * @brief   Gyroscope directional user-orientation selection.[get]
  *
  * @param  ctx         read / write interface definitions(ptr)
  * @param  val         get the values of orient in reg ORIENT_CFG_G
  * @retval             interface status (MANDATORY: return 0 -> no Error)
  *
  */
int32_t lsm6ds3_gy_data_orient_get(stmdev_ctx_t *ctx,
                                   lsm6ds3_gy_orient_t *val)
{
  lsm6ds3_orient_cfg_g_t orient_cfg_g;
  int32_t ret;

  ret = lsm6ds3_read_reg(ctx, LSM6DS3_ORIENT_CFG_G,
                         (uint8_t *)&orient_cfg_g, 1);

  switch (orient_cfg_g.orient)
  {
    case LSM6DS3_GY_ORIENT_XYZ:
      *val = LSM6DS3_GY_ORIENT_XYZ;
      break;

    case LSM6DS3_GY_ORIENT_XZY:
      *val = LSM6DS3_GY_ORIENT_XZY;
      break;

    case LSM6DS3_GY_ORIENT_YXZ:
      *val = LSM6DS3_GY_ORIENT_YXZ;
      break;

    case LSM6DS3_GY_ORIENT_YZX:
      *val = LSM6DS3_GY_ORIENT_YZX;
      break;

    case LSM6DS3_GY_ORIENT_ZXY:
      *val = LSM6DS3_GY_ORIENT_ZXY;
      break;

    case LSM6DS3_GY_ORIENT_ZYX:
      *val = LSM6DS3_GY_ORIENT_ZYX;
      break;

    default:
      *val = LSM6DS3_GY_ORIENT_XYZ;
      break;
  }

  return ret;
}

/**
  * @brief  angular rate sign.[set]
  *
  * @param  ctx      read / write interface definitions(ptr)
  * @param  val      change the values of sign_g in reg  LSM6DS3
  * @retval          interface status (MANDATORY: return 0 -> no Error)
  *
  */
int32_t lsm6ds3_gy_data_sign_set(stmdev_ctx_t *ctx,
                                 lsm6ds3_gy_sgn_t val)
{
  lsm6ds3_orient_cfg_g_t orient_cfg_g;
  int32_t ret;

  ret = lsm6ds3_read_reg(ctx, LSM6DS3_ORIENT_CFG_G,
                         (uint8_t *)&orient_cfg_g, 1);

  if (ret == 0)
  {
    orient_cfg_g.sign_g = (uint8_t)val;
    ret = lsm6ds3_write_reg(ctx, LSM6DS3_ORIENT_CFG_G,
                            (uint8_t *)&orient_cfg_g, 1);
  }

  return ret;
}

/**
  * @brief  angularratesign.[get]
  *
  * @param  ctx         read / write interface definitions(ptr)
  * @param  val         get the values of sign_g in reg ORIENT_CFG_G
  * @retval             interface status (MANDATORY: return 0 -> no Error)
  *
  */
int32_t lsm6ds3_gy_data_sign_get(stmdev_ctx_t *ctx,
                                 lsm6ds3_gy_sgn_t *val)
{
  lsm6ds3_orient_cfg_g_t orient_cfg_g;
  int32_t ret;

  ret = lsm6ds3_read_reg(ctx, LSM6DS3_ORIENT_CFG_G,
                         (uint8_t *)&orient_cfg_g, 1);

  switch (orient_cfg_g.sign_g)
  {
    case LSM6DS3_GY_SIGN_PPP:
      *val = LSM6DS3_GY_SIGN_PPP;
      break;

    case LSM6DS3_GY_SIGN_PPN:
      *val = LSM6DS3_GY_SIGN_PPN;
      break;

    case LSM6DS3_GY_SIGN_PNP:
      *val = LSM6DS3_GY_SIGN_PNP;
      break;

    case LSM6DS3_GY_SIGN_NPP:
      *val = LSM6DS3_GY_SIGN_NPP;
      break;

    case LSM6DS3_GY_SIGN_NNP:
      *val = LSM6DS3_GY_SIGN_NNP;
      break;

    case LSM6DS3_GY_SIGN_NPN:
      *val = LSM6DS3_GY_SIGN_NPN;
      break;

    case LSM6DS3_GY_SIGN_PNN:
      *val = LSM6DS3_GY_SIGN_PNN;
      break;

    case LSM6DS3_GY_SIGN_NNN:
      *val = LSM6DS3_GY_SIGN_NNN;
      break;

    default:
      *val = LSM6DS3_GY_SIGN_PPP;
      break;
  }

  return ret;
}

/**
  * @brief   Accelerometer full-scale selection.[set]
  *
  * @param  ctx      read / write interface definitions(ptr)
  * @param  val      change the values of fs_xl in reg  LSM6DS3
  * @retval          interface status (MANDATORY: return 0 -> no Error)
  *
  */
int32_t lsm6ds3_xl_full_scale_set(stmdev_ctx_t *ctx,
                                  lsm6ds3_xl_fs_t val)
{
  lsm6ds3_ctrl1_xl_t ctrl1_xl;
  int32_t ret;

  ret = lsm6ds3_read_reg(ctx, LSM6DS3_CTRL1_XL, (uint8_t *)&ctrl1_xl, 1);

  if (ret == 0)
  {
    ctrl1_xl.fs_xl = (uint8_t)val;
    ret = lsm6ds3_write_reg(ctx, LSM6DS3_CTRL1_XL, (uint8_t *)&ctrl1_xl, 1);
  }

  return ret;
}

/**
  * @brief   Accelerometer full-scale selection.[get]
  *
  * @param  ctx         read / write interface definitions(ptr)
  * @param  val         get the values of fs_xl in reg CTRL1_XL
  * @retval             interface status (MANDATORY: return 0 -> no Error)
  *
  */
int32_t lsm6ds3_xl_full_scale_get(stmdev_ctx_t *ctx,
                                  lsm6ds3_xl_fs_t *val)
{
  lsm6ds3_ctrl1_xl_t ctrl1_xl;
  int32_t ret;

  ret = lsm6ds3_read_reg(ctx, LSM6DS3_CTRL1_XL, (uint8_t *)&ctrl1_xl, 1);

  switch (ctrl1_xl.fs_xl)
  {
    case LSM6DS3_2g:
      *val = LSM6DS3_2g;
      break;

    case LSM6DS3_16g:
      *val = LSM6DS3_16g;
      break;

    case LSM6DS3_4g:
      *val = LSM6DS3_4g;
      break;

    case LSM6DS3_8g:
      *val = LSM6DS3_8g;
      break;

    default:
      *val = LSM6DS3_2g;
      break;
  }

  return ret;
}

/**
  * @brief   Accelerometer data rate selection.[set]
  *
  * @param  ctx      read / write interface definitions(ptr)
  * @param  val      change the values of odr_xl in reg  LSM6DS3
  * @retval          interface status (MANDATORY: return 0 -> no Error)
  *
  */
int32_t lsm6ds3_xl_data_rate_set(stmdev_ctx_t *ctx,
                                 lsm6ds3_odr_xl_t val)
{
  lsm6ds3_ctrl1_xl_t ctrl1_xl;
  int32_t ret;

  ret = lsm6ds3_read_reg(ctx, LSM6DS3_CTRL1_XL, (uint8_t *)&ctrl1_xl, 1);

  if (ret == 0)
  {
    ctrl1_xl.odr_xl = (uint8_t)val;
    ret = lsm6ds3_write_reg(ctx, LSM6DS3_CTRL1_XL, (uint8_t *)&ctrl1_xl, 1);
  }

  return ret;
}

/**
  * @brief   Accelerometer data rate selection.[get]
  *
  * @param  ctx         read / write interface definitions(ptr)
  * @param  val         get the values of odr_xl in reg CTRL1_XL
  * @retval             interface status (MANDATORY: return 0 -> no Error)
  *
  */
int32_t lsm6ds3_xl_data_rate_get(stmdev_ctx_t *ctx,
                                 lsm6ds3_odr_xl_t *val)
{
  lsm6ds3_ctrl1_xl_t ctrl1_xl;
  int32_t ret;

  ret = lsm6ds3_read_reg(ctx, LSM6DS3_CTRL1_XL, (uint8_t *)&ctrl1_xl, 1);

  switch (ctrl1_xl.odr_xl)
  {
    case LSM6DS3_XL_ODR_OFF:
      *val = LSM6DS3_XL_ODR_OFF;
      break;

    case LSM6DS3_XL_ODR_12Hz5:
      *val = LSM6DS3_XL_ODR_12Hz5;
      break;

    case LSM6DS3_XL_ODR_26Hz:
      *val = LSM6DS3_XL_ODR_26Hz;
      break;

    case LSM6DS3_XL_ODR_52Hz:
      *val = LSM6DS3_XL_ODR_52Hz;
      break;

    case LSM6DS3_XL_ODR_104Hz:
      *val = LSM6DS3_XL_ODR_104Hz;
      break;

    case LSM6DS3_XL_ODR_208Hz:
      *val = LSM6DS3_XL_ODR_208Hz;
      break;

    case LSM6DS3_XL_ODR_416Hz:
      *val = LSM6DS3_XL_ODR_416Hz;
      break;

    case LSM6DS3_XL_ODR_833Hz:
      *val = LSM6DS3_XL_ODR_833Hz;
      break;

    case LSM6DS3_XL_ODR_1k66Hz:
      *val = LSM6DS3_XL_ODR_1k66Hz;
      break;

    case LSM6DS3_XL_ODR_3k33Hz:
      *val = LSM6DS3_XL_ODR_3k33Hz;
      break;

    case LSM6DS3_XL_ODR_6k66Hz:
      *val = LSM6DS3_XL_ODR_6k66Hz;
      break;

    default:
      *val = LSM6DS3_XL_ODR_OFF;
      break;
  }

  return ret;
}

/**
  * @brief   Gyroscope UI chain full-scale selection.[set]
  *
  * @param  ctx      read / write interface definitions(ptr)
  * @param  val      change the values of fs_g in reg  LSM6DS3
  * @retval          interface status (MANDATORY: return 0 -> no Error)
  *
  */
int32_t lsm6ds3_gy_full_scale_set(stmdev_ctx_t *ctx,
                                  lsm6ds3_fs_g_t val)
{
  lsm6ds3_ctrl2_g_t ctrl2_g;
  int32_t ret;

  ret = lsm6ds3_read_reg(ctx, LSM6DS3_CTRL2_G, (uint8_t *)&ctrl2_g, 1);

  if (ret == 0)
  {
    ctrl2_g.fs_g = (uint8_t)val;
    ret = lsm6ds3_write_reg(ctx, LSM6DS3_CTRL2_G, (uint8_t *)&ctrl2_g, 1);
  }

  return ret;
}

/**
  * @brief   Gyroscope UI chain full-scale selection.[get]
  *
  * @param  ctx         read / write interface definitions(ptr)
  * @param  val         get the values of fs_g in reg CTRL2_G
  * @retval             interface status (MANDATORY: return 0 -> no Error)
  *
  */
int32_t lsm6ds3_gy_full_scale_get(stmdev_ctx_t *ctx,
                                  lsm6ds3_fs_g_t *val)
{
  lsm6ds3_ctrl2_g_t ctrl2_g;
  int32_t ret;

  ret = lsm6ds3_read_reg(ctx, LSM6DS3_CTRL2_G, (uint8_t *)&ctrl2_g, 1);

  switch (ctrl2_g.fs_g)
  {
    case LSM6DS3_250dps:
      *val = LSM6DS3_250dps;
      break;

    case LSM6DS3_125dps:
      *val = LSM6DS3_125dps;
      break;

    case LSM6DS3_500dps:
      *val = LSM6DS3_500dps;
      break;

    case LSM6DS3_1000dps:
      *val = LSM6DS3_1000dps;
      break;

    case LSM6DS3_2000dps:
      *val = LSM6DS3_2000dps;
      break;

    default:
      *val = LSM6DS3_250dps;
      break;
  }

  return ret;
}

/**
  * @brief   Gyroscope UI data rate selection.[set]
  *
  * @param  ctx      read / write interface definitions(ptr)
  * @param  val      change the values of odr_g in reg  LSM6DS3
  * @retval          interface status (MANDATORY: return 0 -> no Error)
  *
  */
int32_t lsm6ds3_gy_data_rate_set(stmdev_ctx_t *ctx,
                                 lsm6ds3_odr_g_t val)
{
  lsm6ds3_ctrl2_g_t ctrl2_g;
  int32_t ret;

  ret = lsm6ds3_read_reg(ctx, LSM6DS3_CTRL2_G, (uint8_t *)&ctrl2_g, 1);

  if (ret == 0)
  {
    ctrl2_g.odr_g = (uint8_t)val;
    ret = lsm6ds3_write_reg(ctx, LSM6DS3_CTRL2_G, (uint8_t *)&ctrl2_g, 1);
  }

  return ret;
}

/**
  * @brief   Gyroscope UI data rate selection.[get]
  *
  * @param  ctx         read / write interface definitions(ptr)
  * @param  val         get the values of odr_g in reg CTRL2_G
  * @retval             interface status (MANDATORY: return 0 -> no Error)
  *
  */
int32_t lsm6ds3_gy_data_rate_get(stmdev_ctx_t *ctx,
                                 lsm6ds3_odr_g_t *val)
{
  lsm6ds3_ctrl2_g_t ctrl2_g;
  int32_t ret;

  ret = lsm6ds3_read_reg(ctx, LSM6DS3_CTRL2_G, (uint8_t *)&ctrl2_g, 1);

  switch (ctrl2_g.odr_g)
  {
    case LSM6DS3_GY_ODR_OFF:
      *val = LSM6DS3_GY_ODR_OFF;
      break;

    case LSM6DS3_GY_ODR_12Hz5:
      *val = LSM6DS3_GY_ODR_12Hz5;
      break;

    case LSM6DS3_GY_ODR_26Hz:
      *val = LSM6DS3_GY_ODR_26Hz;
      break;

    case LSM6DS3_GY_ODR_52Hz:
      *val = LSM6DS3_GY_ODR_52Hz;
      break;

    case LSM6DS3_GY_ODR_104Hz:
      *val = LSM6DS3_GY_ODR_104Hz;
      break;

    case LSM6DS3_GY_ODR_208Hz:
      *val = LSM6DS3_GY_ODR_208Hz;
      break;

    case LSM6DS3_GY_ODR_416Hz:
      *val = LSM6DS3_GY_ODR_416Hz;
      break;

    case LSM6DS3_GY_ODR_833Hz:
      *val = LSM6DS3_GY_ODR_833Hz;
      break;

    case LSM6DS3_GY_ODR_1k66Hz:
      *val = LSM6DS3_GY_ODR_1k66Hz;
      break;

    default:
      *val = LSM6DS3_GY_ODR_OFF;
      break;
  }

  return ret;
}

/**
  * @brief  Blockdataupdate.[set]
  *
  * @param  ctx      read / write interface definitions(ptr)
  * @param  val      change the values of bdu in reg CTRL3_C
  * @retval          interface status (MANDATORY: return 0 -> no Error)
  *
  */
int32_t lsm6ds3_block_data_update_set(stmdev_ctx_t *ctx, uint8_t val)
{
  lsm6ds3_ctrl3_c_t ctrl3_c;
  int32_t ret;

  ret = lsm6ds3_read_reg(ctx, LSM6DS3_CTRL3_C, (uint8_t *)&ctrl3_c, 1);

  if (ret == 0)
  {
    ctrl3_c.bdu = (uint8_t)val;
    ret = lsm6ds3_write_reg(ctx, LSM6DS3_CTRL3_C, (uint8_t *)&ctrl3_c, 1);
  }

  return ret;
}

/**
  * @brief  Blockdataupdate.[get]
  *
  * @param  ctx      read / write interface definitions(ptr)
  * @param  val      get the values of bdu in reg CTRL3_C
  * @retval          interface status (MANDATORY: return 0 -> no Error)
  *
  */
int32_t lsm6ds3_block_data_update_get(stmdev_ctx_t *ctx, uint8_t *val)
{
  lsm6ds3_ctrl3_c_t ctrl3_c;
  int32_t ret;

  ret = lsm6ds3_read_reg(ctx, LSM6DS3_CTRL3_C, (uint8_t *)&ctrl3_c, 1);
  *val = (uint8_t)ctrl3_c.bdu;

  return ret;
}

/**
  * @brief   High-performance operating mode for accelerometer.[set]
  *
  * @param  ctx      read / write interface definitions(ptr)
  * @param  val      change the values of xl_hm_mode in reg  LSM6DS3
  * @retval          interface status (MANDATORY: return 0 -> no Error)
  *
  */
int32_t lsm6ds3_xl_power_mode_set(stmdev_ctx_t *ctx,
                                  lsm6ds3_xl_hm_mode_t val)
{
  lsm6ds3_ctrl6_c_t ctrl6_c;
  int32_t ret;

  ret = lsm6ds3_read_reg(ctx, LSM6DS3_CTRL6_C, (uint8_t *)&ctrl6_c, 1);

  if (ret == 0)
  {
    ctrl6_c.xl_hm_mode = (uint8_t)val;
    ret = lsm6ds3_write_reg(ctx, LSM6DS3_CTRL6_C, (uint8_t *)&ctrl6_c, 1);
  }

  return ret;
}

/**
  * @brief   High-performance operating mode for accelerometer.[get]
  *
  * @param  ctx         read / write interface definitions(ptr)
  * @param  val         get the values of xl_hm_mode in reg CTRL6_C
  * @retval             interface status (MANDATORY: return 0 -> no Error)
  *
  */
int32_t lsm6ds3_xl_power_mode_get(stmdev_ctx_t *ctx,
                                  lsm6ds3_xl_hm_mode_t *val)
{
  lsm6ds3_ctrl6_c_t ctrl6_c;
  int32_t ret;

  ret = lsm6ds3_read_reg(ctx, LSM6DS3_CTRL6_C, (uint8_t *)&ctrl6_c, 1);

  switch (ctrl6_c.xl_hm_mode)
  {
    case  LSM6DS3_XL_HIGH_PERFORMANCE:
      *val =  LSM6DS3_XL_HIGH_PERFORMANCE;
      break;

    case LSM6DS3_XL_NORMAL:
      *val = LSM6DS3_XL_NORMAL;
      break;

    default:
      *val =  LSM6DS3_XL_HIGH_PERFORMANCE;
      break;
  }

  return ret;
}

/**
  * @brief   Source register rounding function on ADD HERE ROUNDING REGISTERS.[set]
  *
  * @param  ctx      read / write interface definitions(ptr)
  * @param  val      change the values of rounding_status in reg  LSM6DS3
  * @retval          interface status (MANDATORY: return 0 -> no Error)
  *
  */
int32_t lsm6ds3_rounding_on_status_set(stmdev_ctx_t *ctx,
                                       lsm6ds3_rnd_stat_t val)
{
  lsm6ds3_ctrl7_g_t ctrl7_g;
  int32_t ret;

  ret = lsm6ds3_read_reg(ctx, LSM6DS3_CTRL7_G, (uint8_t *)&ctrl7_g, 1);

  if (ret == 0)
  {
    ctrl7_g.rounding_status = (uint8_t)val;
    ret = lsm6ds3_write_reg(ctx, LSM6DS3_CTRL7_G, (uint8_t *)&ctrl7_g, 1);
  }

  return ret;
}

/**
  * @brief   Source register rounding function on ADD HERE ROUNDING REGISTERS.[get]
  *
  * @param  ctx         read / write interface definitions(ptr)
  * @param  val         get the values of rounding_status in reg CTRL7_G
  * @retval             interface status (MANDATORY: return 0 -> no Error)
  *
  */
int32_t lsm6ds3_rounding_on_status_get(stmdev_ctx_t *ctx,
                                       lsm6ds3_rnd_stat_t *val)
{
  lsm6ds3_ctrl7_g_t ctrl7_g;
  int32_t ret;

  ret = lsm6ds3_read_reg(ctx, LSM6DS3_CTRL7_G, (uint8_t *)&ctrl7_g, 1);

  switch (ctrl7_g.rounding_status)
  {
    case LSM6DS3_STAT_RND_DISABLE:
      *val = LSM6DS3_STAT_RND_DISABLE;
      break;

    case LSM6DS3_STAT_RND_ENABLE:
      *val = LSM6DS3_STAT_RND_ENABLE;
      break;

    default:
      *val = LSM6DS3_STAT_RND_DISABLE;
      break;
  }

  return ret;
}

/**
  * @brief   High-performance operating mode disable for gyroscope.[set]
  *
  * @param  ctx      read / write interface definitions(ptr)
  * @param  val      change the values of g_hm_mode in reg  LSM6DS3
  * @retval          interface status (MANDATORY: return 0 -> no Error)
  *
  */
int32_t lsm6ds3_gy_power_mode_set(stmdev_ctx_t *ctx,
                                  lsm6ds3_g_hm_mode_t val)
{
  lsm6ds3_ctrl7_g_t ctrl7_g;
  int32_t ret;

  ret = lsm6ds3_read_reg(ctx, LSM6DS3_CTRL7_G, (uint8_t *)&ctrl7_g, 1);

  if (ret == 0)
  {
    ctrl7_g.g_hm_mode = (uint8_t)val;
    ret = lsm6ds3_write_reg(ctx, LSM6DS3_CTRL7_G, (uint8_t *)&ctrl7_g, 1);
  }

  return ret;
}

/**
  * @brief   High-performance operating mode disable for gyroscope.[get]
  *
  * @param  ctx         read / write interface definitions(ptr)
  * @param  val         get the values of g_hm_mode in reg CTRL7_G
  * @retval             interface status (MANDATORY: return 0 -> no Error)
  *
  */
int32_t lsm6ds3_gy_power_mode_get(stmdev_ctx_t *ctx,
                                  lsm6ds3_g_hm_mode_t *val)
{
  lsm6ds3_ctrl7_g_t ctrl7_g;
  int32_t ret;

  ret = lsm6ds3_read_reg(ctx, LSM6DS3_CTRL7_G, (uint8_t *)&ctrl7_g, 1);

  switch (ctrl7_g.g_hm_mode)
  {
    case  LSM6DS3_GY_HIGH_PERFORMANCE:
      *val =  LSM6DS3_GY_HIGH_PERFORMANCE;
      break;

    case LSM6DS3_GY_NORMAL:
      *val = LSM6DS3_GY_NORMAL;
      break;

    default:
      *val =  LSM6DS3_GY_HIGH_PERFORMANCE;
      break;
  }

  return ret;
}

/**
  * @brief   Accelerometer X-axis output enable/disable.[set]
  *
  * @param  ctx      read / write interface definitions(ptr)
  * @param  val      change the values of xen_xl in reg CTRL9_XL
  * @retval          interface status (MANDATORY: return 0 -> no Error)
  *
  */
int32_t lsm6ds3_xl_axis_x_data_set(stmdev_ctx_t *ctx, uint8_t val)
{
  lsm6ds3_ctrl9_xl_t ctrl9_xl;
  int32_t ret;

  ret = lsm6ds3_read_reg(ctx, LSM6DS3_CTRL9_XL, (uint8_t *)&ctrl9_xl, 1);

  if (ret == 0)
  {
    ctrl9_xl.xen_xl = (uint8_t)val;
    ret = lsm6ds3_write_reg(ctx, LSM6DS3_CTRL9_XL, (uint8_t *)&ctrl9_xl, 1);
  }

  return ret;
}

/**
  * @brief   Accelerometer X-axis output enable/disable.[get]
  *
  * @param  ctx      read / write interface definitions(ptr)
  * @param  val      get the values of xen_xl in reg CTRL9_XL
  * @retval          interface status (MANDATORY: return 0 -> no Error)
  *
  */
int32_t lsm6ds3_xl_axis_x_data_get(stmdev_ctx_t *ctx, uint8_t *val)
{
  lsm6ds3_ctrl9_xl_t ctrl9_xl;
  int32_t ret;

  ret = lsm6ds3_read_reg(ctx, LSM6DS3_CTRL9_XL, (uint8_t *)&ctrl9_xl, 1);
  *val = (uint8_t)ctrl9_xl.xen_xl;

  return ret;
}

/**
  * @brief   Accelerometer Y-axis output enable/disable.[set]
  *
  * @param  ctx      read / write interface definitions(ptr)
  * @param  val      change the values of yen_xl in reg CTRL9_XL
  * @retval          interface status (MANDATORY: return 0 -> no Error)
  *
  */
int32_t lsm6ds3_xl_axis_y_data_set(stmdev_ctx_t *ctx, uint8_t val)
{
  lsm6ds3_ctrl9_xl_t ctrl9_xl;
  int32_t ret;

  ret = lsm6ds3_read_reg(ctx, LSM6DS3_CTRL9_XL, (uint8_t *)&ctrl9_xl, 1);

  if (ret == 0)
  {
    ctrl9_xl.yen_xl = (uint8_t)val;
    ret = lsm6ds3_write_reg(ctx, LSM6DS3_CTRL9_XL, (uint8_t *)&ctrl9_xl, 1);
  }

  return ret;
}

/**
  * @brief   Accelerometer Y-axis output enable/disable.[get]
  *
  * @param  ctx      read / write interface definitions(ptr)
  * @param  val      get the values of yen_xl in reg CTRL9_XL
  * @retval          interface status (MANDATORY: return 0 -> no Error)
  *
  */
int32_t lsm6ds3_xl_axis_y_data_get(stmdev_ctx_t *ctx, uint8_t *val)
{
  lsm6ds3_ctrl9_xl_t ctrl9_xl;
  int32_t ret;

  ret = lsm6ds3_read_reg(ctx, LSM6DS3_CTRL9_XL, (uint8_t *)&ctrl9_xl, 1);
  *val = (uint8_t)ctrl9_xl.yen_xl;

  return ret;
}

/**
  * @brief   Accelerometer Z-axis output enable/disable.[set]
  *
  * @param  ctx      read / write interface definitions(ptr)
  * @param  val      change the values of zen_xl in reg CTRL9_XL
  * @retval          interface status (MANDATORY: return 0 -> no Error)
  *
  */
int32_t lsm6ds3_xl_axis_z_data_set(stmdev_ctx_t *ctx, uint8_t val)
{
  lsm6ds3_ctrl9_xl_t ctrl9_xl;
  int32_t ret;

  ret = lsm6ds3_read_reg(ctx, LSM6DS3_CTRL9_XL, (uint8_t *)&ctrl9_xl, 1);

  if (ret == 0)
  {
    ctrl9_xl.zen_xl = (uint8_t)val;
    ret = lsm6ds3_write_reg(ctx, LSM6DS3_CTRL9_XL, (uint8_t *)&ctrl9_xl, 1);
  }

  return ret;
}

/**
  * @brief   Accelerometer Z-axis output enable/disable.[get]
  *
  * @param  ctx      read / write interface definitions(ptr)
  * @param  val      get the values of zen_xl in reg CTRL9_XL
  * @retval          interface status (MANDATORY: return 0 -> no Error)
  *
  */
int32_t lsm6ds3_xl_axis_z_data_get(stmdev_ctx_t *ctx, uint8_t *val)
{
  lsm6ds3_ctrl9_xl_t ctrl9_xl;
  int32_t ret;

  ret = lsm6ds3_read_reg(ctx, LSM6DS3_CTRL9_XL, (uint8_t *)&ctrl9_xl, 1);
  *val = (uint8_t)ctrl9_xl.zen_xl;

  return ret;
}

/**
  * @brief   Gyroscope pitch axis (X) output enable/disable.[set]
  *
  * @param  ctx      read / write interface definitions(ptr)
  * @param  val      change the values of xen_g in reg CTRL10_C
  * @retval          interface status (MANDATORY: return 0 -> no Error)
  *
  */
int32_t lsm6ds3_gy_axis_x_data_set(stmdev_ctx_t *ctx, uint8_t val)
{
  lsm6ds3_ctrl10_c_t ctrl10_c;
  int32_t ret;

  ret = lsm6ds3_read_reg(ctx, LSM6DS3_CTRL10_C, (uint8_t *)&ctrl10_c, 1);

  if (ret == 0)
  {
    ctrl10_c.xen_g = (uint8_t)val;
    ret = lsm6ds3_write_reg(ctx, LSM6DS3_CTRL10_C, (uint8_t *)&ctrl10_c, 1);
  }

  return ret;
}

/**
  * @brief   Gyroscope pitch axis (X) output enable/disable.[get]
  *
  * @param  ctx      read / write interface definitions(ptr)
  * @param  val      get the values of xen_g in reg CTRL10_C
  * @retval          interface status (MANDATORY: return 0 -> no Error)
  *
  */
int32_t lsm6ds3_gy_axis_x_data_get(stmdev_ctx_t *ctx, uint8_t *val)
{
  lsm6ds3_ctrl10_c_t ctrl10_c;
  int32_t ret;

  ret = lsm6ds3_read_reg(ctx, LSM6DS3_CTRL10_C, (uint8_t *)&ctrl10_c, 1);
  *val = (uint8_t)ctrl10_c.xen_g;

  return ret;
}

/**
  * @brief   Gyroscope pitch axis (Y) output enable/disable.[set]
  *
  * @param  ctx      read / write interface definitions(ptr)
  * @param  val      change the values of yen_g in reg CTRL10_C
  * @retval          interface status (MANDATORY: return 0 -> no Error)
  *
  */
int32_t lsm6ds3_gy_axis_y_data_set(stmdev_ctx_t *ctx, uint8_t val)
{
  lsm6ds3_ctrl10_c_t ctrl10_c;
  int32_t ret;

  ret = lsm6ds3_read_reg(ctx, LSM6DS3_CTRL10_C, (uint8_t *)&ctrl10_c, 1);

  if (ret == 0)
  {
    ctrl10_c.yen_g = (uint8_t)val;
    ret = lsm6ds3_write_reg(ctx, LSM6DS3_CTRL10_C, (uint8_t *)&ctrl10_c, 1);
  }

  return ret;
}

/**
  * @brief   Gyroscope pitch axis (Y) output enable/disable.[get]
  *
  * @param  ctx      read / write interface definitions(ptr)
  * @param  val      get the values of yen_g in reg CTRL10_C
  * @retval          interface status (MANDATORY: return 0 -> no Error)
  *
  */
int32_t lsm6ds3_gy_axis_y_data_get(stmdev_ctx_t *ctx, uint8_t *val)
{
  lsm6ds3_ctrl10_c_t ctrl10_c;
  int32_t ret;

  ret = lsm6ds3_read_reg(ctx, LSM6DS3_CTRL10_C, (uint8_t *)&ctrl10_c, 1);
  *val = (uint8_t)ctrl10_c.yen_g;

  return ret;
}

/**
  * @brief   Gyroscope pitch axis (Z) output enable/disable.[set]
  *
  * @param  ctx      read / write interface definitions(ptr)
  * @param  val      change the values of zen_g in reg CTRL10_C
  * @retval          interface status (MANDATORY: return 0 -> no Error)
  *
  */
int32_t lsm6ds3_gy_axis_z_data_set(stmdev_ctx_t *ctx, uint8_t val)
{
  lsm6ds3_ctrl10_c_t ctrl10_c;
  int32_t ret;

  ret = lsm6ds3_read_reg(ctx, LSM6DS3_CTRL10_C, (uint8_t *)&ctrl10_c, 1);

  if (ret == 0)
  {
    ctrl10_c.zen_g = (uint8_t)val;
    ret = lsm6ds3_write_reg(ctx, LSM6DS3_CTRL10_C, (uint8_t *)&ctrl10_c, 1);
  }

  return ret;
}

/**
  * @brief   Gyroscope pitch axis (Z) output enable/disable.[get]
  *
  * @param  ctx      read / write interface definitions(ptr)
  * @param  val      get the values of zen_g in reg CTRL10_C
  * @retval          interface status (MANDATORY: return 0 -> no Error)
  *
  */
int32_t lsm6ds3_gy_axis_z_data_get(stmdev_ctx_t *ctx, uint8_t *val)
{
  lsm6ds3_ctrl10_c_t ctrl10_c;
  int32_t ret;

  ret = lsm6ds3_read_reg(ctx, LSM6DS3_CTRL10_C, (uint8_t *)&ctrl10_c, 1);
  *val = (uint8_t)ctrl10_c.zen_g;

  return ret;
}

/**
  * @brief   Read all the interrupt/status flag of the device. ELENCA I REGISTRI[get]
  *
  * @param  ctx         read / write interface definitions(ptr)
  * @param  val         Read all the interrupt flag of the device:
  *                     WAKE_UP_SRC, TAP_SRC, D6D_SRC, FUNC_SRC.
  * @retval             interface status (MANDATORY: return 0 -> no Error)
  *
  */
int32_t lsm6ds3_all_sources_get(stmdev_ctx_t *ctx,
                                lsm6ds3_all_src_t *val)
{
  int32_t ret;

  ret = lsm6ds3_read_reg(ctx, LSM6DS3_WAKE_UP_SRC,
                         (uint8_t *) & (val->wake_up_src), 1);

  if (ret == 0)
  {
    ret = lsm6ds3_read_reg(ctx, LSM6DS3_TAP_SRC,
                           (uint8_t *) & (val->tap_src), 1);
  }

  if (ret == 0)
  {
    ret = lsm6ds3_read_reg(ctx, LSM6DS3_D6D_SRC,
                           (uint8_t *) & (val->d6d_src), 1);
  }

  if (ret == 0)
  {
    ret = lsm6ds3_read_reg(ctx, LSM6DS3_FUNC_SRC,
                           (uint8_t *) & (val->func_src), 1);
  }

  return ret;
}

/**
  * @brief   The STATUS_REG register of the device.[get]
  *
  * @param  ctx         read / write interface definitions(ptr)
  * @param  val          The STATUS_REG register of the device.
  * @retval             interface status (MANDATORY: return 0 -> no Error)
  *
  */
int32_t lsm6ds3_status_reg_get(stmdev_ctx_t *ctx,
                               lsm6ds3_status_reg_t *val)
{
  int32_t ret;

  ret = lsm6ds3_read_reg(ctx, LSM6DS3_STATUS_REG, (uint8_t *)&val, 1);

  return ret;
}

/**
  * @brief   Accelerometer new data available.[get]
  *
  * @param  ctx      read / write interface definitions(ptr)
  * @param  val      get the values of xlda in reg STATUS_REG
  * @retval          interface status (MANDATORY: return 0 -> no Error)
  *
  */
int32_t lsm6ds3_xl_flag_data_ready_get(stmdev_ctx_t *ctx,
                                       uint8_t *val)
{
  lsm6ds3_status_reg_t status_reg;
  int32_t ret;

  ret = lsm6ds3_read_reg(ctx, LSM6DS3_STATUS_REG,
                         (uint8_t *)&status_reg, 1);
  *val = (uint8_t)status_reg.xlda;

  return ret;
}

/**
  * @brief   Gyroscope new data available.[get]
  *
  * @param  ctx      read / write interface definitions(ptr)
  * @param  val      get the values of gda in reg STATUS_REG
  * @retval          interface status (MANDATORY: return 0 -> no Error)
  *
  */
int32_t lsm6ds3_gy_flag_data_ready_get(stmdev_ctx_t *ctx,
                                       uint8_t *val)
{
  lsm6ds3_status_reg_t status_reg;
  int32_t ret;

  ret = lsm6ds3_read_reg(ctx, LSM6DS3_STATUS_REG,
                         (uint8_t *)&status_reg, 1);
  *val = (uint8_t)status_reg.gda;

  return ret;
}

/**
  * @brief   Temperature new data available.[get]
  *
  * @param  ctx      read / write interface definitions(ptr)
  * @param  val      get the values of tda in reg STATUS_REG
  * @retval          interface status (MANDATORY: return 0 -> no Error)
  *
  */
int32_t lsm6ds3_temp_flag_data_ready_get(stmdev_ctx_t *ctx,
                                         uint8_t *val)
{
  lsm6ds3_status_reg_t status_reg;
  int32_t ret;

  ret = lsm6ds3_read_reg(ctx, LSM6DS3_STATUS_REG,
                         (uint8_t *)&status_reg, 1);
  *val = (uint8_t)status_reg.tda;

  return ret;
}

/**
  * @}
  *
  */

/**
  * @defgroup    LSM6DS3_Timestamp
  * @brief       This section groups all the functions that manage the
  *              timestamp generation.
  * @{
  *
  */

/**
  * @brief   Timestamp first byte data output register (r). The value is
  *          expressed as a 24-bit word and the bit resolution is defined
  *          by setting the value in WAKE_UP_DUR (5Ch).[get]
  *
  * @param  ctx         read / write interface definitions(ptr)
  * @param  buff        buffer that stores data read
  * @retval             interface status (MANDATORY: return 0 -> no Error)
  *
  */
int32_t lsm6ds3_timestamp_raw_get(stmdev_ctx_t *ctx, uint32_t *val)
{
  uint8_t buff[3];
  int32_t ret;

  ret = lsm6ds3_read_reg(ctx, LSM6DS3_TIMESTAMP0_REG, buff, 3);
  *val = buff[2];
  *val = (*val * 256U) +  buff[1];
  *val = (*val * 256U) +  buff[0];

  return ret;
}

/**
  * @brief  Reset the timer.[set]
  *
  * @param  ctx         read / write interface definitions(ptr)
  * @param  buff        buffer that stores data to be write
  * @retval             interface status (MANDATORY: return 0 -> no Error)
  *
  */
int32_t lsm6ds3_timestamp_rst_set(stmdev_ctx_t *ctx)
{
  int32_t ret;

  uint8_t rst_val = 0xAA;
  ret = lsm6ds3_write_reg(ctx, LSM6DS3_TIMESTAMP2_REG, &rst_val, 1);

  return ret;
}

/**
  * @brief   Timestamp count enable, output data are collected in
  *          TIMESTAMP0_REG (40h), TIMESTAMP1_REG (41h),
  *          TIMESTAMP2_REG (42h) register.[set]
  *
  * @param  ctx      read / write interface definitions(ptr)
  * @param  val      change the values of timer_en in reg TAP_CFG
  * @retval          interface status (MANDATORY: return 0 -> no Error)
  *
  */
int32_t lsm6ds3_timestamp_set(stmdev_ctx_t *ctx, uint8_t val)
{
  lsm6ds3_tap_cfg_t tap_cfg;
  int32_t ret;

  ret = lsm6ds3_read_reg(ctx, LSM6DS3_TAP_CFG, (uint8_t *)&tap_cfg, 1);

  if (ret == 0)
  {
    tap_cfg.timer_en = (uint8_t)val;
    ret = lsm6ds3_write_reg(ctx, LSM6DS3_TAP_CFG, (uint8_t *)&tap_cfg, 1);
  }

  return ret;
}

/**
  * @brief   Timestamp count enable, output data are collected in
  *          TIMESTAMP0_REG (40h), TIMESTAMP1_REG (41h),
  *          TIMESTAMP2_REG (42h) register.[get]
  *
  * @param  ctx      read / write interface definitions(ptr)
  * @param  val      get the values of timer_en in reg TAP_CFG
  * @retval          interface status (MANDATORY: return 0 -> no Error)
  *
  */
int32_t lsm6ds3_timestamp_get(stmdev_ctx_t *ctx, uint8_t *val)
{
  lsm6ds3_tap_cfg_t tap_cfg;
  int32_t ret;

  ret = lsm6ds3_read_reg(ctx, LSM6DS3_TAP_CFG, (uint8_t *)&tap_cfg, 1);
  *val = (uint8_t)tap_cfg.timer_en;

  return ret;
}

/**
  * @brief   Timestamp register resolution setting.[set]
  *
  * @param  ctx      read / write interface definitions(ptr)
  * @param  val      change the values of timer_hr in reg  LSM6DS3
  * @retval          interface status (MANDATORY: return 0 -> no Error)
  *
  */
int32_t lsm6ds3_timestamp_res_set(stmdev_ctx_t *ctx,
                                  lsm6ds3_ts_res_t val)
{
  lsm6ds3_wake_up_dur_t wake_up_dur;
  int32_t ret;

  ret = lsm6ds3_read_reg(ctx, LSM6DS3_WAKE_UP_DUR,
                         (uint8_t *)&wake_up_dur, 1);

  if (ret == 0)
  {
    wake_up_dur.timer_hr = (uint8_t)val;
    ret = lsm6ds3_write_reg(ctx, LSM6DS3_WAKE_UP_DUR,
                            (uint8_t *)&wake_up_dur, 1);
  }

  return ret;
}

/**
  * @brief   Timestamp register resolution setting.[get]
  *
  * @param  ctx         read / write interface definitions(ptr)
  * @param  val         get the values of timer_hr in reg WAKE_UP_DUR
  * @retval             interface status (MANDATORY: return 0 -> no Error)
  *
  */
int32_t lsm6ds3_timestamp_res_get(stmdev_ctx_t *ctx,
                                  lsm6ds3_ts_res_t *val)
{
  lsm6ds3_wake_up_dur_t wake_up_dur;
  int32_t ret;

  ret = lsm6ds3_read_reg(ctx, LSM6DS3_WAKE_UP_DUR,
                         (uint8_t *)&wake_up_dur, 1);

  switch (wake_up_dur.timer_hr)
  {
    case LSM6DS3_LSB_6ms4:
      *val = LSM6DS3_LSB_6ms4;
      break;

    case LSM6DS3_LSB_25us:
      *val = LSM6DS3_LSB_25us;
      break;

    default:
      *val = LSM6DS3_LSB_6ms4;
      break;
  }

  return ret;
}

/**
  * @}
  *
  */

/**
  * @defgroup    LSM6DS3_Dataoutput
  * @brief       This section groups all the data output functions.
  * @{
  *
  */

/**
  * @brief   Circular burst-mode (rounding) read from output registers
  *          through the primary interface.[set]
  *
  * @param  ctx      read / write interface definitions(ptr)
  * @param  val      change the values of rounding in reg  LSM6DS3
  * @retval          interface status (MANDATORY: return 0 -> no Error)
  *
  */
int32_t lsm6ds3_rounding_mode_set(stmdev_ctx_t *ctx,
                                  lsm6ds3_rounding_t val)
{
  lsm6ds3_ctrl5_c_t ctrl5_c;
  int32_t ret;

  ret = lsm6ds3_read_reg(ctx, LSM6DS3_CTRL5_C, (uint8_t *)&ctrl5_c, 1);

  if (ret == 0)
  {
    ctrl5_c.rounding = (uint8_t)val;
    ret = lsm6ds3_write_reg(ctx, LSM6DS3_CTRL5_C, (uint8_t *)&ctrl5_c, 1);
  }

  return ret;
}

/**
  * @brief   Circular burst-mode (rounding) read from output registers
  *          through the primary interface.[get]
  *
  * @param  ctx         read / write interface definitions(ptr)
  * @param  val         get the values of rounding in reg CTRL5_C
  * @retval             interface status (MANDATORY: return 0 -> no Error)
  *
  */
int32_t lsm6ds3_rounding_mode_get(stmdev_ctx_t *ctx,
                                  lsm6ds3_rounding_t *val)
{
  lsm6ds3_ctrl5_c_t ctrl5_c;
  int32_t ret;

  ret = lsm6ds3_read_reg(ctx, LSM6DS3_CTRL5_C, (uint8_t *)&ctrl5_c, 1);

  switch (ctrl5_c.rounding)
  {
    case LSM6DS3_ROUND_DISABLE:
      *val = LSM6DS3_ROUND_DISABLE;
      break;

    case LSM6DS3_ROUND_XL:
      *val = LSM6DS3_ROUND_XL;
      break;

    case LSM6DS3_ROUND_GY:
      *val = LSM6DS3_ROUND_GY;
      break;

    case LSM6DS3_ROUND_GY_XL:
      *val = LSM6DS3_ROUND_GY_XL;
      break;

    case LSM6DS3_ROUND_SH1_TO_SH6:
      *val = LSM6DS3_ROUND_SH1_TO_SH6;
      break;

    case  LSM6DS3_ROUND_XL_SH1_TO_SH6:
      *val =  LSM6DS3_ROUND_XL_SH1_TO_SH6;
      break;

    case  LSM6DS3_ROUND_GY_XL_SH1_TO_SH12:
      *val =  LSM6DS3_ROUND_GY_XL_SH1_TO_SH12;
      break;

    case  LSM6DS3_ROUND_GY_XL_SH1_TO_SH6:
      *val =  LSM6DS3_ROUND_GY_XL_SH1_TO_SH6;
      break;

    default:
      *val = LSM6DS3_ROUND_DISABLE;
      break;
  }

  return ret;
}

/**
  * @brief   Temperature data output register (r). L and H registers together
  *          express a 16-bit word in two’s complement.[get]
  *
  * @param  ctx         read / write interface definitions(ptr)
  * @param  buff        buffer that stores data read
  * @retval             interface status (MANDATORY: return 0 -> no Error)
  *
  */
int32_t lsm6ds3_temperature_raw_get(stmdev_ctx_t *ctx, int16_t *val)
{
  uint8_t buff[2];
  int32_t ret;

  ret = lsm6ds3_read_reg(ctx, LSM6DS3_OUT_TEMP_L, buff, 2);
  *val = (int16_t)buff[1];
  *val = (*val * 256) + (int16_t)buff[0];

  return ret;
}

/**
  * @brief   Angular rate sensor. The value is expressed as a 16-bit word
  *          in two’s complement..[get]
  *
  * @param  ctx         read / write interface definitions(ptr)
  * @param  buff        buffer that stores data read
  * @retval             interface status (MANDATORY: return 0 -> no Error)
  *
  */
int32_t lsm6ds3_angular_rate_raw_get(stmdev_ctx_t *ctx, int16_t *val)
{
  uint8_t buff[6];
  int32_t ret;

  ret = lsm6ds3_read_reg(ctx, LSM6DS3_OUTX_L_G, buff, 6);
  val[0] = (int16_t)buff[1];
  val[0] = (val[0] * 256) + (int16_t)buff[0];
  val[1] = (int16_t)buff[3];
  val[1] = (val[1] * 256) + (int16_t)buff[2];
  val[2] = (int16_t)buff[5];
  val[2] = (val[2] * 256) + (int16_t)buff[4];

  return ret;
}

/**
  * @brief   Linear acceleration output register. The value is expressed
  *          as a 16-bit word in two’s complement.[get]
  *
  * @param  ctx         read / write interface definitions(ptr)
  * @param  buff        buffer that stores data read
  * @retval             interface status (MANDATORY: return 0 -> no Error)
  *
  */
int32_t lsm6ds3_acceleration_raw_get(stmdev_ctx_t *ctx, int16_t *val)
{
  uint8_t buff[6];
  int32_t ret;

  ret = lsm6ds3_read_reg(ctx, LSM6DS3_OUTX_L_XL, buff, 6);
  val[0] = (int16_t)buff[1];
  val[0] = (val[0] * 256) + (int16_t)buff[0];
  val[1] = (int16_t)buff[3];
  val[1] = (val[1] * 256) + (int16_t)buff[2];
  val[2] = (int16_t)buff[5];
  val[2] = (val[2] * 256) + (int16_t)buff[4];

  return ret;
}

/**
  * @brief   fifo_raw_data: [get]  read data in FIFO.
  *
  * @param  stmdev_ctx_t *ctx: read / write interface definitions
  * @param  uint8_t *: data buffer to store FIFO data.
  * @param  uint8_t : number of data to read from FIFO.
  * @retval             interface status (MANDATORY: return 0 -> no Error)
  *
  */
int32_t lsm6ds3_fifo_raw_data_get(stmdev_ctx_t *ctx, uint8_t *buffer,
                                  uint8_t len)
{
  int32_t ret;

  ret = lsm6ds3_read_reg(ctx, LSM6DS3_FIFO_DATA_OUT_L, buffer, len);

  return ret;
}

/**
  * @brief   Step counter output register..[get]
  *
  * @param  ctx         read / write interface definitions(ptr)
  * @param  buff        buffer that stores data read
  * @retval             interface status (MANDATORY: return 0 -> no Error)
  *
  */
int32_t lsm6ds3_number_of_steps_get(stmdev_ctx_t *ctx, uint16_t *val)
{
  uint8_t buff[2];
  int32_t ret;

  ret = lsm6ds3_read_reg(ctx, LSM6DS3_STEP_COUNTER_L, buff, 2);
  *val = buff[1];
  *val = (*val * 256U) +  buff[0];

  return ret;
}

/**
  * @brief   magnetometer raw data.[get]
  *
  * @param  ctx         read / write interface definitions(ptr)
  * @param  buff        buffer that stores data read
  * @retval             interface status (MANDATORY: return 0 -> no Error)
  *
  */
int32_t lsm6ds3_mag_calibrated_raw_get(stmdev_ctx_t *ctx,
                                       int16_t *val)
{
  uint8_t buff[6];
  int32_t ret;

  ret = lsm6ds3_read_reg(ctx, LSM6DS3_OUT_MAG_RAW_X_L, buff, 6);
  val[0] = (int16_t)buff[1];
  val[0] = (val[0] * 256) + (int16_t)buff[0];
  val[1] = (int16_t)buff[3];
  val[1] = (val[1] * 256) + (int16_t)buff[2];
  val[2] = (int16_t)buff[5];
  val[2] = (val[2] * 256) + (int16_t)buff[4];

  return ret;
}

/**
  * @}
  *
  */

/**
  * @defgroup    LSM6DS3_Common
  * @brief       This section groups common useful functions.
  * @{
  *
  */

/**
  * @brief   Enable access to the embedded functions.[set]
  *
  * @param  ctx      read / write interface definitions(ptr)
  * @param  val      change the values of func_cfg_en in reg  LSM6DS3
  * @retval          interface status (MANDATORY: return 0 -> no Error)
  *
  */
int32_t lsm6ds3_mem_bank_set(stmdev_ctx_t *ctx,
                             lsm6ds3_func_cfg_en_t val)
{
  lsm6ds3_func_cfg_access_t func_cfg_access;
  int32_t ret;

  ret = lsm6ds3_read_reg(ctx, LSM6DS3_FUNC_CFG_ACCESS,
                         (uint8_t *)&func_cfg_access, 1);

  if (ret == 0)
  {
    func_cfg_access.func_cfg_en = (uint8_t)val;
    ret = lsm6ds3_write_reg(ctx, LSM6DS3_FUNC_CFG_ACCESS,
                            (uint8_t *)&func_cfg_access, 1);
  }

  return ret;
}

/**
  * @brief   Enable access to the embedded functions.[get]
  *
  * @param  ctx         read / write interface definitions(ptr)
  * @param  val         get the values of func_cfg_en in reg FUNC_CFG_ACCESS
  * @retval             interface status (MANDATORY: return 0 -> no Error)
  *
  */
int32_t lsm6ds3_mem_bank_get(stmdev_ctx_t *ctx,
                             lsm6ds3_func_cfg_en_t *val)
{
  lsm6ds3_func_cfg_access_t func_cfg_access;
  int32_t ret;

  ret = lsm6ds3_read_reg(ctx, LSM6DS3_FUNC_CFG_ACCESS,
                         (uint8_t *)&func_cfg_access, 1);

  switch (func_cfg_access.func_cfg_en)
  {
    case LSM6DS3_USER_BANK:
      *val = LSM6DS3_USER_BANK;
      break;

    case LSM6DS3_EMBEDDED_FUNC_BANK:
      *val = LSM6DS3_EMBEDDED_FUNC_BANK;
      break;

    default:
      *val = LSM6DS3_USER_BANK;
      break;
  }

  return ret;
}

/**
  * @brief  DeviceWhoamI..[get]
  *
  * @param  ctx         read / write interface definitions(ptr)
  * @param  buff        buffer that stores data read
  * @retval             interface status (MANDATORY: return 0 -> no Error)
  *
  */
int32_t lsm6ds3_device_id_get(stmdev_ctx_t *ctx, uint8_t *buff)
{
  int32_t ret;

  ret = lsm6ds3_read_reg(ctx, LSM6DS3_WHO_AM_I, buff, 1);

  return ret;
}

/**
  * @brief   Software reset. Restore the default values in user registers.[set]
  *
  * @param  ctx      read / write interface definitions(ptr)
  * @param  val      change the values of sw_reset in reg CTRL3_C
  * @retval          interface status (MANDATORY: return 0 -> no Error)
  *
  */
int32_t lsm6ds3_reset_set(stmdev_ctx_t *ctx, uint8_t val)
{
  lsm6ds3_ctrl3_c_t ctrl3_c;
  int32_t ret;

  ret = lsm6ds3_read_reg(ctx, LSM6DS3_CTRL3_C, (uint8_t *)&ctrl3_c, 1);

  if (ret == 0)
  {
    ctrl3_c.sw_reset = (uint8_t)val;
    ret = lsm6ds3_write_reg(ctx, LSM6DS3_CTRL3_C, (uint8_t *)&ctrl3_c, 1);
  }

  return ret;
}

/**
  * @brief   Software reset. Restore the default values in user registers.[get]
  *
  * @param  ctx      read / write interface definitions(ptr)
  * @param  val      get the values of sw_reset in reg CTRL3_C
  * @retval          interface status (MANDATORY: return 0 -> no Error)
  *
  */
int32_t lsm6ds3_reset_get(stmdev_ctx_t *ctx, uint8_t *val)
{
  lsm6ds3_ctrl3_c_t ctrl3_c;
  int32_t ret;

  ret = lsm6ds3_read_reg(ctx, LSM6DS3_CTRL3_C, (uint8_t *)&ctrl3_c, 1);
  *val = (uint8_t)ctrl3_c.sw_reset;

  return ret;
}

/**
  * @brief   Big/Little Endian Data selection.[set]
  *
  * @param  ctx      read / write interface definitions(ptr)
  * @param  val      change the values of ble in reg  LSM6DS3
  * @retval          interface status (MANDATORY: return 0 -> no Error)
  *
  */
int32_t lsm6ds3_data_format_set(stmdev_ctx_t *ctx, lsm6ds3_ble_t val)
{
  lsm6ds3_ctrl3_c_t ctrl3_c;
  int32_t ret;

  ret = lsm6ds3_read_reg(ctx, LSM6DS3_CTRL3_C, (uint8_t *)&ctrl3_c, 1);

  if (ret == 0)
  {
    ctrl3_c.ble = (uint8_t)val;
    ret = lsm6ds3_write_reg(ctx, LSM6DS3_CTRL3_C, (uint8_t *)&ctrl3_c, 1);
  }

  return ret;
}

/**
  * @brief   Big/Little Endian Data selection.[get]
  *
  * @param  ctx         read / write interface definitions(ptr)
  * @param  val         get the values of ble in reg CTRL3_C
  * @retval             interface status (MANDATORY: return 0 -> no Error)
  *
  */
int32_t lsm6ds3_data_format_get(stmdev_ctx_t *ctx, lsm6ds3_ble_t *val)
{
  lsm6ds3_ctrl3_c_t ctrl3_c;
  int32_t ret;

  ret = lsm6ds3_read_reg(ctx, LSM6DS3_CTRL3_C, (uint8_t *)&ctrl3_c, 1);

  switch (ctrl3_c.ble)
  {
    case LSM6DS3_LSB_AT_LOW_ADD:
      *val = LSM6DS3_LSB_AT_LOW_ADD;
      break;

    case LSM6DS3_MSB_AT_LOW_ADD:
      *val = LSM6DS3_MSB_AT_LOW_ADD;
      break;

    default:
      *val = LSM6DS3_LSB_AT_LOW_ADD;
      break;
  }

  return ret;
}

/**
  * @brief   Register address automatically incremented during a multiple
  *          byte access with a serial interface.[set]
  *
  * @param  ctx      read / write interface definitions(ptr)
  * @param  val      change the values of if_inc in reg CTRL3_C
  * @retval          interface status (MANDATORY: return 0 -> no Error)
  *
  */
int32_t lsm6ds3_auto_increment_set(stmdev_ctx_t *ctx, uint8_t val)
{
  lsm6ds3_ctrl3_c_t ctrl3_c;
  int32_t ret;

  ret = lsm6ds3_read_reg(ctx, LSM6DS3_CTRL3_C, (uint8_t *)&ctrl3_c, 1);

  if (ret == 0)
  {
    ctrl3_c.if_inc = (uint8_t)val;
    ret = lsm6ds3_write_reg(ctx, LSM6DS3_CTRL3_C, (uint8_t *)&ctrl3_c, 1);
  }

  return ret;
}

/**
  * @brief   Register address automatically incremented during a multiple
  *          byte access with a serial interface.[get]
  *
  * @param  ctx      read / write interface definitions(ptr)
  * @param  val      get the values of if_inc in reg CTRL3_C
  * @retval          interface status (MANDATORY: return 0 -> no Error)
  *
  */
int32_t lsm6ds3_auto_increment_get(stmdev_ctx_t *ctx, uint8_t *val)
{
  lsm6ds3_ctrl3_c_t ctrl3_c;
  int32_t ret;

  ret = lsm6ds3_read_reg(ctx, LSM6DS3_CTRL3_C, (uint8_t *)&ctrl3_c, 1);
  *val = (uint8_t)ctrl3_c.if_inc;

  return ret;
}

/**
  * @brief   Reboot memory content. Reload the calibration parameters.[set]
  *
  * @param  ctx      read / write interface definitions(ptr)
  * @param  val      change the values of boot in reg CTRL3_C
  * @retval          interface status (MANDATORY: return 0 -> no Error)
  *
  */
int32_t lsm6ds3_boot_set(stmdev_ctx_t *ctx, uint8_t val)
{
  lsm6ds3_ctrl3_c_t ctrl3_c;
  int32_t ret;

  ret = lsm6ds3_read_reg(ctx, LSM6DS3_CTRL3_C, (uint8_t *)&ctrl3_c, 1);

  if (ret == 0)
  {
    ctrl3_c.boot = (uint8_t)val;
    ret = lsm6ds3_write_reg(ctx, LSM6DS3_CTRL3_C, (uint8_t *)&ctrl3_c, 1);
  }

  return ret;
}

/**
  * @brief   Reboot memory content. Reload the calibration parameters.[get]
  *
  * @param  ctx      read / write interface definitions(ptr)
  * @param  val      get the values of boot in reg CTRL3_C
  * @retval          interface status (MANDATORY: return 0 -> no Error)
  *
  */
int32_t lsm6ds3_boot_get(stmdev_ctx_t *ctx, uint8_t *val)
{
  lsm6ds3_ctrl3_c_t ctrl3_c;
  int32_t ret;

  ret = lsm6ds3_read_reg(ctx, LSM6DS3_CTRL3_C, (uint8_t *)&ctrl3_c, 1);
  *val = (uint8_t)ctrl3_c.boot;

  return ret;
}

/**
  * @brief   Linear acceleration sensor self-test enable.[set]
  *
  * @param  ctx      read / write interface definitions(ptr)
  * @param  val      change the values of st_xl in reg  LSM6DS3
  * @retval          interface status (MANDATORY: return 0 -> no Error)
  *
  */
int32_t lsm6ds3_xl_self_test_set(stmdev_ctx_t *ctx,
                                 lsm6ds3_st_xl_t val)
{
  lsm6ds3_ctrl5_c_t ctrl5_c;
  int32_t ret;

  ret = lsm6ds3_read_reg(ctx, LSM6DS3_CTRL5_C, (uint8_t *)&ctrl5_c, 1);

  if (ret == 0)
  {
    ctrl5_c.st_xl = (uint8_t)val;
    ret = lsm6ds3_write_reg(ctx, LSM6DS3_CTRL5_C, (uint8_t *)&ctrl5_c, 1);
  }

  return ret;
}

/**
  * @brief   Linear acceleration sensor self-test enable.[get]
  *
  * @param  ctx         read / write interface definitions(ptr)
  * @param  val         get the values of st_xl in reg CTRL5_C
  * @retval             interface status (MANDATORY: return 0 -> no Error)
  *
  */
int32_t lsm6ds3_xl_self_test_get(stmdev_ctx_t *ctx,
                                 lsm6ds3_st_xl_t *val)
{
  lsm6ds3_ctrl5_c_t ctrl5_c;
  int32_t ret;

  ret = lsm6ds3_read_reg(ctx, LSM6DS3_CTRL5_C, (uint8_t *)&ctrl5_c, 1);

  switch (ctrl5_c.st_xl)
  {
    case LSM6DS3_XL_ST_DISABLE:
      *val = LSM6DS3_XL_ST_DISABLE;
      break;

    case LSM6DS3_XL_ST_POSITIVE:
      *val = LSM6DS3_XL_ST_POSITIVE;
      break;

    case LSM6DS3_XL_ST_NEGATIVE:
      *val = LSM6DS3_XL_ST_NEGATIVE;
      break;

    default:
      *val = LSM6DS3_XL_ST_DISABLE;
      break;
  }

  return ret;
}

/**
  * @brief   Angular rate sensor self-test enable.[set]
  *
  * @param  ctx      read / write interface definitions(ptr)
  * @param  val      change the values of st_g in reg  LSM6DS3
  * @retval          interface status (MANDATORY: return 0 -> no Error)
  *
  */
int32_t lsm6ds3_gy_self_test_set(stmdev_ctx_t *ctx,
                                 lsm6ds3_st_g_t val)
{
  lsm6ds3_ctrl5_c_t ctrl5_c;
  int32_t ret;

  ret = lsm6ds3_read_reg(ctx, LSM6DS3_CTRL5_C, (uint8_t *)&ctrl5_c, 1);

  if (ret == 0)
  {
    ctrl5_c.st_g = (uint8_t)val;
    ret = lsm6ds3_write_reg(ctx, LSM6DS3_CTRL5_C, (uint8_t *)&ctrl5_c, 1);
  }

  return ret;
}

/**
  * @brief   Angular rate sensor self-test enable.[get]
  *
  * @param  ctx         read / write interface definitions(ptr)
  * @param  val         get the values of st_g in reg CTRL5_C
  * @retval             interface status (MANDATORY: return 0 -> no Error)
  *
  */
int32_t lsm6ds3_gy_self_test_get(stmdev_ctx_t *ctx,
                                 lsm6ds3_st_g_t *val)
{
  lsm6ds3_ctrl5_c_t ctrl5_c;
  int32_t ret;

  ret = lsm6ds3_read_reg(ctx, LSM6DS3_CTRL5_C, (uint8_t *)&ctrl5_c, 1);

  switch (ctrl5_c.st_g)
  {
    case LSM6DS3_GY_ST_DISABLE:
      *val = LSM6DS3_GY_ST_DISABLE;
      break;

    case LSM6DS3_GY_ST_POSITIVE:
      *val = LSM6DS3_GY_ST_POSITIVE;
      break;

    case LSM6DS3_GY_ST_NEGATIVE:
      *val = LSM6DS3_GY_ST_NEGATIVE;
      break;

    default:
      *val = LSM6DS3_GY_ST_DISABLE;
      break;
  }

  return ret;
}

/**
  * @}
  *
  */

/**
  * @defgroup    LSM6DS3_Filters
  * @brief       This section group all the functions concerning the
  *              filters configuration
  * @{
  *
  */

/**
  * @brief   Mask DRDY on pin (both XL & Gyro) until filter settling ends
  *          (XL and Gyro independently masked).[set]
  *
  * @param  ctx      read / write interface definitions(ptr)
  * @param  val      change the values of drdy_mask in reg CTRL4_C
  * @retval          interface status (MANDATORY: return 0 -> no Error)
  *
  */
int32_t lsm6ds3_filter_settling_mask_set(stmdev_ctx_t *ctx,
                                         uint8_t val)
{
  lsm6ds3_ctrl4_c_t ctrl4_c;
  int32_t ret;

  ret = lsm6ds3_read_reg(ctx, LSM6DS3_CTRL4_C, (uint8_t *)&ctrl4_c, 1);

  if (ret == 0)
  {
    ctrl4_c.drdy_mask = (uint8_t)val;
    ret = lsm6ds3_write_reg(ctx, LSM6DS3_CTRL4_C, (uint8_t *)&ctrl4_c, 1);
  }

  return ret;
}

/**
  * @brief   Mask DRDY on pin (both XL & Gyro) until filter settling ends
  *          (XL and Gyro independently masked).[get]
  *
  * @param  ctx      read / write interface definitions(ptr)
  * @param  val      get the values of drdy_mask in reg CTRL4_C
  * @retval          interface status (MANDATORY: return 0 -> no Error)
  *
  */
int32_t lsm6ds3_filter_settling_mask_get(stmdev_ctx_t *ctx,
                                         uint8_t *val)
{
  lsm6ds3_ctrl4_c_t ctrl4_c;
  int32_t ret;

  ret = lsm6ds3_read_reg(ctx, LSM6DS3_CTRL4_C, (uint8_t *)&ctrl4_c, 1);
  *val = (uint8_t)ctrl4_c.drdy_mask;

  return ret;
}

/**
  * @brief   Gyroscope high-pass filter cutoff frequency selection.[set]
  *
  * @param  ctx      read / write interface definitions(ptr)
  * @param  val      change the values of hpcf_g in reg  LSM6DS3
  * @retval          interface status (MANDATORY: return 0 -> no Error)
  *
  */
int32_t lsm6ds3_gy_hp_bandwidth_set(stmdev_ctx_t *ctx,
                                    lsm6ds3_hpcf_g_t val)
{
  lsm6ds3_ctrl7_g_t ctrl7_g;
  int32_t ret;

  ret = lsm6ds3_read_reg(ctx, LSM6DS3_CTRL7_G, (uint8_t *)&ctrl7_g, 1);

  if (ret == 0)
  {
    ctrl7_g.hpcf_g = (uint8_t)val;
    ret = lsm6ds3_write_reg(ctx, LSM6DS3_CTRL7_G, (uint8_t *)&ctrl7_g, 1);
  }

  return ret;
}

/**
  * @brief   Gyroscope high-pass filter cutoff frequency selection.[get]
  *
  * @param  ctx         read / write interface definitions(ptr)
  * @param  val         get the values of hpcf_g in reg CTRL7_G
  * @retval             interface status (MANDATORY: return 0 -> no Error)
  *
  */
int32_t lsm6ds3_gy_hp_bandwidth_get(stmdev_ctx_t *ctx,
                                    lsm6ds3_hpcf_g_t *val)
{
  lsm6ds3_ctrl7_g_t ctrl7_g;
  int32_t ret;

  ret = lsm6ds3_read_reg(ctx, LSM6DS3_CTRL7_G, (uint8_t *)&ctrl7_g, 1);

  switch (ctrl7_g.hpcf_g)
  {
    case LSM6DS3_HP_CUT_OFF_8mHz1:
      *val = LSM6DS3_HP_CUT_OFF_8mHz1;
      break;

    case LSM6DS3_HP_CUT_OFF_32mHz4:
      *val = LSM6DS3_HP_CUT_OFF_32mHz4;
      break;

    case LSM6DS3_HP_CUT_OFF_2Hz07:
      *val = LSM6DS3_HP_CUT_OFF_2Hz07;
      break;

    case LSM6DS3_HP_CUT_OFF_16Hz32:
      *val = LSM6DS3_HP_CUT_OFF_16Hz32;
      break;

    default:
      *val = LSM6DS3_HP_CUT_OFF_8mHz1;
      break;
  }

  return ret;
}

/**
  * @brief   Gyro digital HP filter reset.[set]
  *
  * @param  ctx      read / write interface definitions(ptr)
  * @param  val      change the values of hp_g_rst in reg CTRL7_G
  * @retval          interface status (MANDATORY: return 0 -> no Error)
  *
  */
int32_t lsm6ds3_gy_hp_reset_set(stmdev_ctx_t *ctx, uint8_t val)
{
  lsm6ds3_ctrl7_g_t ctrl7_g;
  int32_t ret;

  ret = lsm6ds3_read_reg(ctx, LSM6DS3_CTRL7_G, (uint8_t *)&ctrl7_g, 1);

  if (ret == 0)
  {
    ctrl7_g.hp_g_rst = (uint8_t)val;
    ret = lsm6ds3_write_reg(ctx, LSM6DS3_CTRL7_G, (uint8_t *)&ctrl7_g, 1);
  }

  return ret;
}

/**
  * @brief   Gyro digital HP filter reset.[get]
  *
  * @param  ctx      read / write interface definitions(ptr)
  * @param  val      get the values of hp_g_rst in reg CTRL7_G
  * @retval          interface status (MANDATORY: return 0 -> no Error)
  *
  */
int32_t lsm6ds3_gy_hp_reset_get(stmdev_ctx_t *ctx, uint8_t *val)
{
  lsm6ds3_ctrl7_g_t ctrl7_g;
  int32_t ret;

  ret = lsm6ds3_read_reg(ctx, LSM6DS3_CTRL7_G, (uint8_t *)&ctrl7_g, 1);
  *val = (uint8_t)ctrl7_g.hp_g_rst;

  return ret;
}

/**
  * @brief   Accelerometer slope filter and high-pass filter configuration
  *          and cut-off setting.[set]
  *
  * @param  ctx      read / write interface definitions(ptr)
  * @param  val      change the values of hp_slope_xl_en in reg  LSM6DS3
  * @retval          interface status (MANDATORY: return 0 -> no Error)
  *
  */
int32_t lsm6ds3_xl_hp_bandwidth_set(stmdev_ctx_t *ctx,
                                    lsm6ds3_hp_bw_t val)
{
  lsm6ds3_ctrl8_xl_t ctrl8_xl;
  int32_t ret;

  ret = lsm6ds3_read_reg(ctx, LSM6DS3_CTRL8_XL, (uint8_t *)&ctrl8_xl, 1);

  if (ret == 0)
  {
    ctrl8_xl.hp_slope_xl_en = PROPERTY_ENABLE;
    ctrl8_xl.hpcf_xl = (uint8_t)val;
    ret = lsm6ds3_write_reg(ctx, LSM6DS3_CTRL8_XL, (uint8_t *)&ctrl8_xl, 1);
  }

  return ret;
}

/**
  * @brief   Accelerometer slope filter and high-pass filter configuration
  *          and cut-off setting.[get]
  *
  * @param  ctx         read / write interface definitions(ptr)
  * @param  val         get the values of hp_slope_xl_en in reg CTRL8_XL
  * @retval             interface status (MANDATORY: return 0 -> no Error)
  *
  */
int32_t lsm6ds3_xl_hp_bandwidth_get(stmdev_ctx_t *ctx,
                                    lsm6ds3_hp_bw_t *val)
{
  lsm6ds3_ctrl8_xl_t ctrl8_xl;
  int32_t ret;

  ret = lsm6ds3_read_reg(ctx, LSM6DS3_CTRL8_XL, (uint8_t *)&ctrl8_xl, 1);

  switch (ctrl8_xl.hpcf_xl)
  {
    case LSM6DS3_XL_HP_ODR_DIV_4:
      *val = LSM6DS3_XL_HP_ODR_DIV_4;
      break;

    case LSM6DS3_XL_HP_ODR_DIV_100:
      *val = LSM6DS3_XL_HP_ODR_DIV_100;
      break;

    case LSM6DS3_XL_HP_ODR_DIV_9:
      *val = LSM6DS3_XL_HP_ODR_DIV_9;
      break;

    case LSM6DS3_XL_HP_ODR_DIV_400:
      *val = LSM6DS3_XL_HP_ODR_DIV_400;
      break;

    default:
      *val = LSM6DS3_XL_HP_ODR_DIV_4;
      break;
  }

  return ret;
}

/**
  * @brief    Accelerometer low-pass filter configuration and
  *           cut-off setting.[set]
  *
  * @param  ctx      read / write interface definitions(ptr)
  * @param  val      change the values of lpf2_xl_en in reg  LSM6DS3
  * @retval          interface status (MANDATORY: return 0 -> no Error)
  *
  */
int32_t lsm6ds3_xl_lp2_bandwidth_set(stmdev_ctx_t *ctx,
                                     lsm6ds3_lp_bw_t val)
{
  lsm6ds3_ctrl8_xl_t ctrl8_xl;
  int32_t ret;

  ret = lsm6ds3_read_reg(ctx, LSM6DS3_CTRL8_XL, (uint8_t *)&ctrl8_xl, 1);

  if (ret == 0)
  {
    ctrl8_xl.lpf2_xl_en = PROPERTY_ENABLE;
    ctrl8_xl.hpcf_xl = (uint8_t)val;
    ret = lsm6ds3_write_reg(ctx, LSM6DS3_CTRL8_XL, (uint8_t *)&ctrl8_xl, 1);
  }

  return ret;
}

/**
  * @brief    Accelerometer low-pass filter configuration and cut-off
  *           setting.[get]
  *
  * @param  ctx         read / write interface definitions(ptr)
  * @param  val         get the values of lpf2_xl_en in reg CTRL8_XL
  * @retval             interface status (MANDATORY: return 0 -> no Error)
  *
  */
int32_t lsm6ds3_xl_lp2_bandwidth_get(stmdev_ctx_t *ctx,
                                     lsm6ds3_lp_bw_t *val)
{
  lsm6ds3_ctrl8_xl_t ctrl8_xl;
  int32_t ret;

  ret = lsm6ds3_read_reg(ctx, LSM6DS3_CTRL8_XL, (uint8_t *)&ctrl8_xl, 1);

  switch (ctrl8_xl.hpcf_xl)
  {
    case LSM6DS3_XL_LP_ODR_DIV_50:
      *val = LSM6DS3_XL_LP_ODR_DIV_50;
      break;

    case LSM6DS3_XL_LP_ODR_DIV_100:
      *val = LSM6DS3_XL_LP_ODR_DIV_100;
      break;

    case LSM6DS3_XL_LP_ODR_DIV_9:
      *val = LSM6DS3_XL_LP_ODR_DIV_9;
      break;

    case LSM6DS3_XL_LP_ODR_DIV_400:
      *val = LSM6DS3_XL_LP_ODR_DIV_400;
      break;

    default:
      *val = LSM6DS3_XL_LP_ODR_DIV_50;
      break;
  }

  return ret;
}

/**
  * @brief   Anti-aliasing filter bandwidth selection.[set]
  *
  * @param  ctx      read / write interface definitions(ptr)
  * @param  val      change the values of bw_xl in reg  LSM6DS3
  * @retval          interface status (MANDATORY: return 0 -> no Error)
  *
  */
int32_t lsm6ds3_xl_filter_analog_set(stmdev_ctx_t *ctx,
                                     lsm6ds3_bw_xl_t val)
{
  lsm6ds3_ctrl1_xl_t ctrl1_xl;
  int32_t ret;

  ret = lsm6ds3_read_reg(ctx, LSM6DS3_CTRL1_XL, (uint8_t *)&ctrl1_xl, 1);

  if (ret == 0)
  {
    ctrl1_xl.bw_xl = (uint8_t)val;
    ret = lsm6ds3_write_reg(ctx, LSM6DS3_CTRL1_XL, (uint8_t *)&ctrl1_xl, 1);
  }

  return ret;
}

/**
  * @brief   Anti-aliasing filter bandwidth selection.[get]
  *
  * @param  ctx         read / write interface definitions(ptr)
  * @param  val         get the values of bw_xl in reg CTRL1_XL
  * @retval             interface status (MANDATORY: return 0 -> no Error)
  *
  */
int32_t lsm6ds3_xl_filter_analog_get(stmdev_ctx_t *ctx,
                                     lsm6ds3_bw_xl_t *val)
{
  lsm6ds3_ctrl1_xl_t ctrl1_xl;
  int32_t ret;

  ret = lsm6ds3_read_reg(ctx, LSM6DS3_CTRL1_XL, (uint8_t *)&ctrl1_xl, 1);

  switch (ctrl1_xl.bw_xl)
  {
    case  LSM6DS3_ANTI_ALIASING_400Hz:
      *val =  LSM6DS3_ANTI_ALIASING_400Hz;
      break;

    case  LSM6DS3_ANTI_ALIASING_200Hz:
      *val =  LSM6DS3_ANTI_ALIASING_200Hz;
      break;

    case  LSM6DS3_ANTI_ALIASING_100Hz:
      *val =  LSM6DS3_ANTI_ALIASING_100Hz;
      break;

    case LSM6DS3_ANTI_ALIASING_50Hz:
      *val = LSM6DS3_ANTI_ALIASING_50Hz;
      break;

    default:
      *val =  LSM6DS3_ANTI_ALIASING_400Hz;
      break;
  }

  return ret;
}

/**
  * @}
  *
  */

/**
  * @defgroup    LSM6DS3_Serial_interface
  * @brief       This section groups all the functions concerning main
  *              serial interface management (not auxiliary)
  * @{
  *
  */

/**
  * @brief   SPI Serial Interface Mode selection.[set]
  *
  * @param  ctx      read / write interface definitions(ptr)
  * @param  val      change the values of sim in reg  LSM6DS3
  * @retval          interface status (MANDATORY: return 0 -> no Error)
  *
  */
int32_t lsm6ds3_spi_mode_set(stmdev_ctx_t *ctx, lsm6ds3_sim_t val)
{
  lsm6ds3_ctrl3_c_t ctrl3_c;
  int32_t ret;

  ret = lsm6ds3_read_reg(ctx, LSM6DS3_CTRL3_C, (uint8_t *)&ctrl3_c, 1);

  if (ret == 0)
  {
    ctrl3_c.sim = (uint8_t)val;
    ret = lsm6ds3_write_reg(ctx, LSM6DS3_CTRL3_C, (uint8_t *)&ctrl3_c, 1);
  }

  return ret;
}

/**
  * @brief   SPI Serial Interface Mode selection.[get]
  *
  * @param  ctx         read / write interface definitions(ptr)
  * @param  val         get the values of sim in reg CTRL3_C
  * @retval             interface status (MANDATORY: return 0 -> no Error)
  *
  */
int32_t lsm6ds3_spi_mode_get(stmdev_ctx_t *ctx, lsm6ds3_sim_t *val)
{
  lsm6ds3_ctrl3_c_t ctrl3_c;
  int32_t ret;

  ret = lsm6ds3_read_reg(ctx, LSM6DS3_CTRL3_C, (uint8_t *)&ctrl3_c, 1);

  switch (ctrl3_c.sim)
  {
    case LSM6DS3_SPI_4_WIRE:
      *val = LSM6DS3_SPI_4_WIRE;
      break;

    case LSM6DS3_SPI_3_WIRE:
      *val = LSM6DS3_SPI_3_WIRE;
      break;

    default:
      *val = LSM6DS3_SPI_4_WIRE;
      break;
  }

  return ret;
}

/**
  * @brief   Disable / Enable I2C interface.[set]
  *
  * @param  ctx      read / write interface definitions(ptr)
  * @param  val      change the values of i2c_disable in reg  LSM6DS3
  * @retval          interface status (MANDATORY: return 0 -> no Error)
  *
  */
int32_t lsm6ds3_i2c_interface_set(stmdev_ctx_t *ctx,
                                  lsm6ds3_i2c_dis_t val)
{
  lsm6ds3_ctrl4_c_t ctrl4_c;
  int32_t ret;

  ret = lsm6ds3_read_reg(ctx, LSM6DS3_CTRL4_C, (uint8_t *)&ctrl4_c, 1);

  if (ret == 0)
  {
    ctrl4_c.i2c_disable = (uint8_t)val;
    ret = lsm6ds3_write_reg(ctx, LSM6DS3_CTRL4_C, (uint8_t *)&ctrl4_c, 1);
  }

  return ret;
}

/**
  * @brief   Disable / Enable I2C interface.[get]
  *
  * @param  ctx         read / write interface definitions(ptr)
  * @param  val         get the values of i2c_disable in reg CTRL4_C
  * @retval             interface status (MANDATORY: return 0 -> no Error)
  *
  */
int32_t lsm6ds3_i2c_interface_get(stmdev_ctx_t *ctx,
                                  lsm6ds3_i2c_dis_t *val)
{
  lsm6ds3_ctrl4_c_t ctrl4_c;
  int32_t ret;

  ret = lsm6ds3_read_reg(ctx, LSM6DS3_CTRL4_C, (uint8_t *)&ctrl4_c, 1);

  switch (ctrl4_c.i2c_disable)
  {
    case LSM6DS3_I2C_ENABLE:
      *val = LSM6DS3_I2C_ENABLE;
      break;

    case LSM6DS3_I2C_DISABLE:
      *val = LSM6DS3_I2C_DISABLE;
      break;

    default:
      *val = LSM6DS3_I2C_ENABLE;
      break;
  }

  return ret;
}

/**
  * @}
  *
  */

/**
  * @defgroup    LSM6DS3_Interrupt_pins
  * @brief       This section groups all the functions that manage
  *              interrupt pins
  * @{
  *
  */

/**
  * @brief   Select the signal that need to route on int1 pad.[set]
  *
  * @param  ctx         read / write interface definitions(ptr)
  * @param  val          Select the signal that need to route on int1 pad.
  * @retval             interface status (MANDATORY: return 0 -> no Error)
  *
  */
int32_t lsm6ds3_pin_int1_route_set(stmdev_ctx_t *ctx,
                                   lsm6ds3_int1_route_t *val)
{
  lsm6ds3_int1_ctrl_t int1_ctrl;
  lsm6ds3_md1_cfg_t md1_cfg;
  lsm6ds3_master_config_t master_config;
  int32_t ret;

  ret = lsm6ds3_read_reg(ctx, LSM6DS3_MASTER_CONFIG,
                         (uint8_t *)&master_config, 1);

  if (ret == 0)
  {
    int1_ctrl.int1_drdy_xl        = val->int1_drdy_xl;
    int1_ctrl.int1_drdy_g         = val->int1_drdy_g;
    int1_ctrl.int1_boot           = val->int1_boot;
    int1_ctrl.int1_fth            = val->int1_fth;
    int1_ctrl.int1_fifo_ovr       = val->int1_fifo_ovr;
    int1_ctrl.int1_full_flag      = val->int1_full_flag;
    int1_ctrl.int1_sign_mot       = val->int1_sign_mot;
    int1_ctrl.int1_step_detector  = val->int1_step_detector;
    md1_cfg.int1_timer            = val->int1_timer;
    md1_cfg.int1_tilt             = val->int1_tilt;
    md1_cfg.int1_6d               = val->int1_6d;
    md1_cfg.int1_double_tap       = val->int1_double_tap;
    md1_cfg.int1_ff               = val->int1_ff;
    md1_cfg.int1_wu               = val->int1_wu;
    md1_cfg.int1_single_tap       = val->int1_single_tap;
    md1_cfg.int1_inact_state      = val->int1_inact_state;
    master_config.drdy_on_int1    = val->drdy_on_int1;
    ret = lsm6ds3_write_reg(ctx, LSM6DS3_INT1_CTRL, (uint8_t *)&int1_ctrl, 1);

    if (ret == 0)
    {
      ret = lsm6ds3_write_reg(ctx, LSM6DS3_MD1_CFG, (uint8_t *)&md1_cfg, 1);
    }

    if (ret == 0)
    {
      ret = lsm6ds3_write_reg(ctx, LSM6DS3_MASTER_CONFIG,
                              (uint8_t *)&master_config, 1);
    }
  }

  return ret;
}

/**
  * @brief   Select the signal that need to route on int1 pad.[get]
  *
  * @param  ctx         read / write interface definitions(ptr)
  * @param  val         Select the signal that need to route on int1 pad.
  * @retval             interface status (MANDATORY: return 0 -> no Error)
  *
  */
int32_t lsm6ds3_pin_int1_route_get(stmdev_ctx_t *ctx,
                                   lsm6ds3_int1_route_t *val)
{
  lsm6ds3_int1_ctrl_t int1_ctrl;
  lsm6ds3_md1_cfg_t md1_cfg;
  lsm6ds3_master_config_t master_config;
  int32_t ret;

  ret = lsm6ds3_read_reg(ctx, LSM6DS3_INT1_CTRL, (uint8_t *)&int1_ctrl, 1);

  if (ret == 0)
  {
    ret = lsm6ds3_read_reg(ctx, LSM6DS3_MD1_CFG, (uint8_t *)&md1_cfg, 1);
  }

  if (ret == 0)
  {
    ret = lsm6ds3_read_reg(ctx, LSM6DS3_MASTER_CONFIG,
                           (uint8_t *)&master_config, 1);
  }

  if (ret == 0)
  {
    val->int1_drdy_xl        = int1_ctrl.int1_drdy_xl;
    val->int1_drdy_g         = int1_ctrl.int1_drdy_g;
    val->int1_boot           = int1_ctrl.int1_boot;
    val->int1_fth            = int1_ctrl.int1_fth;
    val->int1_fifo_ovr       = int1_ctrl.int1_fifo_ovr;
    val->int1_full_flag      = int1_ctrl.int1_full_flag;
    val->int1_sign_mot       = int1_ctrl.int1_sign_mot;
    val->int1_step_detector  = int1_ctrl.int1_step_detector;
    val->int1_timer          = md1_cfg.int1_timer;
    val->int1_tilt           = md1_cfg.int1_tilt;
    val->int1_6d             = md1_cfg.int1_6d;
    val->int1_double_tap     = md1_cfg.int1_double_tap;
    val->int1_ff             = md1_cfg.int1_ff;
    val->int1_wu             = md1_cfg.int1_wu;
    val->int1_single_tap     = md1_cfg.int1_single_tap;
    val->int1_inact_state    = md1_cfg.int1_inact_state;
    val->drdy_on_int1        = master_config.drdy_on_int1;
  }

  return ret;
}

/**
  * @brief   Select the signal that need to route on int1 pad.[set]
  *
  * @param  ctx         read / write interface definitions(ptr)
  * @param  val         Select the signal that need to route on int1 pad.
  * @retval          interface status (MANDATORY: return 0 -> no Error)
  *
  */
int32_t lsm6ds3_pin_int2_route_set(stmdev_ctx_t *ctx,
                                   lsm6ds3_int2_route_t *val)
{
  lsm6ds3_int2_ctrl_t int2_ctrl;
  lsm6ds3_md2_cfg_t md2_cfg;
  lsm6ds3_master_config_t master_config;
  int32_t ret;

  ret = lsm6ds3_read_reg(ctx, LSM6DS3_MASTER_CONFIG,
                         (uint8_t *)&master_config, 1);

  if (ret == 0)
  {
    int2_ctrl.int2_drdy_xl       = val->int2_drdy_xl;
    int2_ctrl.int2_drdy_g        = val->int2_drdy_g;
    int2_ctrl.int2_drdy_temp     = val->int2_drdy_temp;
    int2_ctrl.int2_fth           = val->int2_fth;
    int2_ctrl.int2_fifo_ovr      = val->int2_fifo_ovr;
    int2_ctrl.int2_full_flag     = val->int2_full_flag;
    int2_ctrl.int2_step_count_ov = val->int2_step_count_ov;
    int2_ctrl.int2_step_delta    = val->int2_step_delta;
    md2_cfg.int2_iron            = val->int2_iron;
    md2_cfg.int2_tilt            = val->int2_tilt;
    md2_cfg.int2_6d              = val->int2_6d;
    md2_cfg.int2_double_tap      = val->int2_double_tap;
    md2_cfg.int2_ff              = val->int2_ff;
    md2_cfg.int2_wu              = val->int2_wu;
    md2_cfg.int2_single_tap      = val->int2_single_tap;
    md2_cfg.int2_inact_state     = val->int2_inact_state;
    master_config.start_config   = val->start_config;
    ret = lsm6ds3_write_reg(ctx, LSM6DS3_INT2_CTRL, (uint8_t *)&int2_ctrl, 1);
  }

  if (ret == 0)
  {
    ret = lsm6ds3_write_reg(ctx, LSM6DS3_MD2_CFG, (uint8_t *)&md2_cfg, 1);
  }

  if (ret == 0)
  {
    ret = lsm6ds3_write_reg(ctx, LSM6DS3_MASTER_CONFIG,
                            (uint8_t *)&master_config, 1);
  }

  return ret;
}

/**
  * @brief   Select the signal that need to route on int1 pad.[get]
  *
  * @param  ctx         read / write interface definitions(ptr)
  * @param  val         Select the signal that need to route on int1 pad.
  * @retval          interface status (MANDATORY: return 0 -> no Error)
  *
  */
int32_t lsm6ds3_pin_int2_route_get(stmdev_ctx_t *ctx,
                                   lsm6ds3_int2_route_t *val)
{
  lsm6ds3_int2_ctrl_t int2_ctrl;
  lsm6ds3_md2_cfg_t md2_cfg;
  lsm6ds3_master_config_t master_config;
  int32_t ret;

  ret = lsm6ds3_read_reg(ctx, LSM6DS3_INT2_CTRL, (uint8_t *)&int2_ctrl, 1);

  if (ret == 0)
  {
    ret = lsm6ds3_read_reg(ctx, LSM6DS3_MD2_CFG, (uint8_t *)&md2_cfg, 1);
  }

  if (ret == 0)
  {
    ret = lsm6ds3_read_reg(ctx, LSM6DS3_MASTER_CONFIG,
                           (uint8_t *)&master_config, 1);
    val->int2_drdy_xl       = int2_ctrl.int2_drdy_xl;
    val->int2_drdy_g        = int2_ctrl.int2_drdy_g;
    val->int2_drdy_temp     = int2_ctrl.int2_drdy_temp;
    val->int2_fth           = int2_ctrl.int2_fth;
    val->int2_fifo_ovr      = int2_ctrl.int2_fifo_ovr;
    val->int2_full_flag     = int2_ctrl.int2_full_flag;
    val->int2_step_count_ov = int2_ctrl.int2_step_count_ov;
    val->int2_step_delta    = int2_ctrl.int2_step_delta;
    val->int2_iron          = md2_cfg.int2_iron;
    val->int2_tilt          = md2_cfg.int2_tilt;
    val->int2_6d            = md2_cfg.int2_6d;
    val->int2_double_tap    = md2_cfg.int2_double_tap;
    val->int2_ff            = md2_cfg.int2_ff;
    val->int2_wu            = md2_cfg.int2_wu;
    val->int2_single_tap    = md2_cfg.int2_single_tap;
    val->int2_inact_state   = md2_cfg.int2_inact_state;
    val->start_config       = master_config.start_config;
  }

  return ret;
}

/**
  * @brief   Push-pull/open drain selection on interrupt pads.[set]
  *
  * @param  ctx      read / write interface definitions(ptr)
  * @param  val      change the values of pp_od in reg  LSM6DS3
  * @retval          interface status (MANDATORY: return 0 -> no Error)
  *
  */
int32_t lsm6ds3_pin_mode_set(stmdev_ctx_t *ctx, lsm6ds3_pp_od_t val)
{
  lsm6ds3_ctrl3_c_t ctrl3_c;
  int32_t ret;

  ret = lsm6ds3_read_reg(ctx, LSM6DS3_CTRL3_C, (uint8_t *)&ctrl3_c, 1);

  if (ret == 0)
  {
    ctrl3_c.pp_od = (uint8_t)val;
    ret = lsm6ds3_write_reg(ctx, LSM6DS3_CTRL3_C, (uint8_t *)&ctrl3_c, 1);
  }

  return ret;
}

/**
  * @brief   Push-pull/open drain selection on interrupt pads.[get]
  *
  * @param  ctx         read / write interface definitions(ptr)
  * @param  val         get the values of pp_od in reg CTRL3_C
  * @retval          interface status (MANDATORY: return 0 -> no Error)
  *
  */
int32_t lsm6ds3_pin_mode_get(stmdev_ctx_t *ctx, lsm6ds3_pp_od_t *val)
{
  lsm6ds3_ctrl3_c_t ctrl3_c;
  int32_t ret;

  ret = lsm6ds3_read_reg(ctx, LSM6DS3_CTRL3_C, (uint8_t *)&ctrl3_c, 1);

  switch (ctrl3_c.pp_od)
  {
    case LSM6DS3_PUSH_PULL:
      *val = LSM6DS3_PUSH_PULL;
      break;

    case LSM6DS3_OPEN_DRAIN:
      *val = LSM6DS3_OPEN_DRAIN;
      break;

    default:
      *val = LSM6DS3_PUSH_PULL;
      break;
  }

  return ret;
}

/**
  * @brief   Interrupt active-high/low.Interrupt active-high/low.[set]
  *
  * @param  ctx      read / write interface definitions(ptr)
  * @param  val      change the values of h_lactive in reg  LSM6DS3
  * @retval          interface status (MANDATORY: return 0 -> no Error)
  *
  */
int32_t lsm6ds3_pin_polarity_set(stmdev_ctx_t *ctx,
                                 lsm6ds3_pin_pol_t val)
{
  lsm6ds3_ctrl3_c_t ctrl3_c;
  int32_t ret;

  ret = lsm6ds3_read_reg(ctx, LSM6DS3_CTRL3_C, (uint8_t *)&ctrl3_c, 1);

  if (ret == 0)
  {
    ctrl3_c.h_lactive = (uint8_t)val;
    ret = lsm6ds3_write_reg(ctx, LSM6DS3_CTRL3_C, (uint8_t *)&ctrl3_c, 1);
  }

  return ret;
}

/**
  * @brief   Interrupt active-high/low.Interrupt active-high/low.[get]
  *
  * @param  ctx         read / write interface definitions(ptr)
  * @param  val         get the values of h_lactive in reg CTRL3_C
  * @retval          interface status (MANDATORY: return 0 -> no Error)
  *
  */
int32_t lsm6ds3_pin_polarity_get(stmdev_ctx_t *ctx,
                                 lsm6ds3_pin_pol_t *val)
{
  lsm6ds3_ctrl3_c_t ctrl3_c;
  int32_t ret;

  ret = lsm6ds3_read_reg(ctx, LSM6DS3_CTRL3_C, (uint8_t *)&ctrl3_c, 1);

  switch (ctrl3_c.h_lactive)
  {
    case LSM6DS3_ACTIVE_HIGH:
      *val = LSM6DS3_ACTIVE_HIGH;
      break;

    case LSM6DS3_ACTIVE_LOW:
      *val = LSM6DS3_ACTIVE_LOW;
      break;

    default:
      *val = LSM6DS3_ACTIVE_HIGH;
      break;
  }

  return ret;
}

/**
  * @brief   All interrupt signals become available on INT1 pin.[set]
  *
  * @param  ctx      read / write interface definitions(ptr)
  * @param  val      change the values of int2_on_int1 in reg CTRL4_C
  * @retval          interface status (MANDATORY: return 0 -> no Error)
  *
  */
int32_t lsm6ds3_all_on_int1_set(stmdev_ctx_t *ctx, uint8_t val)
{
  lsm6ds3_ctrl4_c_t ctrl4_c;
  int32_t ret;

  ret = lsm6ds3_read_reg(ctx, LSM6DS3_CTRL4_C, (uint8_t *)&ctrl4_c, 1);

  if (ret == 0)
  {
    ctrl4_c.int2_on_int1 = (uint8_t)val;
    ret = lsm6ds3_write_reg(ctx, LSM6DS3_CTRL4_C, (uint8_t *)&ctrl4_c, 1);
  }

  return ret;
}

/**
  * @brief   All interrupt signals become available on INT1 pin.[get]
  *
  * @param  ctx      read / write interface definitions(ptr)
  * @param  val      get the values of int2_on_int1 in reg CTRL4_C
  * @retval          interface status (MANDATORY: return 0 -> no Error)
  *
  */
int32_t lsm6ds3_all_on_int1_get(stmdev_ctx_t *ctx, uint8_t *val)
{
  lsm6ds3_ctrl4_c_t ctrl4_c;
  int32_t ret;

  ret = lsm6ds3_read_reg(ctx, LSM6DS3_CTRL4_C, (uint8_t *)&ctrl4_c, 1);
  *val = (uint8_t)ctrl4_c.int2_on_int1;

  return ret;
}

/**
  * @brief   Latched/pulsed interrupt.[set]
  *
  * @param  ctx      read / write interface definitions(ptr)
  * @param  val      change the values of lir in reg  LSM6DS3
  * @retval          interface status (MANDATORY: return 0 -> no Error)
  *
  */
int32_t lsm6ds3_int_notification_set(stmdev_ctx_t *ctx,
                                     lsm6ds3_lir_t val)
{
  lsm6ds3_tap_cfg_t tap_cfg;
  int32_t ret;

  ret = lsm6ds3_read_reg(ctx, LSM6DS3_TAP_CFG, (uint8_t *)&tap_cfg, 1);

  if (ret == 0)
  {
    tap_cfg.lir = (uint8_t)val;
    ret = lsm6ds3_write_reg(ctx, LSM6DS3_TAP_CFG, (uint8_t *)&tap_cfg, 1);
  }

  return ret;
}

/**
  * @brief   Latched/pulsed interrupt.[get]
  *
  * @param  ctx         read / write interface definitions(ptr)
  * @param  val         get the values of lir in reg TAP_CFG
  * @retval          interface status (MANDATORY: return 0 -> no Error)
  *
  */
int32_t lsm6ds3_int_notification_get(stmdev_ctx_t *ctx,
                                     lsm6ds3_lir_t *val)
{
  lsm6ds3_tap_cfg_t tap_cfg;
  int32_t ret;

  ret = lsm6ds3_read_reg(ctx, LSM6DS3_TAP_CFG, (uint8_t *)&tap_cfg, 1);

  switch (tap_cfg.lir)
  {
    case LSM6DS3_INT_PULSED:
      *val = LSM6DS3_INT_PULSED;
      break;

    case LSM6DS3_INT_LATCHED:
      *val = LSM6DS3_INT_LATCHED;
      break;

    default:
      *val = LSM6DS3_INT_PULSED;
      break;
  }

  return ret;
}

/**
  * @}
  *
  */

/**
  * @defgroup    LSM6DS3_Wake_Up_event
  * @brief       This section groups all the functions that manage the
  *              Wake Up event generation.
  * @{
  *
  */

/**
  * @brief   Read the wake_up_src status flag of the device.[get]
  *
  * @param  ctx         read / write interface definitions(ptr)
  * @param  val          Read the wake_up_src status flag of the device.
  * @retval          interface status (MANDATORY: return 0 -> no Error)
  *
  */
int32_t lsm6ds3_wkup_src_get(stmdev_ctx_t *ctx,
                             lsm6ds3_wake_up_src_t *val)
{
  int32_t ret;

  ret = lsm6ds3_read_reg(ctx, LSM6DS3_WAKE_UP_SRC, (uint8_t *)val, 1);

  return ret;
}

/**
  * @brief   Threshold for wakeup (1 LSB = FS_XL / 64).[set]
  *
  * @param  ctx      read / write interface definitions(ptr)
  * @param  val      change the values of wk_ths in reg WAKE_UP_THS
  * @retval          interface status (MANDATORY: return 0 -> no Error)
  *
  */
int32_t lsm6ds3_wkup_threshold_set(stmdev_ctx_t *ctx, uint8_t val)
{
  lsm6ds3_wake_up_ths_t wake_up_ths;
  int32_t ret;

  ret = lsm6ds3_read_reg(ctx, LSM6DS3_WAKE_UP_THS,
                         (uint8_t *)&wake_up_ths, 1);

  if (ret == 0)
  {
    wake_up_ths.wk_ths = (uint8_t)val;
    ret = lsm6ds3_write_reg(ctx, LSM6DS3_WAKE_UP_THS,
                            (uint8_t *)&wake_up_ths, 1);
  }

  return ret;
}

/**
  * @brief   Threshold for wakeup (1 LSB = FS_XL / 64).[get]
  *
  * @param  ctx      read / write interface definitions(ptr)
  * @param  val      get the values of wk_ths in reg WAKE_UP_THS
  * @retval          interface status (MANDATORY: return 0 -> no Error)
  *
  */
int32_t lsm6ds3_wkup_threshold_get(stmdev_ctx_t *ctx, uint8_t *val)
{
  lsm6ds3_wake_up_ths_t wake_up_ths;
  int32_t ret;

  ret = lsm6ds3_read_reg(ctx, LSM6DS3_WAKE_UP_THS,
                         (uint8_t *)&wake_up_ths, 1);
  *val = (uint8_t)wake_up_ths.wk_ths;

  return ret;
}

/**
  * @brief   Wake up duration event.1LSb = 1 / ODR[set]
  *
  * @param  ctx      read / write interface definitions(ptr)
  * @param  val      change the values of wake_dur in reg WAKE_UP_DUR
  * @retval          interface status (MANDATORY: return 0 -> no Error)
  *
  */
int32_t lsm6ds3_wkup_dur_set(stmdev_ctx_t *ctx, uint8_t val)
{
  lsm6ds3_wake_up_dur_t wake_up_dur;
  int32_t ret;

  ret = lsm6ds3_read_reg(ctx, LSM6DS3_WAKE_UP_DUR,
                         (uint8_t *)&wake_up_dur, 1);

  if (ret == 0)
  {
    wake_up_dur.wake_dur = (uint8_t)val;
    ret = lsm6ds3_write_reg(ctx, LSM6DS3_WAKE_UP_DUR,
                            (uint8_t *)&wake_up_dur, 1);
  }

  return ret;
}

/**
  * @brief   Wake up duration event.1LSb = 1 / ODR[get]
  *
  * @param  ctx      read / write interface definitions(ptr)
  * @param  val      get the values of wake_dur in reg WAKE_UP_DUR
  * @retval          interface status (MANDATORY: return 0 -> no Error)
  *
  */
int32_t lsm6ds3_wkup_dur_get(stmdev_ctx_t *ctx, uint8_t *val)
{
  lsm6ds3_wake_up_dur_t wake_up_dur;
  int32_t ret;

  ret = lsm6ds3_read_reg(ctx, LSM6DS3_WAKE_UP_DUR,
                         (uint8_t *)&wake_up_dur, 1);
  *val = (uint8_t)wake_up_dur.wake_dur;

  return ret;
}

/**
  * @}
  *
  */

/**
  * @defgroup    LSM6DS3_Activity/Inactivity_detection
  * @brief       This section groups all the functions concerning
  *              activity/inactivity detection.
  * @{
  *
  */

/**
  * @brief   Enables gyroscope Sleep mode.[set]
  *
  * @param  ctx      read / write interface definitions(ptr)
  * @param  val      change the values of sleep_g in reg CTRL4_C
  * @retval          interface status (MANDATORY: return 0 -> no Error)
  *
  */
int32_t lsm6ds3_gy_sleep_mode_set(stmdev_ctx_t *ctx, uint8_t val)
{
  lsm6ds3_ctrl4_c_t ctrl4_c;
  int32_t ret;

  ret = lsm6ds3_read_reg(ctx, LSM6DS3_CTRL4_C, (uint8_t *)&ctrl4_c, 1);

  if (ret == 0)
  {
    ctrl4_c.sleep_g = (uint8_t)val;
    ret = lsm6ds3_write_reg(ctx, LSM6DS3_CTRL4_C, (uint8_t *)&ctrl4_c, 1);
  }

  return ret;
}

/**
  * @brief   Enables gyroscope Sleep mode.[get]
  *
  * @param  ctx      read / write interface definitions(ptr)
  * @param  val      get the values of sleep_g in reg CTRL4_C
  * @retval          interface status (MANDATORY: return 0 -> no Error)
  *
  */
int32_t lsm6ds3_gy_sleep_mode_get(stmdev_ctx_t *ctx, uint8_t *val)
{
  lsm6ds3_ctrl4_c_t ctrl4_c;
  int32_t ret;

  ret = lsm6ds3_read_reg(ctx, LSM6DS3_CTRL4_C, (uint8_t *)&ctrl4_c, 1);
  *val = (uint8_t)ctrl4_c.sleep_g;

  return ret;
}

/**
  * @brief   Enable/Disable inactivity function.[set]
  *
  * @param  ctx      read / write interface definitions(ptr)
  * @param  val      change the values of inactivity in reg  LSM6DS3
  * @retval          interface status (MANDATORY: return 0 -> no Error)
  *
  */
int32_t lsm6ds3_act_mode_set(stmdev_ctx_t *ctx, uint8_t val)
{
  lsm6ds3_wake_up_ths_t wake_up_ths;
  int32_t ret;

  ret = lsm6ds3_read_reg(ctx, LSM6DS3_WAKE_UP_THS,
                         (uint8_t *)&wake_up_ths, 1);

  if (ret == 0)
  {
    wake_up_ths.inactivity = (uint8_t)val;
    ret = lsm6ds3_write_reg(ctx, LSM6DS3_WAKE_UP_THS,
                            (uint8_t *)&wake_up_ths, 1);
  }

  return ret;
}

/**
  * @brief   Enable/Disable inactivity function.[get]
  *
  * @param  ctx         read / write interface definitions(ptr)
  * @param  val         get the values of inactivity in reg WAKE_UP_THS
  * @retval          interface status (MANDATORY: return 0 -> no Error)
  *
  */
int32_t lsm6ds3_act_mode_get(stmdev_ctx_t *ctx, uint8_t *val)
{
  lsm6ds3_wake_up_ths_t wake_up_ths;
  int32_t ret;

  ret = lsm6ds3_read_reg(ctx, LSM6DS3_WAKE_UP_THS,
                         (uint8_t *)&wake_up_ths, 1);
  *val = wake_up_ths.inactivity;

  return ret;
}

/**
  * @brief   Duration to go in sleep mode. 1 LSb = 512 / ODR[set]
  *
  * @param  ctx      read / write interface definitions(ptr)
  * @param  val      change the values of sleep_dur in reg WAKE_UP_DUR
  * @retval          interface status (MANDATORY: return 0 -> no Error)
  *
  */
int32_t lsm6ds3_act_sleep_dur_set(stmdev_ctx_t *ctx, uint8_t val)
{
  lsm6ds3_wake_up_dur_t wake_up_dur;
  int32_t ret;

  ret = lsm6ds3_read_reg(ctx, LSM6DS3_WAKE_UP_DUR,
                         (uint8_t *)&wake_up_dur, 1);

  if (ret == 0)
  {
    wake_up_dur.sleep_dur = (uint8_t)val;
    ret = lsm6ds3_write_reg(ctx, LSM6DS3_WAKE_UP_DUR,
                            (uint8_t *)&wake_up_dur, 1);
  }

  return ret;
}

/**
  * @brief   Duration to go in sleep mode. 1 LSb = 512 / ODR[get]
  *
  * @param  ctx      read / write interface definitions(ptr)
  * @param  val      get the values of sleep_dur in reg WAKE_UP_DUR
  * @retval          interface status (MANDATORY: return 0 -> no Error)
  *
  */
int32_t lsm6ds3_act_sleep_dur_get(stmdev_ctx_t *ctx, uint8_t *val)
{
  lsm6ds3_wake_up_dur_t wake_up_dur;
  int32_t ret;

  ret = lsm6ds3_read_reg(ctx, LSM6DS3_WAKE_UP_DUR,
                         (uint8_t *)&wake_up_dur, 1);
  *val = (uint8_t)wake_up_dur.sleep_dur;

  return ret;
}

/**
  * @}
  *
  */

/**
  * @defgroup    LSM6DS3_Tap_generator
  * @brief       This section groups all the functions that manage the
  *              tap and double tap event generation.
  * @{
  *
  */

/**
  * @brief   Read the tap_src status flag of the device.[get]
  *
  * @param  ctx         read / write interface definitions(ptr)
  * @param  val          Read the tap_src status flag of the device.
  * @retval             interface status (MANDATORY: return 0 -> no Error)
  *
  */
int32_t lsm6ds3_tap_src_get(stmdev_ctx_t *ctx, lsm6ds3_tap_src_t *val)
{
  int32_t ret;

  ret = lsm6ds3_read_reg(ctx, LSM6DS3_TAP_SRC, (uint8_t *)val, 1);

  return ret;
}

/**
  * @brief   Enable Z direction in tap recognition.[set]
  *
  * @param  ctx      read / write interface definitions(ptr)
  * @param  val      change the values of tap_z_en in reg TAP_CFG
  * @retval          interface status (MANDATORY: return 0 -> no Error)
  *
  */
int32_t lsm6ds3_tap_detection_on_z_set(stmdev_ctx_t *ctx, uint8_t val)
{
  lsm6ds3_tap_cfg_t tap_cfg;
  int32_t ret;

  ret = lsm6ds3_read_reg(ctx, LSM6DS3_TAP_CFG, (uint8_t *)&tap_cfg, 1);

  if (ret == 0)
  {
    tap_cfg.tap_z_en = (uint8_t)val;
    ret = lsm6ds3_write_reg(ctx, LSM6DS3_TAP_CFG, (uint8_t *)&tap_cfg, 1);
  }

  return ret;
}

/**
  * @brief   Enable Z direction in tap recognition.[get]
  *
  * @param  ctx      read / write interface definitions(ptr)
  * @param  val      get the values of tap_z_en in reg TAP_CFG
  * @retval          interface status (MANDATORY: return 0 -> no Error)
  *
  */
int32_t lsm6ds3_tap_detection_on_z_get(stmdev_ctx_t *ctx,
                                       uint8_t *val)
{
  lsm6ds3_tap_cfg_t tap_cfg;
  int32_t ret;

  ret = lsm6ds3_read_reg(ctx, LSM6DS3_TAP_CFG, (uint8_t *)&tap_cfg, 1);
  *val = (uint8_t)tap_cfg.tap_z_en;

  return ret;
}

/**
  * @brief   Enable Y direction in tap recognition.[set]
  *
  * @param  ctx      read / write interface definitions(ptr)
  * @param  val      change the values of tap_y_en in reg TAP_CFG
  * @retval          interface status (MANDATORY: return 0 -> no Error)
  *
  */
int32_t lsm6ds3_tap_detection_on_y_set(stmdev_ctx_t *ctx, uint8_t val)
{
  lsm6ds3_tap_cfg_t tap_cfg;
  int32_t ret;

  ret = lsm6ds3_read_reg(ctx, LSM6DS3_TAP_CFG, (uint8_t *)&tap_cfg, 1);

  if (ret == 0)
  {
    tap_cfg.tap_y_en = (uint8_t)val;
    ret = lsm6ds3_write_reg(ctx, LSM6DS3_TAP_CFG, (uint8_t *)&tap_cfg, 1);
  }

  return ret;
}

/**
  * @brief   Enable Y direction in tap recognition.[get]
  *
  * @param  ctx      read / write interface definitions(ptr)
  * @param  val      get the values of tap_y_en in reg TAP_CFG
  * @retval          interface status (MANDATORY: return 0 -> no Error)
  *
  */
int32_t lsm6ds3_tap_detection_on_y_get(stmdev_ctx_t *ctx,
                                       uint8_t *val)
{
  lsm6ds3_tap_cfg_t tap_cfg;
  int32_t ret;

  ret = lsm6ds3_read_reg(ctx, LSM6DS3_TAP_CFG, (uint8_t *)&tap_cfg, 1);
  *val = (uint8_t)tap_cfg.tap_y_en;

  return ret;
}

/**
  * @brief   Enable X direction in tap recognition.[set]
  *
  * @param  ctx      read / write interface definitions(ptr)
  * @param  val      change the values of tap_x_en in reg TAP_CFG
  * @retval          interface status (MANDATORY: return 0 -> no Error)
  *
  */
int32_t lsm6ds3_tap_detection_on_x_set(stmdev_ctx_t *ctx, uint8_t val)
{
  lsm6ds3_tap_cfg_t tap_cfg;
  int32_t ret;

  ret = lsm6ds3_read_reg(ctx, LSM6DS3_TAP_CFG, (uint8_t *)&tap_cfg, 1);

  if (ret == 0)
  {
    tap_cfg.tap_x_en = (uint8_t)val;
    ret = lsm6ds3_write_reg(ctx, LSM6DS3_TAP_CFG, (uint8_t *)&tap_cfg, 1);
  }

  return ret;
}

/**
  * @brief   Enable X direction in tap recognition.[get]
  *
  * @param  ctx      read / write interface definitions(ptr)
  * @param  val      get the values of tap_x_en in reg TAP_CFG
  * @retval          interface status (MANDATORY: return 0 -> no Error)
  *
  */
int32_t lsm6ds3_tap_detection_on_x_get(stmdev_ctx_t *ctx,
                                       uint8_t *val)
{
  lsm6ds3_tap_cfg_t tap_cfg;
  int32_t ret;

  ret = lsm6ds3_read_reg(ctx, LSM6DS3_TAP_CFG, (uint8_t *)&tap_cfg, 1);
  *val = (uint8_t)tap_cfg.tap_x_en;

  return ret;
}

/**
  * @brief   Threshold for tap recognition.[set]
  *
  * @param  ctx      read / write interface definitions(ptr)
  * @param  val      change the values of tap_ths in reg TAP_THS_6D
  * @retval          interface status (MANDATORY: return 0 -> no Error)
  *
  */
int32_t lsm6ds3_tap_threshold_set(stmdev_ctx_t *ctx, uint8_t val)
{
  lsm6ds3_tap_ths_6d_t tap_ths_6d;
  int32_t ret;

  ret = lsm6ds3_read_reg(ctx, LSM6DS3_TAP_THS_6D,
                         (uint8_t *)&tap_ths_6d, 1);

  if (ret == 0)
  {
    tap_ths_6d.tap_ths = (uint8_t)val;
    ret = lsm6ds3_write_reg(ctx, LSM6DS3_TAP_THS_6D,
                            (uint8_t *)&tap_ths_6d, 1);
  }

  return ret;
}

/**
  * @brief   Threshold for tap recognition.[get]
  *
  * @param  ctx      read / write interface definitions(ptr)
  * @param  val      get the values of tap_ths in reg TAP_THS_6D
  * @retval          interface status (MANDATORY: return 0 -> no Error)
  *
  */
int32_t lsm6ds3_tap_threshold_get(stmdev_ctx_t *ctx, uint8_t *val)
{
  lsm6ds3_tap_ths_6d_t tap_ths_6d;
  int32_t ret;

  ret = lsm6ds3_read_reg(ctx, LSM6DS3_TAP_THS_6D,
                         (uint8_t *)&tap_ths_6d, 1);
  *val = (uint8_t)tap_ths_6d.tap_ths;

  return ret;
}

/**
  * @brief   Maximum duration is the maximum time of an overthreshold signal
  *          detection to be recognized as a tap event. The default value
  *          of these bits is 00b which corresponds to 4*ODR_XL time.
  *          If the SHOCK[1:0] bits are set to a different value,
  *          1LSB corresponds to 8*ODR_XL time.[set]
  *
  * @param  ctx      read / write interface definitions(ptr)
  * @param  val      change the values of shock in reg INT_DUR2
  * @retval          interface status (MANDATORY: return 0 -> no Error)
  *
  */
int32_t lsm6ds3_tap_shock_set(stmdev_ctx_t *ctx, uint8_t val)
{
  lsm6ds3_int_dur2_t int_dur2;
  int32_t ret;

  ret = lsm6ds3_read_reg(ctx, LSM6DS3_INT_DUR2, (uint8_t *)&int_dur2, 1);

  if (ret == 0)
  {
    int_dur2.shock = (uint8_t)val;
    ret = lsm6ds3_write_reg(ctx, LSM6DS3_INT_DUR2, (uint8_t *)&int_dur2, 1);
  }

  return ret;
}

/**
  * @brief   Maximum duration is the maximum time of an overthreshold signal
  *          detection to be recognized as a tap event.
  *          The default value of these bits is 00b which corresponds
  *          to 4*ODR_XL time. If the SHOCK[1:0] bits are set to a different
  *          value, 1LSB corresponds to 8*ODR_XL time.[get]
  *
  * @param  ctx      read / write interface definitions(ptr)
  * @param  val      get the values of shock in reg INT_DUR2
  * @retval          interface status (MANDATORY: return 0 -> no Error)
  *
  */
int32_t lsm6ds3_tap_shock_get(stmdev_ctx_t *ctx, uint8_t *val)
{
  lsm6ds3_int_dur2_t int_dur2;
  int32_t ret;

  ret = lsm6ds3_read_reg(ctx, LSM6DS3_INT_DUR2, (uint8_t *)&int_dur2, 1);
  *val = (uint8_t)int_dur2.shock;

  return ret;
}

/**
  * @brief   Quiet time is the time after the first detected tap in
  *          which there must not be any over-threshold event.
  *          The default value of these bits is 00b which corresponds
  *          to 2*ODR_XL time. If the QUIET[1:0] bits are set to a
  *          different value, 1LSB corresponds to 4*ODR_XL time.[set]
  *
  * @param  ctx      read / write interface definitions(ptr)
  * @param  val      change the values of quiet in reg INT_DUR2
  * @retval          interface status (MANDATORY: return 0 -> no Error)
  *
  */
int32_t lsm6ds3_tap_quiet_set(stmdev_ctx_t *ctx, uint8_t val)
{
  lsm6ds3_int_dur2_t int_dur2;
  int32_t ret;

  ret = lsm6ds3_read_reg(ctx, LSM6DS3_INT_DUR2, (uint8_t *)&int_dur2, 1);

  if (ret == 0)
  {
    int_dur2.quiet = (uint8_t)val;
    ret = lsm6ds3_write_reg(ctx, LSM6DS3_INT_DUR2, (uint8_t *)&int_dur2, 1);
  }

  return ret;
}

/**
  * @brief   Quiet time is the time after the first detected tap in which
  *          there must not be any over-threshold event. The default value
  *          of these bits is 00b which corresponds to 2*ODR_XL time.
  *          If the QUIET[1:0] bits are set to a different value,
  *          1LSB corresponds to 4*ODR_XL time.[get]
  *
  * @param  ctx      read / write interface definitions(ptr)
  * @param  val      get the values of quiet in reg INT_DUR2
  * @retval          interface status (MANDATORY: return 0 -> no Error)
  *
  */
int32_t lsm6ds3_tap_quiet_get(stmdev_ctx_t *ctx, uint8_t *val)
{
  lsm6ds3_int_dur2_t int_dur2;
  int32_t ret;

  ret = lsm6ds3_read_reg(ctx, LSM6DS3_INT_DUR2, (uint8_t *)&int_dur2, 1);
  *val = (uint8_t)int_dur2.quiet;

  return ret;
}

/**
  * @brief   When double tap recognition is enabled, this register
  *          expresses the maximum time between two consecutive detected
  *          taps to determine a double tap event. The default value of
  *          these bits is 0000b which corresponds to 16*ODR_XL time.
  *          If the DUR[3:0] bits are set to a different value,
  *          1LSB corresponds to 32*ODR_XL time.[set]
  *
  * @param  ctx      read / write interface definitions(ptr)
  * @param  val      change the values of dur in reg INT_DUR2
  * @retval          interface status (MANDATORY: return 0 -> no Error)
  *
  */
int32_t lsm6ds3_tap_dur_set(stmdev_ctx_t *ctx, uint8_t val)
{
  lsm6ds3_int_dur2_t int_dur2;
  int32_t ret;

  ret = lsm6ds3_read_reg(ctx, LSM6DS3_INT_DUR2, (uint8_t *)&int_dur2, 1);

  if (ret == 0)
  {
    int_dur2.dur = (uint8_t)val;
    ret = lsm6ds3_write_reg(ctx, LSM6DS3_INT_DUR2, (uint8_t *)&int_dur2, 1);
  }

  return ret;
}

/**
  * @brief   When double tap recognition is enabled, this register
  *          expresses the maximum time between two consecutive detected
  *          taps to determine a double tap event.
  *          The default value of these bits is 0000b which corresponds
  *          to 16*ODR_XL time. If the DUR[3:0] bits are set to a
  *          different value, 1LSB corresponds to 32*ODR_XL time.[get]
  *
  * @param  ctx      read / write interface definitions(ptr)
  * @param  val      get the values of dur in reg INT_DUR2
  * @retval          interface status (MANDATORY: return 0 -> no Error)
  *
  */
int32_t lsm6ds3_tap_dur_get(stmdev_ctx_t *ctx, uint8_t *val)
{
  lsm6ds3_int_dur2_t int_dur2;
  int32_t ret;

  ret = lsm6ds3_read_reg(ctx, LSM6DS3_INT_DUR2, (uint8_t *)&int_dur2, 1);
  *val = (uint8_t)int_dur2.dur;

  return ret;
}

/**
  * @brief   Single/double-tap event enable.[set]
  *
  * @param  ctx      read / write interface definitions(ptr)
  * @param  val      change the values of single_double_tap in reg  LSM6DS3
  * @retval          interface status (MANDATORY: return 0 -> no Error)
  *
  */
int32_t lsm6ds3_tap_mode_set(stmdev_ctx_t *ctx, lsm6ds3_tap_md_t val)
{
  lsm6ds3_wake_up_ths_t wake_up_ths;
  int32_t ret;

  ret = lsm6ds3_read_reg(ctx, LSM6DS3_WAKE_UP_THS,
                         (uint8_t *)&wake_up_ths, 1);

  if (ret == 0)
  {
    wake_up_ths.single_double_tap = (uint8_t)val;
    ret = lsm6ds3_write_reg(ctx, LSM6DS3_WAKE_UP_THS,
                            (uint8_t *)&wake_up_ths, 1);
  }

  return ret;
}

/**
  * @brief   Single/double-tap event enable.[get]
  *
  * @param  ctx         read / write interface definitions(ptr)
  * @param  val         get the values of single_double_tap in reg WAKE_UP_THS
  * @retval          interface status (MANDATORY: return 0 -> no Error)
  *
  */
int32_t lsm6ds3_tap_mode_get(stmdev_ctx_t *ctx, lsm6ds3_tap_md_t *val)
{
  lsm6ds3_wake_up_ths_t wake_up_ths;
  int32_t ret;

  ret = lsm6ds3_read_reg(ctx, LSM6DS3_WAKE_UP_THS,
                         (uint8_t *)&wake_up_ths, 1);

  switch (wake_up_ths.single_double_tap)
  {
    case LSM6DS3_ONLY_DOUBLE:
      *val = LSM6DS3_ONLY_DOUBLE;
      break;

    case LSM6DS3_SINGLE_DOUBLE:
      *val = LSM6DS3_SINGLE_DOUBLE;
      break;

    default:
      *val = LSM6DS3_ONLY_DOUBLE;
      break;
  }

  return ret;
}

/**
  * @}
  *
  */

/**
  * @defgroup    LSM6DS3_Six_position_detection(6D/4D)
  * @brief       This section groups all the functions concerning
  *              six position detection (6D).
  * @{
  *
  */

/**
  * @brief   LPF2 feed 6D function selection.[set]
  *
  * @param  ctx      read / write interface definitions(ptr)
  * @param  val      change the values of low_pass_on_6d in reg  LSM6DS3
  * @retval          interface status (MANDATORY: return 0 -> no Error)
  *
  */
int32_t lsm6ds3_6d_feed_data_set(stmdev_ctx_t *ctx,
                                 lsm6ds3_low_pass_on_6d_t val)
{
  lsm6ds3_ctrl8_xl_t ctrl8_xl;
  int32_t ret;

  ret = lsm6ds3_read_reg(ctx, LSM6DS3_CTRL8_XL, (uint8_t *)&ctrl8_xl, 1);

  if (ret == 0)
  {
    ctrl8_xl.low_pass_on_6d = (uint8_t)val;
    ret = lsm6ds3_write_reg(ctx, LSM6DS3_CTRL8_XL, (uint8_t *)&ctrl8_xl, 1);
  }

  return ret;
}

/**
  * @brief   LPF2 feed 6D function selection.[get]
  *
  * @param  ctx         read / write interface definitions(ptr)
  * @param  val         get the values of low_pass_on_6d in reg CTRL8_XL
  * @retval          interface status (MANDATORY: return 0 -> no Error)
  *
  */
int32_t lsm6ds3_6d_feed_data_get(stmdev_ctx_t *ctx,
                                 lsm6ds3_low_pass_on_6d_t *val)
{
  lsm6ds3_ctrl8_xl_t ctrl8_xl;
  int32_t ret;

  ret = lsm6ds3_read_reg(ctx, LSM6DS3_CTRL8_XL, (uint8_t *)&ctrl8_xl, 1);

  switch (ctrl8_xl.low_pass_on_6d)
  {
    case LSM6DS3_ODR_DIV_2_FEED:
      *val = LSM6DS3_ODR_DIV_2_FEED;
      break;

    case LSM6DS3_LPF2_FEED:
      *val = LSM6DS3_LPF2_FEED;
      break;

    default:
      *val = LSM6DS3_ODR_DIV_2_FEED;
      break;
  }

  return ret;
}

/**
  * @brief   Read the d6d_src status flag of the device.[get]
  *
  * @param  ctx         read / write interface definitions(ptr)
  * @param  val          Read the d6d_src status flag of the device.
  * @retval          interface status (MANDATORY: return 0 -> no Error)
  *
  */
int32_t lsm6ds3_6d_src_get(stmdev_ctx_t *ctx, lsm6ds3_d6d_src_t *val)
{
  int32_t ret;

  ret = lsm6ds3_read_reg(ctx, LSM6DS3_D6D_SRC, (uint8_t *)val, 1);

  return ret;
}

/**
  * @brief   Threshold for 4D/6D function.[set]
  *
  * @param  ctx      read / write interface definitions(ptr)
  * @param  val      change the values of sixd_ths in reg  LSM6DS3
  * @retval          interface status (MANDATORY: return 0 -> no Error)
  *
  */
int32_t lsm6ds3_6d_threshold_set(stmdev_ctx_t *ctx,
                                 lsm6ds3_sixd_ths_t val)
{
  lsm6ds3_tap_ths_6d_t tap_ths_6d;
  int32_t ret;

  ret = lsm6ds3_read_reg(ctx, LSM6DS3_TAP_THS_6D,
                         (uint8_t *)&tap_ths_6d, 1);

  if (ret == 0)
  {
    tap_ths_6d.sixd_ths = (uint8_t)val;
    ret = lsm6ds3_write_reg(ctx, LSM6DS3_TAP_THS_6D,
                            (uint8_t *)&tap_ths_6d, 1);
  }

  return ret;
}

/**
  * @brief   Threshold for 4D/6D function.[get]
  *
  * @param  ctx         read / write interface definitions(ptr)
  * @param  val         get the values of sixd_ths in reg TAP_THS_6D
  * @retval          interface status (MANDATORY: return 0 -> no Error)
  *
  */
int32_t lsm6ds3_6d_threshold_get(stmdev_ctx_t *ctx,
                                 lsm6ds3_sixd_ths_t *val)
{
  lsm6ds3_tap_ths_6d_t tap_ths_6d;
  int32_t ret;

  ret = lsm6ds3_read_reg(ctx, LSM6DS3_TAP_THS_6D,
                         (uint8_t *)&tap_ths_6d, 1);

  switch (tap_ths_6d.sixd_ths)
  {
    case LSM6DS3_DEG_80:
      *val = LSM6DS3_DEG_80;
      break;

    case LSM6DS3_DEG_70:
      *val = LSM6DS3_DEG_70;
      break;

    case LSM6DS3_DEG_60:
      *val = LSM6DS3_DEG_60;
      break;

    case LSM6DS3_DEG_50:
      *val = LSM6DS3_DEG_50;
      break;

    default:
      *val = LSM6DS3_DEG_80;
      break;
  }

  return ret;
}

/**
  * @brief   4D orientation detection enable.[set]
  *
  * @param  ctx      read / write interface definitions(ptr)
  * @param  val      change the values of d4d_en in reg TAP_THS_6D
  * @retval          interface status (MANDATORY: return 0 -> no Error)
  *
  */
int32_t lsm6ds3_4d_mode_set(stmdev_ctx_t *ctx, uint8_t val)
{
  lsm6ds3_tap_ths_6d_t tap_ths_6d;
  int32_t ret;

  ret = lsm6ds3_read_reg(ctx, LSM6DS3_TAP_THS_6D,
                         (uint8_t *)&tap_ths_6d, 1);

  if (ret == 0)
  {
    tap_ths_6d.d4d_en = (uint8_t)val;
    ret = lsm6ds3_write_reg(ctx, LSM6DS3_TAP_THS_6D,
                            (uint8_t *)&tap_ths_6d, 1);
  }

  return ret;
}

/**
  * @brief   4D orientation detection enable.[get]
  *
  * @param  ctx      read / write interface definitions(ptr)
  * @param  val      get the values of d4d_en in reg TAP_THS_6D
  * @retval          interface status (MANDATORY: return 0 -> no Error)
  *
  */
int32_t lsm6ds3_4d_mode_get(stmdev_ctx_t *ctx, uint8_t *val)
{
  lsm6ds3_tap_ths_6d_t tap_ths_6d;
  int32_t ret;

  ret = lsm6ds3_read_reg(ctx, LSM6DS3_TAP_THS_6D,
                         (uint8_t *)&tap_ths_6d, 1);
  *val = (uint8_t)tap_ths_6d.d4d_en;

  return ret;
}

/**
  * @}
  *
  */

/**
  * @defgroup    LSM6DS3_Free_fall
  * @brief       This section group all the functions concerning the
  *              free fall detection.
  * @{
  *
  */

/**
  * @brief   Free fall threshold setting.[set]
  *
  * @param  ctx      read / write interface definitions(ptr)
  * @param  val      change the values of ff_ths in reg  LSM6DS3
  * @retval          interface status (MANDATORY: return 0 -> no Error)
  *
  */
int32_t lsm6ds3_ff_threshold_set(stmdev_ctx_t *ctx,
                                 lsm6ds3_ff_ths_t val)
{
  lsm6ds3_free_fall_t free_fall;
  int32_t ret;

  ret = lsm6ds3_read_reg(ctx, LSM6DS3_FREE_FALL, (uint8_t *)&free_fall, 1);

  if (ret == 0)
  {
    free_fall.ff_ths = (uint8_t)val;
    ret = lsm6ds3_write_reg(ctx, LSM6DS3_FREE_FALL, (uint8_t *)&free_fall, 1);
  }

  return ret;
}

/**
  * @brief   Free fall threshold setting.[get]
  *
  * @param  ctx         read / write interface definitions(ptr)
  * @param  val         get the values of ff_ths in reg FREE_FALL
  * @retval          interface status (MANDATORY: return 0 -> no Error)
  *
  */
int32_t lsm6ds3_ff_threshold_get(stmdev_ctx_t *ctx,
                                 lsm6ds3_ff_ths_t *val)
{
  lsm6ds3_free_fall_t free_fall;
  int32_t ret;

  ret = lsm6ds3_read_reg(ctx, LSM6DS3_FREE_FALL, (uint8_t *)&free_fall, 1);

  switch (free_fall.ff_ths)
  {
    case LSM6DS3_156_mg:
      *val = LSM6DS3_156_mg;
      break;

    case LSM6DS3_219_mg:
      *val = LSM6DS3_219_mg;
      break;

    case LSM6DS3_250_mg:
      *val = LSM6DS3_250_mg;
      break;

    case LSM6DS3_312_mg:
      *val = LSM6DS3_312_mg;
      break;

    case LSM6DS3_344_mg:
      *val = LSM6DS3_344_mg;
      break;

    case LSM6DS3_406_mg:
      *val = LSM6DS3_406_mg;
      break;

    case LSM6DS3_469_mg:
      *val = LSM6DS3_469_mg;
      break;

    case LSM6DS3_500_mg:
      *val = LSM6DS3_500_mg;
      break;

    default:
      *val = LSM6DS3_156_mg;
      break;
  }

  return ret;
}

/**
  * @brief   Free-fall duration event. 1LSb = 1 / ODR[set]
  *
  * @param  ctx      read / write interface definitions(ptr)
  * @param  val      change the values of ff_dur in reg FREE_FALL
  * @retval          interface status (MANDATORY: return 0 -> no Error)
  *
  */
int32_t lsm6ds3_ff_dur_set(stmdev_ctx_t *ctx, uint8_t val)
{
  lsm6ds3_free_fall_t free_fall;
  int32_t ret;

  ret = lsm6ds3_read_reg(ctx, LSM6DS3_FREE_FALL, (uint8_t *)&free_fall, 1);

  if (ret == 0)
  {
    free_fall.ff_dur = (uint8_t)val;
    ret = lsm6ds3_write_reg(ctx, LSM6DS3_FREE_FALL, (uint8_t *)&free_fall, 1);
  }

  return ret;
}

/**
  * @brief   Free-fall duration event. 1LSb = 1 / ODR[get]
  *
  * @param  ctx      read / write interface definitions(ptr)
  * @param  val      get the values of ff_dur in reg FREE_FALL
  * @retval          interface status (MANDATORY: return 0 -> no Error)
  *
  */
int32_t lsm6ds3_ff_dur_get(stmdev_ctx_t *ctx, uint8_t *val)
{
  lsm6ds3_free_fall_t free_fall;
  int32_t ret;

  ret = lsm6ds3_read_reg(ctx, LSM6DS3_FREE_FALL, (uint8_t *)&free_fall, 1);
  *val = (uint8_t)free_fall.ff_dur;

  return ret;
}

/**
  * @}
  *
  */

/**
  * @defgroup    LSM6DS3_Fifo
  * @brief       This section group all the functions concerning the
  *              fifo usage
  * @{
  *
  */

/**
  * @brief   FIFO watermark level selection.[set]
  *
  * @param  ctx      read / write interface definitions(ptr)
  * @param  val      change the values of fth in reg FIFO_CTRL1
  * @retval          interface status (MANDATORY: return 0 -> no Error)
  *
  */
int32_t lsm6ds3_fifo_watermark_set(stmdev_ctx_t *ctx, uint16_t val)
{
  lsm6ds3_fifo_ctrl1_t fifo_ctrl1;
  lsm6ds3_fifo_ctrl2_t fifo_ctrl2;
  int32_t ret;

  ret = lsm6ds3_read_reg(ctx, LSM6DS3_FIFO_CTRL1,
                         (uint8_t *)&fifo_ctrl1, 1);

  if (ret == 0)
  {
    ret = lsm6ds3_read_reg(ctx, LSM6DS3_FIFO_CTRL2,
                           (uint8_t *)&fifo_ctrl2, 1);
  }

  if (ret == 0)
  {
    fifo_ctrl2.fth = (uint8_t)((val & 0x0F00U) >> 8);
    ret = lsm6ds3_write_reg(ctx, LSM6DS3_FIFO_CTRL2,
                            (uint8_t *)&fifo_ctrl2, 1);
  }

  if (ret == 0)
  {
    fifo_ctrl1.fth = (uint8_t)(val & 0x00FF0U);
    ret = lsm6ds3_write_reg(ctx, LSM6DS3_FIFO_CTRL1,
                            (uint8_t *)&fifo_ctrl1, 1);
  }

  return ret;
}

/**
  * @brief   FIFO watermark level selection.[get]
  *
  * @param  ctx      read / write interface definitions(ptr)
  * @param  val      get the values of fth in reg FIFO_CTRL1
  * @retval          interface status (MANDATORY: return 0 -> no Error)
  *
  */
int32_t lsm6ds3_fifo_watermark_get(stmdev_ctx_t *ctx, uint16_t *val)
{
  lsm6ds3_fifo_ctrl1_t fifo_ctrl1;
  lsm6ds3_fifo_ctrl2_t fifo_ctrl2;
  int32_t ret;

  ret = lsm6ds3_read_reg(ctx, LSM6DS3_FIFO_CTRL1,
                         (uint8_t *)&fifo_ctrl1, 1);

  if (ret == 0)
  {
    ret = lsm6ds3_read_reg(ctx, LSM6DS3_FIFO_CTRL2,
                           (uint8_t *)&fifo_ctrl2, 1);
    *val = (uint16_t)fifo_ctrl2.fth << 8;
    *val |= fifo_ctrl1.fth;
  }

  return ret;
}

/**
  * @brief   trigger signal for FIFO write operation.[set]
  *
  * @param  ctx      read / write interface definitions(ptr)
  * @param  val      change the values of  timer_pedo_fifo_drdy in reg LSM6DS3
  * @retval          interface status (MANDATORY: return 0 -> no Error)
  *
  */
int32_t lsm6ds3_fifo_write_trigger_set(stmdev_ctx_t *ctx,
                                       lsm6ds3_tmr_ped_fifo_drdy_t val)
{
  lsm6ds3_fifo_ctrl2_t fifo_ctrl2;
  int32_t ret;

  ret = lsm6ds3_read_reg(ctx, LSM6DS3_FIFO_CTRL2,
                         (uint8_t *)&fifo_ctrl2, 1);

  if (ret == 0)
  {
    fifo_ctrl2. timer_pedo_fifo_drdy = (uint8_t)val;
    ret = lsm6ds3_write_reg(ctx, LSM6DS3_FIFO_CTRL2,
                            (uint8_t *)&fifo_ctrl2, 1);
  }

  return ret;
}

/**
  * @brief   trigger signal for FIFO write operation.[get]
  *
  * @param  ctx         read / write interface definitions(ptr)
  * @param  val         get the values of  timer_pedo_fifo_drdy in
  *                     reg FIFO_CTRL2
  * @retval          interface status (MANDATORY: return 0 -> no Error)
  *
  */
int32_t lsm6ds3_fifo_write_trigger_get(stmdev_ctx_t *ctx,
                                       lsm6ds3_tmr_ped_fifo_drdy_t *val)
{
  lsm6ds3_fifo_ctrl2_t fifo_ctrl2;
  int32_t ret;

  ret = lsm6ds3_read_reg(ctx, LSM6DS3_FIFO_CTRL2,
                         (uint8_t *)&fifo_ctrl2, 1);

  switch (fifo_ctrl2. timer_pedo_fifo_drdy)
  {
    case LSM6DS3_TRG_XL_GY_DRDY:
      *val = LSM6DS3_TRG_XL_GY_DRDY;
      break;

    case LSM6DS3_TRG_STEP_DETECT:
      *val = LSM6DS3_TRG_STEP_DETECT;
      break;

    default:
      *val = LSM6DS3_TRG_XL_GY_DRDY;
      break;
  }

  return ret;
}

/**
  * @brief   Pedometer step counter and timestamp as 4th FIFO data set.[set]
  *
  * @param  ctx      read / write interface definitions(ptr)
  * @param  val      change the values of timer_pedo_fifo_en in reg FIFO_CTRL2
  * @retval          interface status (MANDATORY: return 0 -> no Error)
  *
  */
int32_t lsm6ds3_fifo_pedo_batch_set(stmdev_ctx_t *ctx, uint8_t val)
{
  lsm6ds3_fifo_ctrl2_t fifo_ctrl2;
  int32_t ret;

  ret = lsm6ds3_read_reg(ctx, LSM6DS3_FIFO_CTRL2,
                         (uint8_t *)&fifo_ctrl2, 1);

  if (ret == 0)
  {
    fifo_ctrl2.timer_pedo_fifo_en = (uint8_t)val;
    ret = lsm6ds3_write_reg(ctx, LSM6DS3_FIFO_CTRL2,
                            (uint8_t *)&fifo_ctrl2, 1);
  }

  return ret;
}

/**
  * @brief   Pedometer step counter and timestamp as 4th FIFO data set.[get]
  *
  * @param  ctx      read / write interface definitions(ptr)
  * @param  val      get the values of timer_pedo_fifo_en in reg FIFO_CTRL2
  * @retval          interface status (MANDATORY: return 0 -> no Error)
  *
  */
int32_t lsm6ds3_fifo_pedo_batch_get(stmdev_ctx_t *ctx, uint8_t *val)
{
  lsm6ds3_fifo_ctrl2_t fifo_ctrl2;
  int32_t ret;

  ret = lsm6ds3_read_reg(ctx, LSM6DS3_FIFO_CTRL2,
                         (uint8_t *)&fifo_ctrl2, 1);
  *val = (uint8_t)fifo_ctrl2.timer_pedo_fifo_en;

  return ret;
}

/**
  * @brief   Selects Batching Data Rate (writing frequency in FIFO) for
  *          accelerometer data.[set]
  *
  * @param  ctx      read / write interface definitions(ptr)
  * @param  val      change the values of dec_fifo_xl in reg  LSM6DS3
  * @retval          interface status (MANDATORY: return 0 -> no Error)
  *
  */
int32_t lsm6ds3_fifo_xl_batch_set(stmdev_ctx_t *ctx,
                                  lsm6ds3_dec_fifo_xl_t val)
{
  lsm6ds3_fifo_ctrl3_t fifo_ctrl3;
  int32_t ret;

  ret = lsm6ds3_read_reg(ctx, LSM6DS3_FIFO_CTRL3,
                         (uint8_t *)&fifo_ctrl3, 1);

  if (ret == 0)
  {
    fifo_ctrl3.dec_fifo_xl = (uint8_t)val;
    ret = lsm6ds3_write_reg(ctx, LSM6DS3_FIFO_CTRL3,
                            (uint8_t *)&fifo_ctrl3, 1);
  }

  return ret;
}

/**
  * @brief   Selects Batching Data Rate (writing frequency in FIFO) for
  *          accelerometer data.[get]
  *
  * @param  ctx         read / write interface definitions(ptr)
  * @param  val         get the values of dec_fifo_xl in reg FIFO_CTRL3
  * @retval          interface status (MANDATORY: return 0 -> no Error)
  *
  */
int32_t lsm6ds3_fifo_xl_batch_get(stmdev_ctx_t *ctx,
                                  lsm6ds3_dec_fifo_xl_t *val)
{
  lsm6ds3_fifo_ctrl3_t fifo_ctrl3;
  int32_t ret;

  ret = lsm6ds3_read_reg(ctx, LSM6DS3_FIFO_CTRL3,
                         (uint8_t *)&fifo_ctrl3, 1);

  switch (fifo_ctrl3.dec_fifo_xl)
  {
    case LSM6DS3_FIFO_XL_DISABLE:
      *val = LSM6DS3_FIFO_XL_DISABLE;
      break;

    case LSM6DS3_FIFO_XL_NO_DEC:
      *val = LSM6DS3_FIFO_XL_NO_DEC;
      break;

    case LSM6DS3_FIFO_XL_DEC_2:
      *val = LSM6DS3_FIFO_XL_DEC_2;
      break;

    case LSM6DS3_FIFO_XL_DEC_3:
      *val = LSM6DS3_FIFO_XL_DEC_3;
      break;

    case LSM6DS3_FIFO_XL_DEC_4:
      *val = LSM6DS3_FIFO_XL_DEC_4;
      break;

    case LSM6DS3_FIFO_XL_DEC_8:
      *val = LSM6DS3_FIFO_XL_DEC_8;
      break;

    case LSM6DS3_FIFO_XL_DEC_16:
      *val = LSM6DS3_FIFO_XL_DEC_16;
      break;

    case LSM6DS3_FIFO_XL_DEC_32:
      *val = LSM6DS3_FIFO_XL_DEC_32;
      break;

    default:
      *val = LSM6DS3_FIFO_XL_DISABLE;
      break;
  }

  return ret;
}

/**
  * @brief   Selects Batching Data Rate (writing frequency in FIFO)
  *          for gyroscope data.[set]
  *
  * @param  ctx      read / write interface definitions(ptr)
  * @param  val      change the values of dec_fifo_gyro in reg  LSM6DS3
  * @retval          interface status (MANDATORY: return 0 -> no Error)
  *
  */
int32_t lsm6ds3_fifo_gy_batch_set(stmdev_ctx_t *ctx,
                                  lsm6ds3_dec_fifo_gyro_t val)
{
  lsm6ds3_fifo_ctrl3_t fifo_ctrl3;
  int32_t ret;

  ret = lsm6ds3_read_reg(ctx, LSM6DS3_FIFO_CTRL3,
                         (uint8_t *)&fifo_ctrl3, 1);

  if (ret == 0)
  {
    fifo_ctrl3.dec_fifo_gyro = (uint8_t)val;
    ret = lsm6ds3_write_reg(ctx, LSM6DS3_FIFO_CTRL3,
                            (uint8_t *)&fifo_ctrl3, 1);
  }

  return ret;
}

/**
  * @brief   Selects Batching Data Rate (writing frequency in FIFO)
  *          for gyroscope data.[get]
  *
  * @param  ctx         read / write interface definitions(ptr)
  * @param  val         get the values of dec_fifo_gyro in reg FIFO_CTRL3
  * @retval          interface status (MANDATORY: return 0 -> no Error)
  *
  */
int32_t lsm6ds3_fifo_gy_batch_get(stmdev_ctx_t *ctx,
                                  lsm6ds3_dec_fifo_gyro_t *val)
{
  lsm6ds3_fifo_ctrl3_t fifo_ctrl3;
  int32_t ret;

  ret = lsm6ds3_read_reg(ctx, LSM6DS3_FIFO_CTRL3,
                         (uint8_t *)&fifo_ctrl3, 1);

  switch (fifo_ctrl3.dec_fifo_gyro)
  {
    case LSM6DS3_FIFO_GY_DISABLE:
      *val = LSM6DS3_FIFO_GY_DISABLE;
      break;

    case LSM6DS3_FIFO_GY_NO_DEC:
      *val = LSM6DS3_FIFO_GY_NO_DEC;
      break;

    case LSM6DS3_FIFO_GY_DEC_2:
      *val = LSM6DS3_FIFO_GY_DEC_2;
      break;

    case LSM6DS3_FIFO_GY_DEC_3:
      *val = LSM6DS3_FIFO_GY_DEC_3;
      break;

    case LSM6DS3_FIFO_GY_DEC_4:
      *val = LSM6DS3_FIFO_GY_DEC_4;
      break;

    case LSM6DS3_FIFO_GY_DEC_8:
      *val = LSM6DS3_FIFO_GY_DEC_8;
      break;

    case LSM6DS3_FIFO_GY_DEC_16:
      *val = LSM6DS3_FIFO_GY_DEC_16;
      break;

    case LSM6DS3_FIFO_GY_DEC_32:
      *val = LSM6DS3_FIFO_GY_DEC_32;
      break;

    default:
      *val = LSM6DS3_FIFO_GY_DISABLE;
      break;
  }

  return ret;
}

/**
  * @brief   Selects Batching Data Rate (writing frequency in FIFO)
  *          for third data set.[set]
  *
  * @param  ctx      read / write interface definitions(ptr)
  * @param  val      change the values of dec_ds3_fifo in reg  LSM6DS3
  * @retval          interface status (MANDATORY: return 0 -> no Error)
  *
  */
int32_t lsm6ds3_fifo_dataset_3_batch_set(stmdev_ctx_t *ctx,
                                         lsm6ds3_dec_ds3_fifo_t val)
{
  lsm6ds3_fifo_ctrl4_t fifo_ctrl4;
  int32_t ret;

  ret = lsm6ds3_read_reg(ctx, LSM6DS3_FIFO_CTRL4,
                         (uint8_t *)&fifo_ctrl4, 1);

  if (ret == 0)
  {
    fifo_ctrl4.dec_ds3_fifo = (uint8_t)val;
    ret = lsm6ds3_write_reg(ctx, LSM6DS3_FIFO_CTRL4,
                            (uint8_t *)&fifo_ctrl4, 1);
  }

  return ret;
}

/**
  * @brief   Selects Batching Data Rate (writing frequency in FIFO)
  *          for third data set.[get]
  *
  * @param  ctx         read / write interface definitions(ptr)
  * @param  val         get the values of dec_ds3_fifo in reg FIFO_CTRL4
  * @retval          interface status (MANDATORY: return 0 -> no Error)
  *
  */
int32_t lsm6ds3_fifo_dataset_3_batch_get(stmdev_ctx_t *ctx,
                                         lsm6ds3_dec_ds3_fifo_t *val)
{
  lsm6ds3_fifo_ctrl4_t fifo_ctrl4;
  int32_t ret;

  ret = lsm6ds3_read_reg(ctx, LSM6DS3_FIFO_CTRL4,
                         (uint8_t *)&fifo_ctrl4, 1);

  switch (fifo_ctrl4.dec_ds3_fifo)
  {
    case LSM6DS3_FIFO_DS3_DISABLE:
      *val = LSM6DS3_FIFO_DS3_DISABLE;
      break;

    case LSM6DS3_FIFO_DS3_NO_DEC:
      *val = LSM6DS3_FIFO_DS3_NO_DEC;
      break;

    case LSM6DS3_FIFO_DS3_DEC_2:
      *val = LSM6DS3_FIFO_DS3_DEC_2;
      break;

    case LSM6DS3_FIFO_DS3_DEC_3:
      *val = LSM6DS3_FIFO_DS3_DEC_3;
      break;

    case LSM6DS3_FIFO_DS3_DEC_4:
      *val = LSM6DS3_FIFO_DS3_DEC_4;
      break;

    case LSM6DS3_FIFO_DS3_DEC_8:
      *val = LSM6DS3_FIFO_DS3_DEC_8;
      break;

    case LSM6DS3_FIFO_DS3_DEC_16:
      *val = LSM6DS3_FIFO_DS3_DEC_16;
      break;

    case LSM6DS3_FIFO_DS3_DEC_32:
      *val = LSM6DS3_FIFO_DS3_DEC_32;
      break;

    default:
      *val = LSM6DS3_FIFO_DS3_DISABLE;
      break;
  }

  return ret;
}

/**
  * @brief   Selects Batching Data Rate (writing frequency in FIFO)
  *          for fourth data set.[set]
  *
  * @param  ctx      read / write interface definitions(ptr)
  * @param  val      change the values of dec_ds4_fifo in reg  LSM6DS3
  * @retval          interface status (MANDATORY: return 0 -> no Error)
  *
  */
int32_t lsm6ds3_fifo_dataset_4_batch_set(stmdev_ctx_t *ctx,
                                         lsm6ds3_dec_ds4_fifo_t val)
{
  lsm6ds3_fifo_ctrl4_t fifo_ctrl4;
  int32_t ret;

  ret = lsm6ds3_read_reg(ctx, LSM6DS3_FIFO_CTRL4,
                         (uint8_t *)&fifo_ctrl4, 1);

  if (ret == 0)
  {
    fifo_ctrl4.dec_ds4_fifo = (uint8_t)val;
    ret = lsm6ds3_write_reg(ctx, LSM6DS3_FIFO_CTRL4,
                            (uint8_t *)&fifo_ctrl4, 1);
  }

  return ret;
}

/**
  * @brief   Selects Batching Data Rate (writing frequency in FIFO)
  *          for fourth data set.[get]
  *
  * @param  ctx         read / write interface definitions(ptr)
  * @param  val         get the values of dec_ds4_fifo in reg FIFO_CTRL4
  * @retval          interface status (MANDATORY: return 0 -> no Error)
  *
  */
int32_t lsm6ds3_fifo_dataset_4_batch_get(stmdev_ctx_t *ctx,
                                         lsm6ds3_dec_ds4_fifo_t *val)
{
  lsm6ds3_fifo_ctrl4_t fifo_ctrl4;
  int32_t ret;

  ret = lsm6ds3_read_reg(ctx, LSM6DS3_FIFO_CTRL4,
                         (uint8_t *)&fifo_ctrl4, 1);

  switch (fifo_ctrl4.dec_ds4_fifo)
  {
    case LSM6DS3_FIFO_DS4_DISABLE:
      *val = LSM6DS3_FIFO_DS4_DISABLE;
      break;

    case LSM6DS3_FIFO_DS4_NO_DEC:
      *val = LSM6DS3_FIFO_DS4_NO_DEC;
      break;

    case LSM6DS3_FIFO_DS4_DEC_2:
      *val = LSM6DS3_FIFO_DS4_DEC_2;
      break;

    case LSM6DS3_FIFO_DS4_DEC_3:
      *val = LSM6DS3_FIFO_DS4_DEC_3;
      break;

    case LSM6DS3_FIFO_DS4_DEC_4:
      *val = LSM6DS3_FIFO_DS4_DEC_4;
      break;

    case LSM6DS3_FIFO_DS4_DEC_8:
      *val = LSM6DS3_FIFO_DS4_DEC_8;
      break;

    case LSM6DS3_FIFO_DS4_DEC_16:
      *val = LSM6DS3_FIFO_DS4_DEC_16;
      break;

    case LSM6DS3_FIFO_DS4_DEC_32:
      *val = LSM6DS3_FIFO_DS4_DEC_32;
      break;

    default:
      *val = LSM6DS3_FIFO_DS4_DISABLE;
      break;
  }

  return ret;
}

/**
  * @brief   8-bit data storage in FIFO.[set]
  *
  * @param  ctx      read / write interface definitions(ptr)
  * @param  val      change the values of only_high_data in reg FIFO_CTRL4
  * @retval          interface status (MANDATORY: return 0 -> no Error)
  *
  */
int32_t lsm6ds3_fifo_xl_gy_8bit_format_set(stmdev_ctx_t *ctx,
                                           uint8_t val)
{
  lsm6ds3_fifo_ctrl4_t fifo_ctrl4;
  int32_t ret;

  ret = lsm6ds3_read_reg(ctx, LSM6DS3_FIFO_CTRL4,
                         (uint8_t *)&fifo_ctrl4, 1);

  if (ret == 0)
  {
    fifo_ctrl4.only_high_data = (uint8_t)val;
    ret = lsm6ds3_write_reg(ctx, LSM6DS3_FIFO_CTRL4,
                            (uint8_t *)&fifo_ctrl4, 1);
  }

  return ret;
}

/**
  * @brief   8-bit data storage in FIFO.[get]
  *
  * @param  ctx      read / write interface definitions(ptr)
  * @param  val      get the values of only_high_data in reg FIFO_CTRL4
  * @retval          interface status (MANDATORY: return 0 -> no Error)
  *
  */
int32_t lsm6ds3_fifo_xl_gy_8bit_format_get(stmdev_ctx_t *ctx,
                                           uint8_t *val)
{
  lsm6ds3_fifo_ctrl4_t fifo_ctrl4;
  int32_t ret;

  ret = lsm6ds3_read_reg(ctx, LSM6DS3_FIFO_CTRL4,
                         (uint8_t *)&fifo_ctrl4, 1);
  *val = (uint8_t)fifo_ctrl4.only_high_data;

  return ret;
}

/**
  * @brief   FIFO mode selection.[set]
  *
  * @param  ctx      read / write interface definitions(ptr)
  * @param  val      change the values of fifo_mode in reg  LSM6DS3
  * @retval          interface status (MANDATORY: return 0 -> no Error)
  *
  */
int32_t lsm6ds3_fifo_mode_set(stmdev_ctx_t *ctx,
                              lsm6ds3_fifo_md_t val)
{
  lsm6ds3_fifo_ctrl5_t fifo_ctrl5;
  int32_t ret;

  ret = lsm6ds3_read_reg(ctx, LSM6DS3_FIFO_CTRL5,
                         (uint8_t *)&fifo_ctrl5, 1);

  if (ret == 0)
  {
    fifo_ctrl5.fifo_mode = (uint8_t)val;
    ret = lsm6ds3_write_reg(ctx, LSM6DS3_FIFO_CTRL5,
                            (uint8_t *)&fifo_ctrl5, 1);
  }

  return ret;
}
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
