cansat-tsniimash/UNKNOWN-2024/lib-tsniimash/stm32f4/LIS3MDL/src/lis3mdl_reg.c

/**
  ******************************************************************************
  * @file    lis3mdl_reg.c
  * @author  Sensors Software Solution Team
  * @brief   LIS3MDL driver file
  ******************************************************************************
  * @attention
  *
  * <h2><center>&copy; Copyright (c) 2021 STMicroelectronics.
  * All rights reserved.</center></h2>
  *
  * This software component is licensed by ST under BSD 3-Clause license,
  * the "License"; You may not use this file except in compliance with the
  * License. You may obtain a copy of the License at:
  *                        opensource.org/licenses/BSD-3-Clause
  *
  ******************************************************************************
  */

#include "..\lis3mdl_reg.h"

/**
  * @defgroup    LIS3MDL
  * @brief       This file provides a set of functions needed to drive the
  *              lis3mdl enhanced inertial module.
  * @{
  *
  */

/**
  * @defgroup    LIS3MDL_Interfaces_Functions
  * @brief       This section provide a set of functions used to read and
  *              write a generic register of the device.
  *              MANDATORY: return 0 -> no Error.
  * @{
  *
  */

/**
  * @brief  Read generic device register
  *
  * @param  ctx   read / write interface definitions(ptr)
  * @param  reg   register to read
  * @param  data  pointer to buffer that store the data read(ptr)
  * @param  len   number of consecutive register to read
  * @retval       interface status (MANDATORY: return 0 -> no Error)
  *
  */
int32_t lis3mdl_read_reg(stmdev_ctx_t *ctx, uint8_t reg,
                         uint8_t *data,
                         uint16_t len)
{
  int32_t ret;

  ret = ctx->read_reg(ctx->handle, reg, data, len);

  return ret;
}

/**
  * @brief  Write generic device register
  *
  * @param  ctx   read / write interface definitions(ptr)
  * @param  reg   register to write
  * @param  data  pointer to data to write in register reg(ptr)
  * @param  len   number of consecutive register to write
  * @retval       interface status (MANDATORY: return 0 -> no Error)
  *
  */
int32_t lis3mdl_write_reg(stmdev_ctx_t *ctx, uint8_t reg,
                          uint8_t *data,
                          uint16_t len)
{
  int32_t ret;

  ret = ctx->write_reg(ctx->handle, reg, data, len);

  return ret;
}

/**
  * @}
  *
  */

/**
  * @defgroup    LIS3MDL_Sensitivity
  * @brief       These functions convert raw-data into engineering units.
  * @{
  *
  */

float_t lis3mdl_from_fs4_to_gauss(int16_t lsb)
{
  return ((float_t)lsb / 6842.0f);
}

float_t lis3mdl_from_fs8_to_gauss(int16_t lsb)
{
  return ((float_t)lsb / 3421.0f);
}

float_t lis3mdl_from_fs12_to_gauss(int16_t lsb)
{
  return ((float_t)lsb / 2281.0f);
}

float_t lis3mdl_from_fs16_to_gauss(int16_t lsb)
{
  return ((float_t)lsb / 1711.0f);
}

float_t lis3mdl_from_lsb_to_celsius(int16_t lsb)
{
  return ((float_t)lsb / 8.0f) + (25.0f);
}

/**
  * @}
  *
  */

/**
  * @defgroup    LIS3MDL_Data_Generation
  * @brief       This section group all the functions concerning
  *              data generation
  * @{
  *
  */

/**
  * @brief  Output data rate selection.[set]
  *
  * @param  ctx         read / write interface definitions(ptr)
  * @param  val         change the values of om in reg CTRL_REG1
  * @retval             interface status (MANDATORY: return 0 -> no Error)
  *
  */
int32_t lis3mdl_data_rate_set(stmdev_ctx_t *ctx, lis3mdl_om_t val)
{
  lis3mdl_ctrl_reg1_t ctrl_reg1;
  lis3mdl_ctrl_reg4_t ctrl_reg4;
  int32_t ret;

  ret = lis3mdl_read_reg(ctx, LIS3MDL_CTRL_REG1, (uint8_t *)&ctrl_reg1, 1);

  if (ret == 0)
  {
    ctrl_reg1.om = (uint8_t)val;
    ret = lis3mdl_write_reg(ctx, LIS3MDL_CTRL_REG1, (uint8_t *)&ctrl_reg1, 1);
  }

  if (ret == 0)
  {
    /* set mode also for z axis, ctrl_reg4 -> omz */
    ret = lis3mdl_read_reg(ctx, LIS3MDL_CTRL_REG4, (uint8_t *)&ctrl_reg4, 1);
  }

  if (ret == 0)
  {
    ctrl_reg4.omz = (uint8_t)(((uint8_t) val >> 4) & 0x03U);
    ret = lis3mdl_write_reg(ctx, LIS3MDL_CTRL_REG4,
                            (uint8_t *)&ctrl_reg4, 1);
  }

  return ret;
}
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
