cansat-tsniimash/UNKNOWN-2024/src/strela/StrelA-MS/source/data_widget.py

from PyQt5 import QtWidgets, QtGui, QtCore

from source import settings_control
import time


class DataWidget(QtWidgets.QTreeWidget):

    class AbstractTreeItem(QtWidgets.QTreeWidgetItem):
        background_color = QtGui.QColor('#000000')
        timeout_color = QtGui.QColor('#FF00FF')
        timer = None

        def set_background_color(self, background_color):
            self.background_color = background_color

        def setup_fields(self, group_name=None):
            if group_name is not None:
                self.setText(0, group_name)
                self.setText(1, '')

        def setup_background(self, color):
            for i in range(self.columnCount()):
                self.setBackground(i, color)

        def set_value(self, value):
            self.setup_background(self.background_color)
            self.setText(1, str(value))
            if self.timer is not None:
                self.timer.start()

        def get_value(self):
            return self.text(1)

        def setup_timeout(self, color, time_limit):
            self.timeout_color = color
            self.timer = QtCore.QTimer()
            self.timer.setSingleShot(True)
            self.timer.setInterval(int(time_limit * 1000))
            self.timer.timeout.connect(self.timeout_action)
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
