cansat-tsniimash/UNKNOWN-2024/(commit log)

2023-09-23 Создали репозиторий
    [10dof_imu_sensor.prt, air-valve.prt, akb_tbeacon.prt, antenna_2_4ghz.prt, antenna_gps-slim.prt, barometer_bmp280_module.prt, barometr-ms5611.prt, battery_li-pol_lp443442.prt]
2023-09-23 UNKNOWN 2024 НАЧАЛО КОНЦА
2023-09-23 сделал интересный и необычный датчик mq2))
2023-09-23 ПАХАЛ 6 ЧАСОВ, ДЕЛАЛ МОДЕЛМ ДАТЧИКОВ
2023-09-27 какие-то модели и сборка в крео
2023-09-27 какие-то модели и сборка в крео(и ещё чёто Ромино тут)
2023-09-30 я устал и хочу есть
2023-09-30 удалил дебаг хахаха он лох
2023-09-30 сделал больше, чем за прошлые 29 дней
    [gerobem.prt, granica.prt, mq2.prt, parasek.prt, ploskost.prt, pms9103m.prt, shashka.prt, tzt_sgp30.prt]
2023-09-30 СД РАБОТАЕТ УРААААА А ЕЩЕ У МЕНЯ НА ПК МИНЬЕН В ФОРМЕ БАРСЫ УРА
2023-10-04 ГПС РАБОТАЕТ НУ КУКИ ПОЙМАЛ ФИКСЫ НЕДАЛЕКО ЭЩКЕРЕЕ
2023-10-06 написал радио по жести хз работает или нет
2023-10-07 Добавила старую наземку в папку
2023-10-11 чето с наземкой сделал
2023-10-13 хз чо
2023-10-14 новая наземка
2023-10-21 сделал почвы
    [rs485.prt]
2023-10-21 ПОМЕНЯЛ SPI ОНО РАБОТАЕТ ЕЕЕЕЕЕ РОМА ЛОХ
2023-10-27 марина с машей чето сделали а я такой типа zzzzzzzz(сплю)
2023-10-27 забыл чё делал сорри
    [brusock.prt, granica.prt, pruzhina.prt, shashka.prt, stalnoy_sterzhen_6mm.prt, stalnoy_sterzhen_9mm.prt]
2023-10-27 начал делать конструкцию подъёмного механизма Артемий лох
    [apparat_skel.prt, krug_s_otverstiem.prt, prostavka.prt, sterzken.prt]
2023-10-28 добавил двойку в коде(сд не работало из за питания)
2023-10-28 я ничего не понимаю
    [apparat_skel.prt, krug_s_otverstiem.prt, prostavka.prt, prt0002.prt]
2023-11-01 чиню радио
2023-11-03 чето
2023-11-04 Добавил ину работает скорее всего правильно все по кайфу есть же ЭЩКЕРЕ
2023-11-05 начали моделить ветрогенератор
    [blin_s_otverstiem.prt, motor_dla_lopostei.prt, prt0002.prt, rs485.prt, skos_dla_motora.prt, windgen-vin.prt]
2023-11-08 Поменяла имя файла винта
    [windgen-vint.prt]
2023-11-08 я пока что ничё не сделал
    [mexanism_chtobu_cheka.prt, propeller_krutoi.prt]
2023-12-13 верх да
    [blin_s_otverstiem.prt, detal_dlya_raskritiya_parashuya.prt, krishka.prt, motor-1axis.prt, palka.prt, palka_dla_parashuta.prt, skos_dla_motora.prt, skos_dla_motora_niz.prt]
2023-12-13 Марина можно домой
    [18350.prt, beating.prt, blin_s_otverstiem.prt, derzhatel_kameru.prt, grib.prt, hc-06.prt, korpus.prt, kreplenie_kameri_2.prt]
2023-12-13 я хз чё это
2023-12-13 палка с дырками и кружок без дырок
2023-12-15 жёстко наработал целых 3 кружка и прикрепил на них модели
2023-12-16 патч на аппарат, добавили 15 новых моделей
    [4eto_niz_hz.prt, 74hc595t16.prt, buzzer.prt, dc-dc_1584.prt, noga.prt, palka_parashut.prt, platu.prt, radiator.prt]
2023-12-16 сделал верхний корпус
    [blin_verh.prt, detal_dla_pothipnika.prt, korpus.prt, korpus_niz.prt, korpus_verx.prt, krishka_akb.prt, niz_akb.prt, niz_raspberry.prt]
2023-12-20 ИЛЬЯ БЕЗДАРЬ
    [maya_palka_parashut.prt]
2023-12-22 Добавил колодки на платы
    [74hc595t16.prt, connector-pls-4.prt, dop_kolodka_1.prt]
2023-12-23 плата
    [plata_maket.prt]
2023-12-23 Разъемы smd
2023-12-23 Исправлены smd разъемы
    [pinhead_smd_female.prt, pinhead_smd_male.prt]
2023-12-23 Сделала сборку плат
2023-12-23 GPS теперь крепится на плату
2023-12-23 edxc ftnhju7mp;,.
    [akkb_18650.prt, bluetooth_hc-05.prt, dc_dc.prt, hc-06.prt, korpus_niz.prt, korpus_verx.prt, plata_maket.prt, tbeacon_onyx_925.prt]
2023-12-27 ПОКРАСИЛ ПЛАТЫ УРА
    [drw0001.dxf, plata_maket.dxf, plata_maket.prt]
2023-12-27 представте тут нормальное название комита
    [MK.brd, MK.sch]
2023-12-27 ещё более комитный комит
    [MK.brd, MK.sch]
2023-12-29 сделал механизмы
    [antenna_gps-slim.prt, blin_verh.prt, bluetooth_hc-05.prt, gps_antena.prt, korpus_niz.prt, korpus_verx.prt, plata_maket.prt, tkan.prt]
2023-12-30 новый год еееееееееееееееееееееееееееееееееееууууууууууууууууу
    [detal_dla_pothipnika.prt, grib.prt, korpus_niz.prt, korpus_verx.prt, microsd_connector_502774-0891.prt, plata_maket.prt, tkan.prt]
2024-01-07 доделали сборку, создали разнесенный вид оптического модуля
    [blin_verh.prt, cover.prt, detal_dla_pothipnika.prt, grib.prt, korpus.prt, korpus_niz.prt, korpus_verx.prt, kreplenie_kameri_2.prt]
2024-01-09 чёто сделал
    [2mm_sterzhen.prt, tkan.prt]
2024-01-10 вабулабудабдаб
    [2mm_sterzhen.prt, tkan.prt]
2024-01-17 всфывйцв
    [18350.prt, 2mm_sterzhen.prt, 74hc595t16.prt, akkb_18650.prt, beating.prt, blin_verh.prt, bme280_module.prt, connector-pls-4.prt]
2024-01-24 если у футболиста отобрать мяч он сменит профессию, если у художника отобрать кисть он захватит половину европы
    [tkan.prt]
2024-01-24 йцукенгшщзхъ
2024-01-31 Добавлена модель плана полета и файлы для презентации
    [parashut.prt, rocket.prt]
2024-01-31 падаби папирипупу пим папирипу
    [switch_right_mss12d01.prt, tkan.prt]
2024-01-31 ПОМЕЛО
    [MK.brd, MK.sch]
2024-01-31 добавил маджвик эщкерееее
    [kopia_litaka.stl, quat.csv]
2024-01-31 Добавлены файлы на ЗС
2024-02-01 Изменена модель и файлы ЗС
    [18350.prt, 2mm_sterzhen.prt, accum_18350.prt, accum_18650.prt, akkb_18650.prt, amplifier_xq-02a.prt, axe_2mm.prt, bearing.prt]
2024-02-02 сд чета какашка
2024-02-03 тат конкретный +вайб
2024-02-07 Добавлены УГО радио и разъемов радиолинии
    [MK.brd, MK.sch, RADIO.sch, axe_2mm.prt]
2024-02-07 шкибиди доп доп доп доп ес ес ес ес шкиб шкибиди дип шкибиди добиди добиди
    [pitanie.sch]
2024-02-07 Даня верни клей
    [RADIO.sch]
2024-02-07 Добавлен скрипт Маджвика с моделью
    [MK.sch, kopia_litaka.stl, quat.csv, quat1.csv]
2024-02-09 Добавлена плата питания
    [pitanie.brd, pitanie.sch]
2024-02-10 Добавлены контура плат
    [board.dxf, board_ears.dxf]
2024-02-10 Вабба Лабба Даб Даб
    [MK.brd, MK.sch, RADIO.sch]
2024-02-10 норм
2024-02-10 я смотрел рика и морти вместо работать
    [pitanie.brd, pitanie.sch]
2024-02-10 я тоже
    [MK.brd, MK.sch]
2024-02-14 ааа платы платы полигоны разводка платы ааааа
    [pitanie.brd, pitanie.sch]
2024-02-16 авыпльдыф
    [pitanie.brd, pitanie.sch]
2024-02-17 начало наземки
2024-02-17 добавлены смд разъемы для плат
2024-02-17 плата радио
    [RADIO.brd, RADIO.sch]
2024-02-17 разъемы смд
    [MK.brd, MK.sch]
2024-02-17 разъемы еще
    [MK.brd, MK.sch]
2024-02-20 изменил пару вещей в реале хз как
2024-02-21 кцуенгшщозлдх
    [RADIO.brd, RADIO.sch]
2024-02-21 плата МК под разводку
    [MK.brd, MK.sch]
2024-02-21 отртамгор
    [pitanie.brd, pitanie.sch]
2024-02-21 горншлщ90зд-жхэзжотрм с
    [RADIO.brd, RADIO.sch]
2024-02-21 рома гад смёрджил мой коммит :(
2024-02-21 плата рпарпарпараарпарпарпааарпарпарпауекуекуекусруркра
    [RADIO.brd, RADIO.sch]
2024-02-21 чучуть подправил норм
2024-02-23 'эщкере
2024-02-24 артемий сколько можно мерджить комиты зачем мы тогда стараемся над нашими шедевральными названиями
2024-02-24 когда фондю?
    [MK.brd, MK.sch]
2024-02-24 Добавлены разъемы на плату питания
    [pitanie.brd, pitanie.sch]
2024-02-24 плата питания удалена
    [pitanie.brd, pitanie.sch]
2024-02-24 плата питания возвращена
    [pitanie.brd, pitanie.sch]
2024-02-24 добавлены стл корпусных деталей
    [MK.brd, MK.csv, MK.sch, RADIO.brd, RADIO.csv, RADIO.sch, bearing_korpus.stl, bearing_shaft.stl]
2024-02-24 ывавп лыл
    [MK.brd, MK.sch, RADIO.brd, RADIO.sch]
2024-02-24 поменял пины создал функцию поворота
2024-02-25 Разведена плата питания
    [MK.brd, MK.sch, board.prt, board_ears_photo.dxf, board_restrict.dxf, cloth.prt, pitanie.brd, pitanie.sch]
2024-02-28 тцилизьм
2024-02-28 драйвер на шд кайф
2024-02-28 ждангнгорлек самолзшщапнготреап ияч пнгеапорвап тапоршл
    [connector_pbs-smd.prt, connector_pls-smd.prt, pitanie.brd, pitanie.csv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]
2024-02-29 Платы вроде готовы
    [MK.brd, MK.sch, RADIO.brd, RADIO.sch, pitanie.brd, pitanie.sch]
2024-02-29 буэээ
    [covers-connector.prt, covers-print.stl, korpus_bottom.prt, korpus_bottom.stl]
2024-03-01 raspberry and servo
2024-03-01 ййййййййййййййййййййййййййййййййййй
    [RADIO.brd, pitanie.brd, pitanie.sch]
2024-03-02 печать крышек
    [cover_korpus.prt, covers-connector.prt, covers-print.stl, korpus_bottom.prt, korpus_bottom.stl]
2024-03-02 сдклвл платы а мботрен зз
    [74hc595t16.prt, MK.brd, MK.sch, RADIO.brd, connector_b2b-eh-a.prt, ecap220-cmd.prt, svetoidiot0603.prt]
2024-03-02 чем гуще лес сел в машину и сгорел
    [bearing_korpus.prt, bearing_shaft.prt, dcdc_mt3608_usb.prt, nema8_reduct.prt, optical_base.prt, optical_base_accum.prt, optical_base_raspberry.prt, raspberry_pi_zero_2w.prt]
2024-03-02 шел по лесу медведь тем темнее чаща
2024-03-03 поправила платы
    [MK.brd, MK.sch, RADIO.brd, RADIO.sch, pitanie.brd, pitanie.sch]
2024-03-04 Модели поправлены в соответствии с платами
    [MK.brd, MK.sch, RADIO.brd, RADIO.sch, connector_pls-smd.prt, ecap220-cmd.prt, pitanie.brd, pitanie.sch]
2024-03-06 щдддоьблллсапмю.ю
    [korpus_bottom.prt]
2024-03-06 зделяльэпочамупробедненежимется оооооооо палучилось
    [korpus_top.prt]
2024-03-08 Я очень долго плакал
    [cloth.prt, korpus_bottom.prt, korpus_top.prt, stab_korpus.prt, stab_korpus2.stl]
2024-03-10 Оставьте korpus_top.prt на месте
    [korpus_top.prt]
2024-03-16 без труда то и пожнешь
2024-03-16 Наземка работает. Датчики BME, LSM и LIS - нет(
    [bearing_korpus.prt, bearing_korpus.stl, kernel_parashute.stl, korpus_base.prt, korpus_base.stl, korpus_bottom.prt, korpus_top.prt, korpus_top.stl]
2024-03-16 лропавыаполджоавпролдрРПАПРОЛД
    [axe_2mm.prt, banka_dla_sbrosa.prt, camera_base.prt, cloth.prt, detal_dla_sbrosa.prt, detal_dla_sbrosa2.prt]
2024-03-16 ДИРКА
    [cloth.prt, korpus_bottom.prt, korpus_top.prt]
2024-03-16 eщкере
2024-03-16 Поддержки оптического модуля
    [optical_base_accum.prt, optical_base_raspberry.prt]
2024-03-18 Печать нижнего корпуса и половинок оптического модуля.
    [korpus_bottom.prt, korpus_bottom.stl, optical_base_accum.prt, optical_base_accum.stl, optical_base_raspberry.prt, optical_base_raspberry.stl]
2024-03-20 наземка 16.03
2024-03-20 скибиди вапапапа скибиди вапапапапа скибиди вапапапапапапапа бум бум скибиди па па
2024-03-21 Теперь шаговик должен влезть
    [bearing_shaft.prt, bearing_shaft.stl, korpus_base.prt, korpus_base.stl, korpus_bottom.prt, ring_down.stl, ring_up.stl]
2024-03-23 блин я одну запятую забыл убрать
2024-03-23 прием блютуз
2024-03-23 отправка блютуз и рабочее бме
2024-03-30 нижний корпус повернут в нужное положение
    [korpus_bottom.prt, parapat_RUS.xls]
2024-04-01 поправила все
    [cloth.prt, cover_accum.prt, cover_accum.stl, korpus_bottom.prt, korpus_bottom.stl, korpus_top.prt, korpus_top.stl, optical_base_accum.prt]
2024-04-05 я сам не понял чё я написал
2024-04-05 пакеты изменил
2024-04-06 уаношлщд
    [bearing_korpus.prt, korpus_top.prt, stab_korpus.prt]
2024-04-09 stl korpus_top
    [korpus_top.stl]
2024-04-10 шд работает и фоторезистор тоже
2024-04-12 блин
    [cover_accum.prt, optical_base_accum.prt]
2024-04-12 ееее
2024-04-13 Крышка аккума должна быть норм
    [cover_accum.prt, cover_accum.stl, korpus_bottom.prt, korpus_top.prt, optical_base_accum.prt, optical_base_accum.stl]
2024-04-13 АААААААААА
2024-04-13 гшвфуп78уф
    [detal_dla_sbrosa_2.prt, optical_base_accum.prt, optical_base_raspberry.prt]
2024-04-16 модель оптического отсека с переключателем
    [kernel_parashute.prt, kernel_parashute.stl, optical_base_raspberry.prt, optical_base_raspberry.stl, switch_sk12f14.prt]
2024-04-19 БББББББББББББББББББ
    [bearing.prt, bearing_korpus.prt, bearing_shaft.prt, board.prt, camera_rasberry.prt, cansat.stl, cover_accum.prt, cover_korpus.prt]
2024-04-19 чиназес
2024-04-20 пищалка и переключатель работают начал работу с маджвиком и матрицами
2024-04-23 стл распберри с гайками
    [cloth.prt, optical_base_raspberry.prt, optical_base_raspberry.stl]
2024-05-06 Добавлен пережигатель, платы повернуты на 90 градусов из-за разъемов
    [bearing_korpus.prt, bearing_korpus.stl, connector_pbs-smd.prt, korpus_base.prt, korpus_base.stl, korpus_bottom.prt, korpus_bottom.stl, korpus_top.prt]
2024-05-10 ну ёмаё
    [CanCubeSat-2-for-GKS.stl, CanCubeSat-for-GKS.stl, axis.stl, knpn.stl]
2024-05-11 текущая прошивка
2024-05-11 игагшптдшгщщщщщщщщщщ
    [cansat.stl, knpn.stl]
2024-05-17 видео норм
2024-05-17 ещкере
2024-05-17 полный эщкере
2024-05-30 гедагади гедагеда го а бин мерит а лон тайм аго
    [korpus_top.prt]
2024-05-30 печать верхнего корпуса, отверстия перенесены
    [korpus_top.prt, korpus_top.stl]
2024-06-01 ывапрлджэ
    [camera_base.prt, optical_base.prt, optical_base.stl]
2024-06-03 печать optical_base
    [optical_base.prt, optical_base.stl]
2024-06-05 он вечно все путает он путает все на свету и во тьме он говорит что кажется что что то перепутал и все его любят этого mister Jonson...
2024-06-07 ну чето сделал
2024-06-08 запись fix на СД, гпс работает, радио перестало
    [optical_base.prt, optical_base.stl]
2024-06-08 гпс и радио работают
2024-06-12 серва должна работать
2024-06-15 пук пук
2024-06-19 4 пакета + 1 бинарник. Надо ускорять радио
2024-06-20 и еще
2024-06-20 1 сторчка
2024-06-22 начали парсер
    [knpn_1.csv, knpn_2.csv, knpn_3.csv, knpn_4.csv, Обработка телеметрии.xlsx]
2024-06-22 парсер и ещё какие то штуки которые я наверное должен был закомитить уже давным давно и может быть от этого у вас что-нибудь сломается, но откатите если что так что ничего страшного лол
    [knpn_1.csv, knpn_2.csv, knpn_3.csv, knpn_4.csv]
2024-06-22 куыенпгршо
    [optical_base.prt, optical_base_accum.prt, optical_base_raspberry.prt]
2024-06-25 я стоко всего сделал ну стоко это просто жесть у нас теперь работает парсер... ну не то что бы он и раньше не работал, но до этого он не считал контрольную сумму пакетов, а сейчас он её считает. Наве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
    [1.csv, 1_knpn20240625T164222.csv, 2.csv, 2_knpn20240625T164222.csv, 3.csv, 3_knpn20240625T164222.csv, 4.csv, 4_knpn20240625T164222.csv]
2024-06-26 а не, ошибся чёт
2024-06-26 чёт сделал
2024-06-26 Сделал программу, которая симулирует исправный приём телеметрии(на запусках пригодится)
    [StrelA_MS_KNPN.yaml, main.py]
2024-06-26 пакеты пакетики пакеточички пакетусики packets
    [Обработка телеметрии.xlsx]
2024-06-27 магнитометр правильный на земле
2024-06-28 поменял 1 цифру
2024-06-29 time_s и time_us по гпс надо писать в пакет, а не только в переменную, Артемий!!! А размер time_us 4 байта, а не 8, Артемий!!! Размер пакетов до 32 байт, а не 35, Артемий!!!
2024-06-29 Commit Message
    [File.csv, packet1.csv, packet2.csv, packet3.csv, quaternion.csv, План-график.xlsx]
2024-06-29 забыли
    [Обработка телеметрии.xlsx]
2024-06-29 список
    [список.xlsx]
2024-06-30 добавлен пакет с вектором и углами
2024-06-30 Маленький бой варнингам и другая система частотной отправки телеметрии
2024-06-30 в обработке свежая телеметрия + добавлен пакет с вектором и углами
    [1_knpn20240630T164203.csv, 1_knpn20240630T165237.csv, 2_knpn20240630T164203.csv, 2_knpn20240630T165237.csv, 3_knpn20240630T164203.csv, 3_knpn20240630T165237.csv, 4_knpn20240630T164203.csv, 4_knpn20240630T165237.csv]
2024-07-01 gcs тоже надо менять, Илья!!!
2024-07-03 если кому интересно я помылся
2024-07-04 ой забыл
2024-07-04 вкусняшка
    [1_knpn20240704T120745.csv, 2_knpn20240704T120745.csv, 3_knpn20240704T120745.csv, 4_knpn20240704T120745.csv, 5_knpn20240704T120745.csv]
